zscircuits/zs1100a/Hardware/PCB/Gerber/ASSY/PCB-3D.jpg

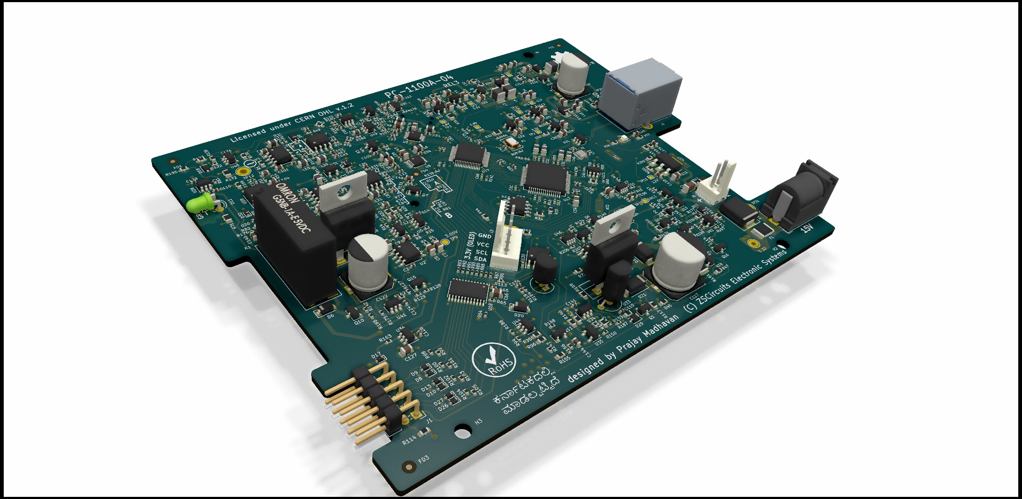
Hardware/PCB/Gerber/ASSY/PCB-3D.jpg
