zscircuits/zs1100a/Hardware/Enclosure/ReadMe.txt

Notes : 
1. The enclosure for the ZS1100A is designed using LibreCAD
2. The part used is a standard aluminum entrusion box from SZOMK with part No AK-C-C28
3. The front and back panels are cut using the .dxf file.
4. The logo is embossed on the top and bottom sides.
