zscircuits/zs1100a/Hardware/FTDI/ReadMe.txt

The template provided here can be used to program the EEPROM on the PC-1100-A PCB.
The FT_PROG utility from FTDI can be used to program the EEPROM using the template.
The template works only for a FT2232H device
