zscircuits/zs1100a/Docs/Certifications/ZS-1100-A-Conducted-Emissions-zsc-25-11-20-L.PDF

## PMM NARDA REPORT: zsc-25-11-20

************ Header Text ***************

Report issuing date : --/--/---- (dd/mm/yyyy)

Temperature | : --- °C
Humidity | : --- %

EUT
Manufacturer | :
Model | :
S/N | :
Notes | :

Testing Company
Address | :
Tel./Fax | :
E-mail | :
Web site | :
Operator | :

Receiver Details
Model | :
Brand | :
S/N | :
Last Calibration | :

Ancillary Details
Model | :
Brand | :
S/N | :
Last Calibration | :

************ End of Header ***************

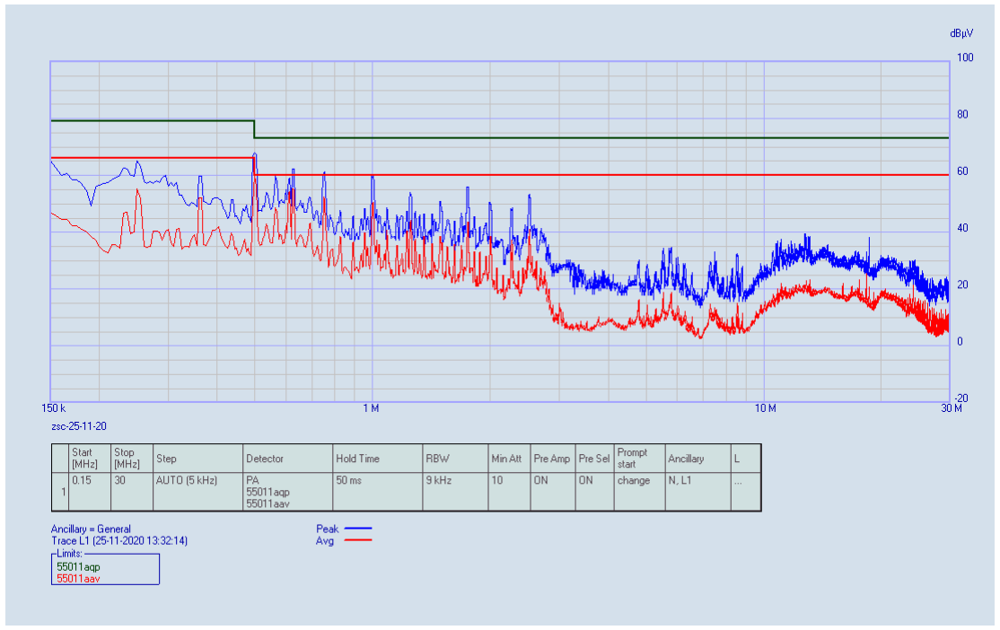
[picture p6: figure]

zsc-25-11-20 (L1) 25-11-2020 13:32:14 Rel. SW 2.37 (June 2019)
Rel. FW 2.64 23/08/18
Frequency | Peak | Avg
[MHz] | [dBµV] | [dBµV]
0.15 | 64.99 | 46.70
0.155 | 62.58 | 45.91
0.16 | 60.05 | 44.67
0.165 | 60.68 | 44.61
0.17 | 58.36 | 42.45
0.175 | 58.61 | 42.17
0.18 | 57.16 | 40.93
0.185 | 54.79 | 40.06
0.19 | 49.31 | 38.56
0.195 | 55.79 | 37.14
0.2 | 56.71 | 34.98
0.205 | 57.12 | 33.36
0.21 | 57.57 | 32.70
0.215 | 58.34 | 35.57
0.22 | 59.05 | 35.67
0.225 | 59.92 | 34.40
0.23 | 62.50 | 46.70
0.235 | 62.19 | 47.16
0.24 | 60.11 | 39.57
0.245 | 59.65 | 40.16
0.25 | 65.19 | 55.16
0.255 | 63.17 | 51.85
0.26 | 57.82 | 35.08
0.265 | 57.21 | 34.78
0.27 | 57.81 | 35.04
0.275 | 57.27 | 40.55
0.28 | 58.17 | 40.36
0.285 | 57.58 | 40.03
0.29 | 59.04 | 37.25
0.295 | 60.22 | 40.33
0.3 | 56.22 | 40.89
0.305 | 57.56 | 36.24
0.31 | 56.28 | 34.97
0.315 | 57.55 | 41.04
0.32 | 53.09 | 41.22
0.325 | 53.09 | 34.13
0.33 | 50.98 | 34.98
0.335 | 49.67 | 34.89
0.34 | 49.17 | 34.84
0.345 | 50.63 | 37.92
0.35 | 49.88 | 39.25
0.355 | 48.98 | 35.34
0.36 | 59.77 | 52.23
0.365 | 59.80 | 52.19
0.37 | 50.74 | 35.53
0.375 | 50.59 | 35.29
0.38 | 49.85 | 36.67
0.385 | 50.07 | 38.52
0.39 | 51.95 | 40.73
0.395 | 52.23 | 40.83
0.4 | 52.18 | 41.29
0.405 | 51.81 | 41.94
0.41 | 51.11 | 37.86
0.415 | 48.30 | 36.83
0.42 | 47.83 | 35.40
0.425 | 45.00 | 34.40
0.43 | 45.64 | 35.93

0.435 | 51.65 | 39.80
0.44 | 51.53 | 38.13
0.445 | 45.50 | 34.01
0.45 | 45.87 | 34.39
0.455 | 44.56 | 31.87
0.46 | 43.03 | 32.63
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
29.935 | 18.19 | 4.72
29.94 | 17.03 | 4.98
29.945 | 17.03 | 4.90
29.95 | 18.20 | 5.11
29.955 | 17.04 | 4.81
29.96 | 17.04 | 4.93
29.965 | 19.22 | 4.99
29.97 | 20.15 | 5.01
29.975 | 20.98 | 8.35
29.98 | 18.21 | 7.40
29.985 | 17.06 | 5.80
29.99 | 19.24 | 6.08
29.995 | 19.24 | 8.61
30 | 19.25 | 8.31
