zscircuits/zs1100a/Docs/Certifications/ZS-1100-A-Conducted-Emissions-zsc-25-11-20-N.PDF

## PMM NARDA REPORT: zsc-25-11-20

************ Header Text ***************

Report issuing date : --/--/---- (dd/mm/yyyy)

Temperature | : --- °C
Humidity | : --- %

EUT
Manufacturer | :
Model | :
S/N | :
Notes | :

Testing Company
Address | :
Tel./Fax | :
E-mail | :
Web site | :
Operator | :

Receiver Details
Model | :
Brand | :
S/N | :
Last Calibration | :

Ancillary Details
Model | :
Brand | :
S/N | :
Last Calibration | :

************ End of Header ***************

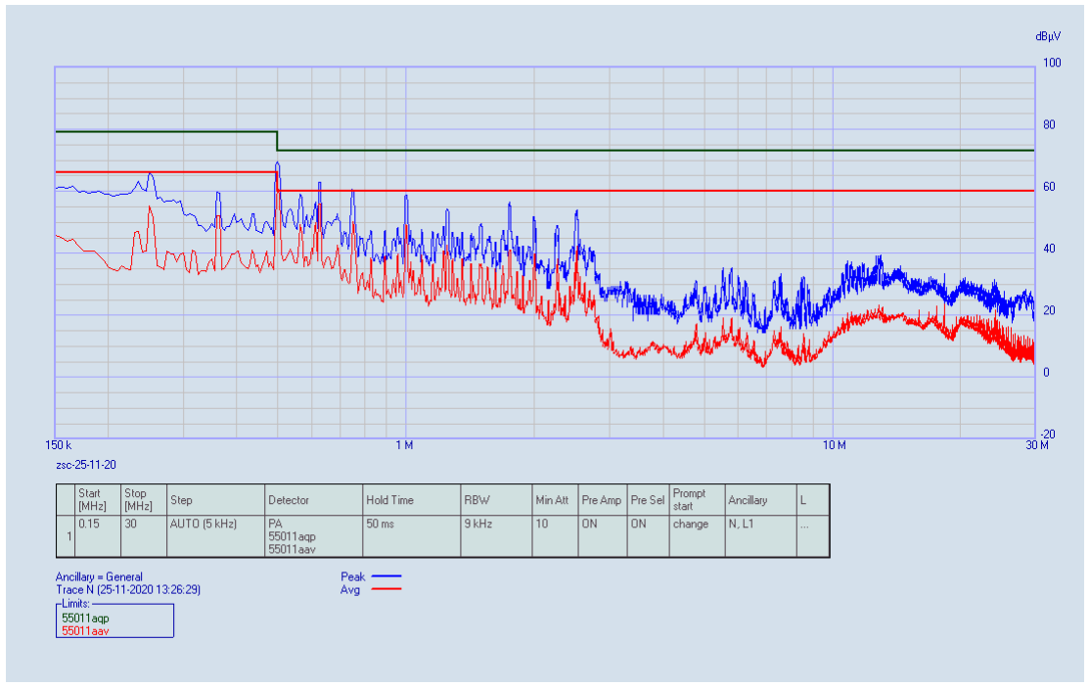
[picture p7: figure]

zsc-25-11-20 (N) 25-11-2020 13:26:29 Rel. SW 2.37 (June 2019)
Rel. FW 2.64 23/08/18
Frequency | Peak | Avg
[MHz] | [dBµV] | [dBµV]
0.15 | 60.93 | 45.91
0.155 | 61.37 | 45.27
0.16 | 61.17 | 43.98
0.165 | 61.50 | 44.68
0.17 | 59.70 | 42.23
0.175 | 60.21 | 40.60
0.18 | 59.34 | 40.73
0.185 | 59.90 | 40.67
0.19 | 60.20 | 39.22
0.195 | 59.17 | 37.40
0.2 | 59.16 | 35.53
0.205 | 58.63 | 34.61
0.21 | 58.85 | 34.37
0.215 | 59.26 | 35.82
0.22 | 59.25 | 35.12
0.225 | 59.50 | 34.71
0.23 | 61.14 | 46.82
0.235 | 63.19 | 46.94
0.24 | 60.54 | 40.41
0.245 | 60.22 | 40.61
0.25 | 66.45 | 55.29
0.255 | 64.58 | 51.43
0.26 | 57.63 | 35.95
0.265 | 58.28 | 35.59
0.27 | 56.68 | 34.76
0.275 | 57.00 | 40.83
0.28 | 56.88 | 39.92
0.285 | 57.32 | 39.81
0.29 | 56.37 | 37.12
0.295 | 56.94 | 39.74
0.3 | 52.84 | 40.20
0.305 | 52.28 | 34.67
0.31 | 52.83 | 33.68
0.315 | 52.61 | 40.97
0.32 | 51.83 | 40.54
0.325 | 49.11 | 33.18
0.33 | 49.10 | 34.38
0.335 | 47.92 | 34.52
0.34 | 47.21 | 34.14
0.345 | 48.11 | 37.31
0.35 | 49.73 | 38.27
0.355 | 48.46 | 34.31
0.36 | 59.64 | 52.08
0.365 | 59.48 | 52.12
0.37 | 48.71 | 34.60
0.375 | 47.38 | 35.38
0.38 | 48.61 | 36.25
0.385 | 48.69 | 37.93
0.39 | 50.36 | 39.73
0.395 | 52.74 | 39.67
0.4 | 50.06 | 40.51
0.405 | 50.27 | 40.86
0.41 | 51.11 | 36.82
0.415 | 49.17 | 36.26
0.42 | 48.30 | 35.68
0.425 | 47.43 | 35.10
0.43 | 48.56 | 36.80

0.435 | 52.70 | 40.95
0.44 | 52.65 | 39.33
0.445 | 47.31 | 35.66
0.45 | 47.21 | 36.14
0.455 | 46.66 | 33.68
0.46 | 46.44 | 35.49
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
29.935 | 21.71 | 4.89
29.94 | 21.71 | 5.20
29.945 | 21.71 | 5.21
29.95 | 23.06 | 4.83
29.955 | 22.42 | 5.07
29.96 | 22.42 | 5.39
29.965 | 21.72 | 5.20
29.97 | 21.73 | 4.96
29.975 | 22.43 | 5.49
29.98 | 21.73 | 5.44
29.985 | 22.44 | 6.06
29.99 | 21.74 | 7.41
29.995 | 23.08 | 8.33
30 | 23.09 | 8.94
