zscircuits/zs1100a/Hardware/PCB/SCH-BOM-ASSY/PC-1100X-SCH.pdf

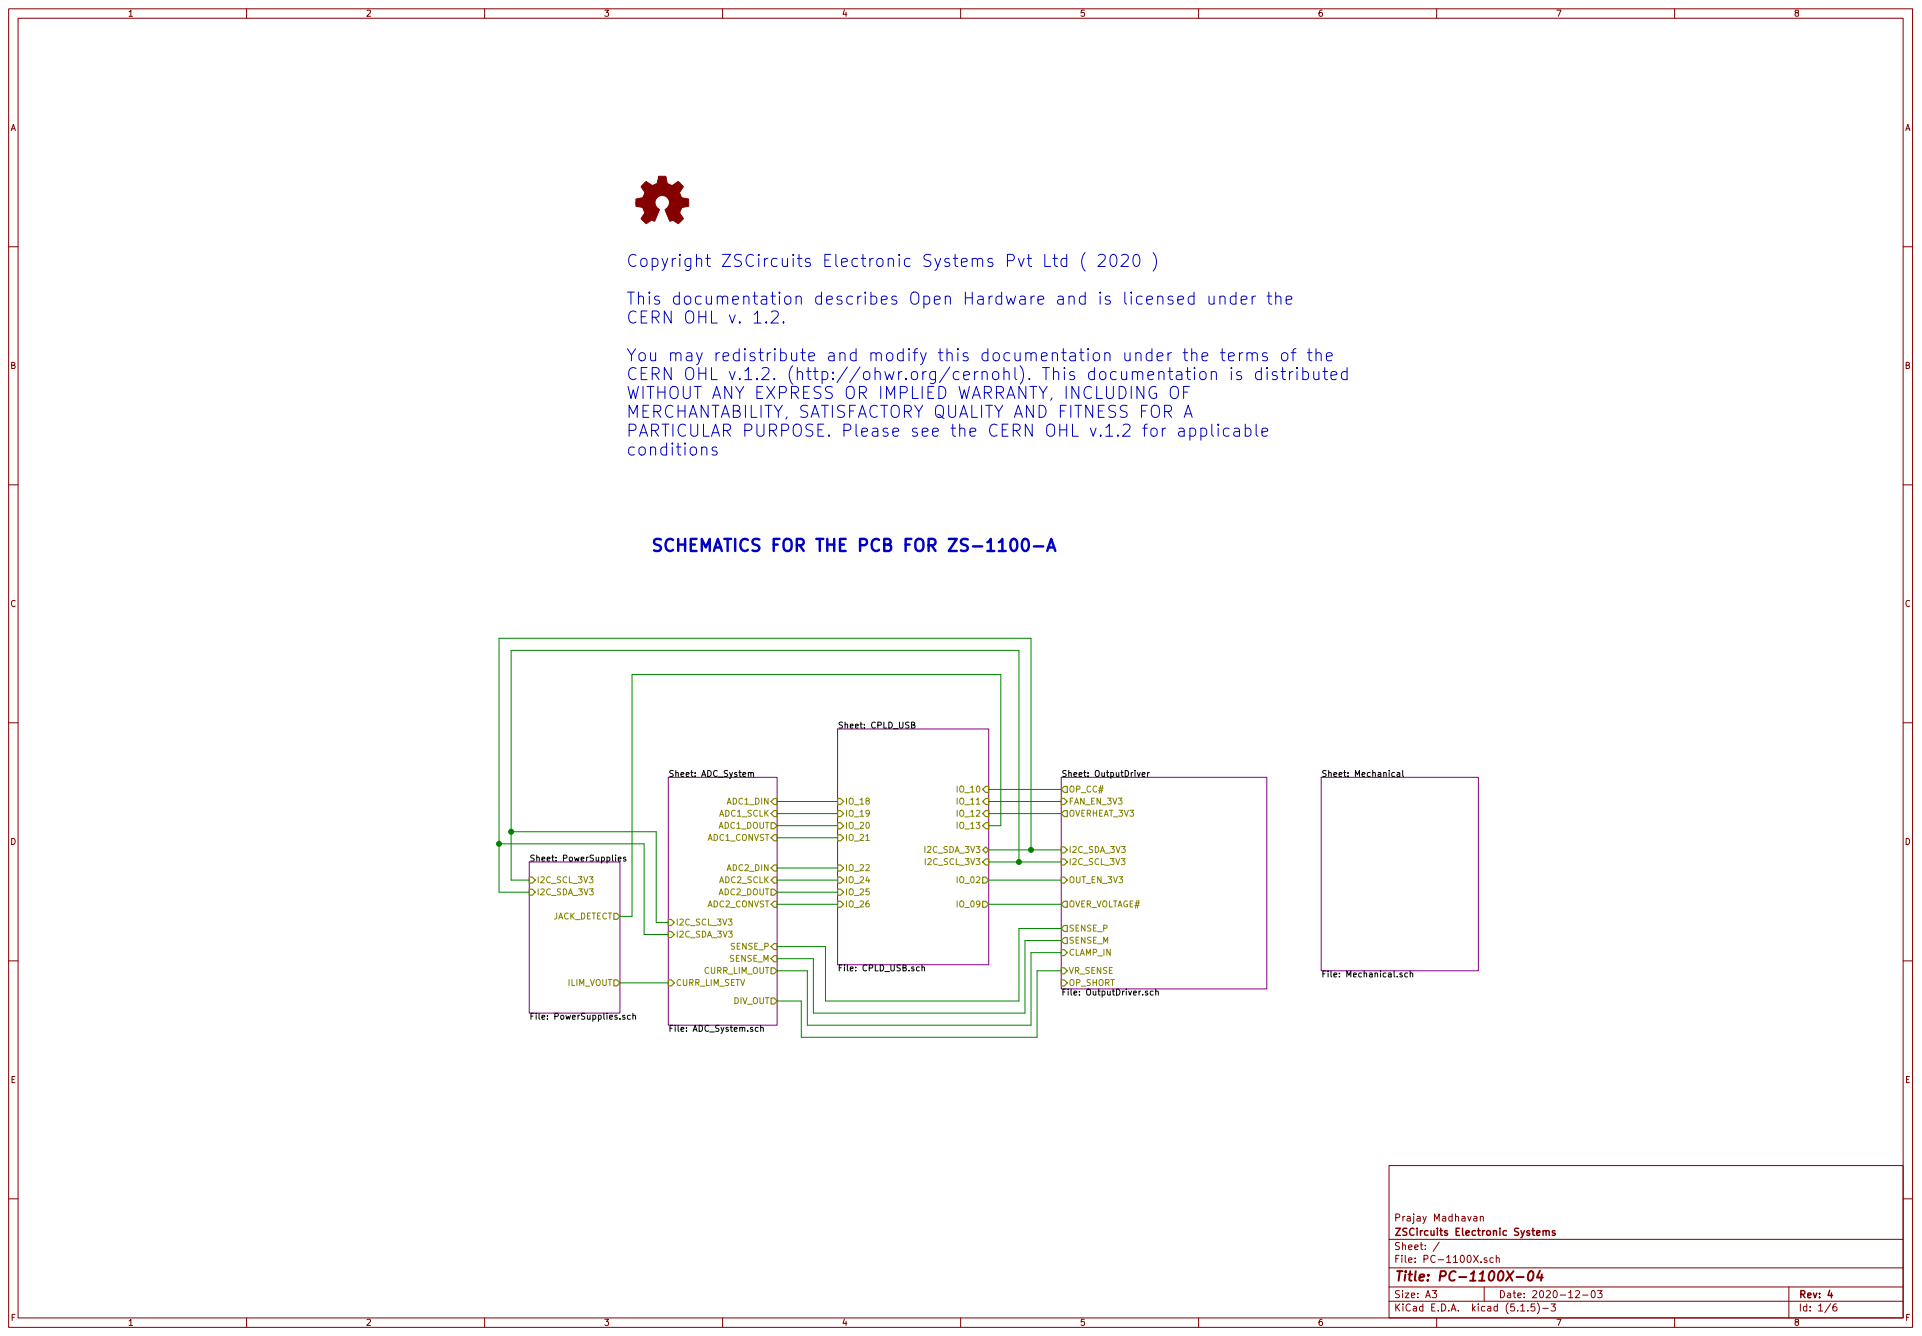
[picture p8: page 1]

I2C_SDA_3V3 DIV_OUT Copyright ZSCircuits Electronic Systems Pvt Ltd ( 2020 )

This documentation describes Open Hardware and is licensed under the
CERN OHL v. 1.2.

You may redistribute and modify this documentation under the terms of the
CERN OHL v.1.2. (http://ohwr.org/cernohl). This documentation is distributed
WITHOUT ANY EXPRESS OR IMPLIED WARRANTY, INCLUDING OF
MERCHANTABILITY, SATISFACTORY QUALITY AND FITNESS FOR A
PARTICULAR PURPOSE. Please see the CERN OHL v.1.2 for applicable
conditions

SCHEMATICS FOR THE PCB FOR ZS-1100-A

Prajay Madhavan
File: PC-1100X.sch Sheet: / ZSCircuits Electronic Systems

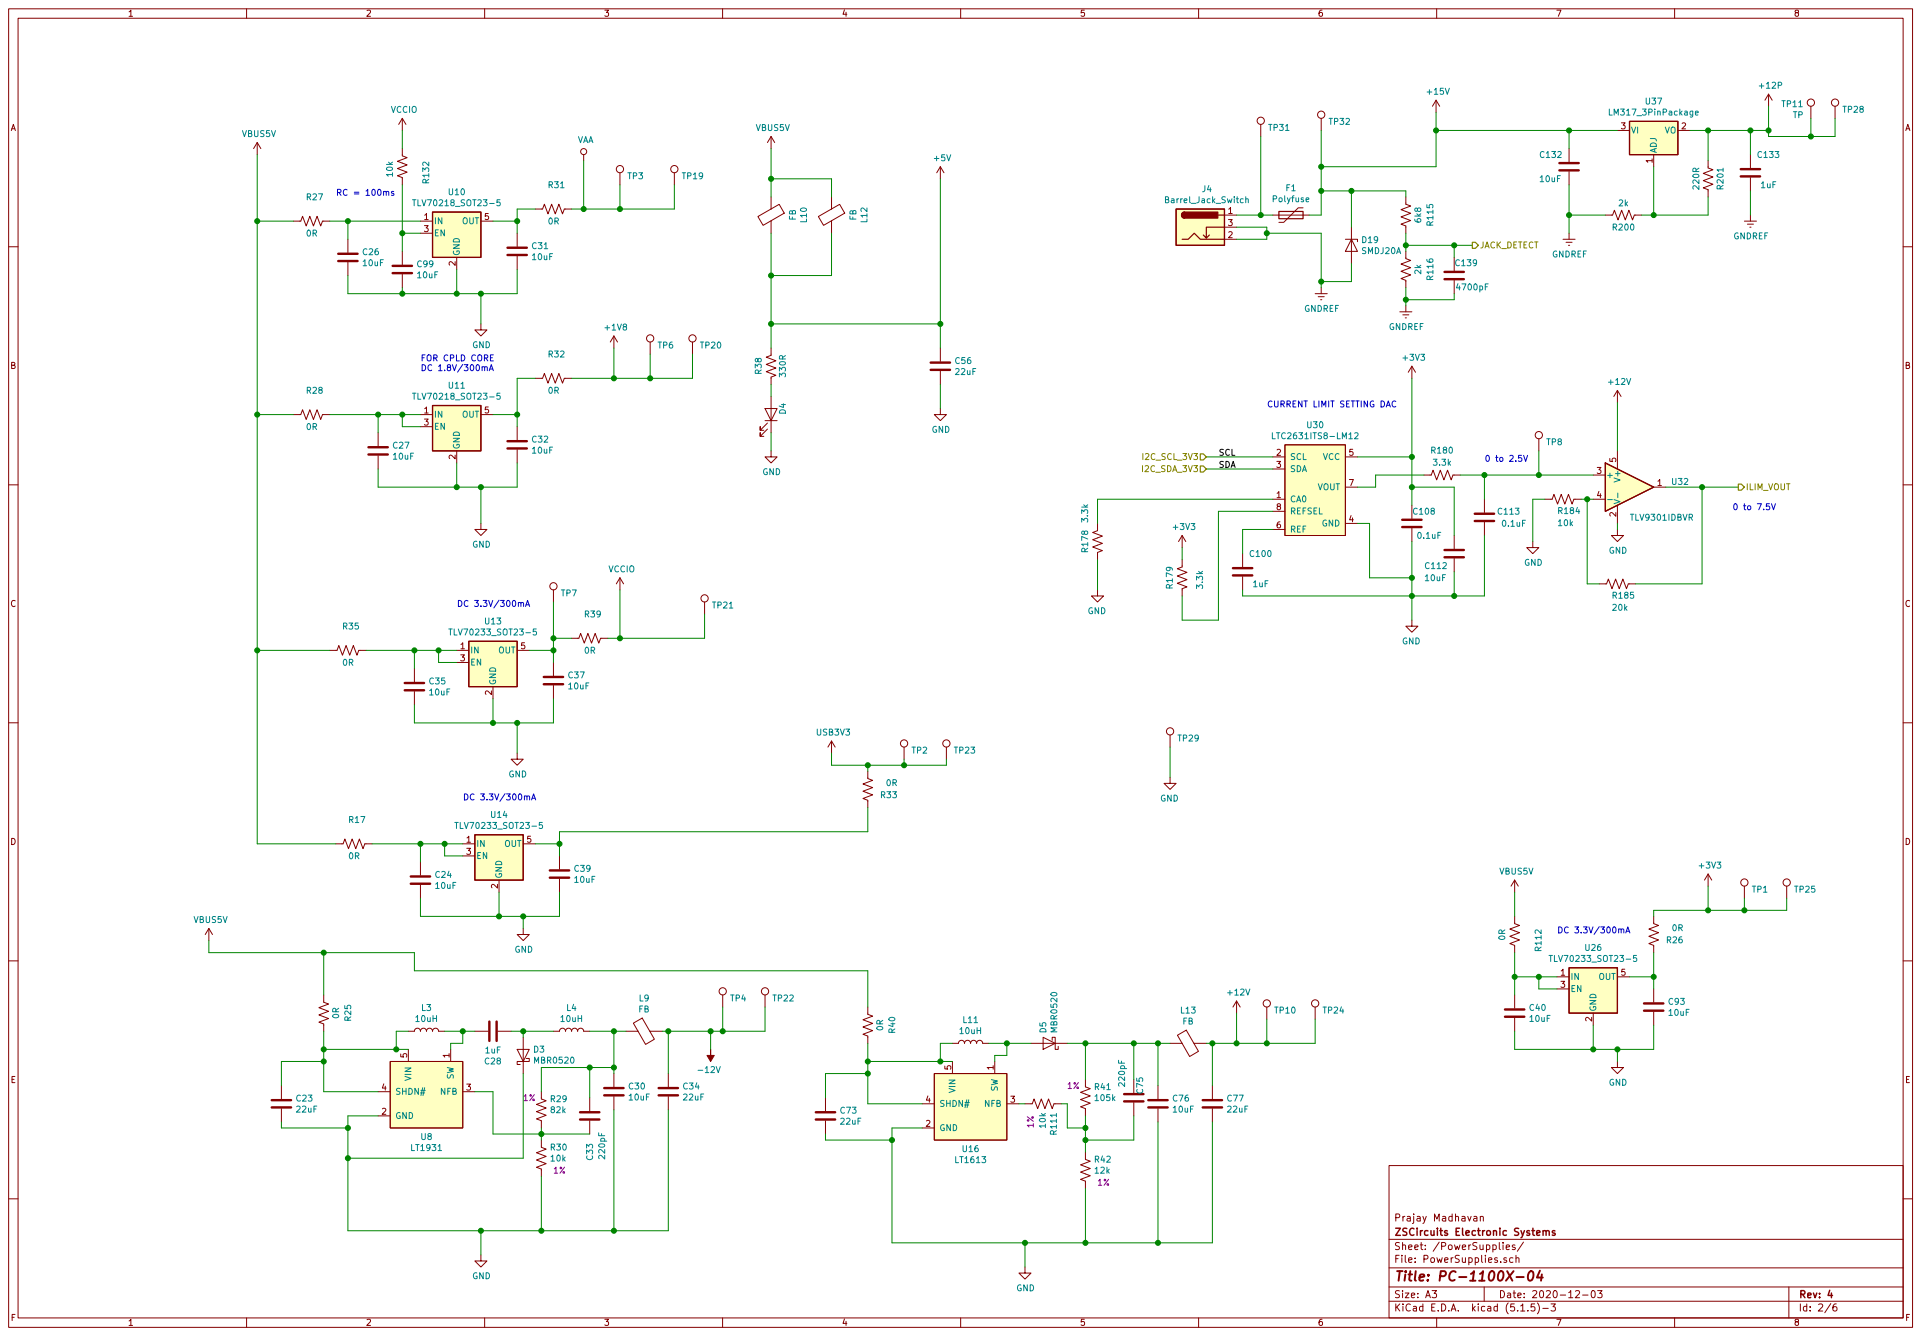
[picture p9: page 2]

1 GND 2 NFB 3 SHDN# 4 VIN

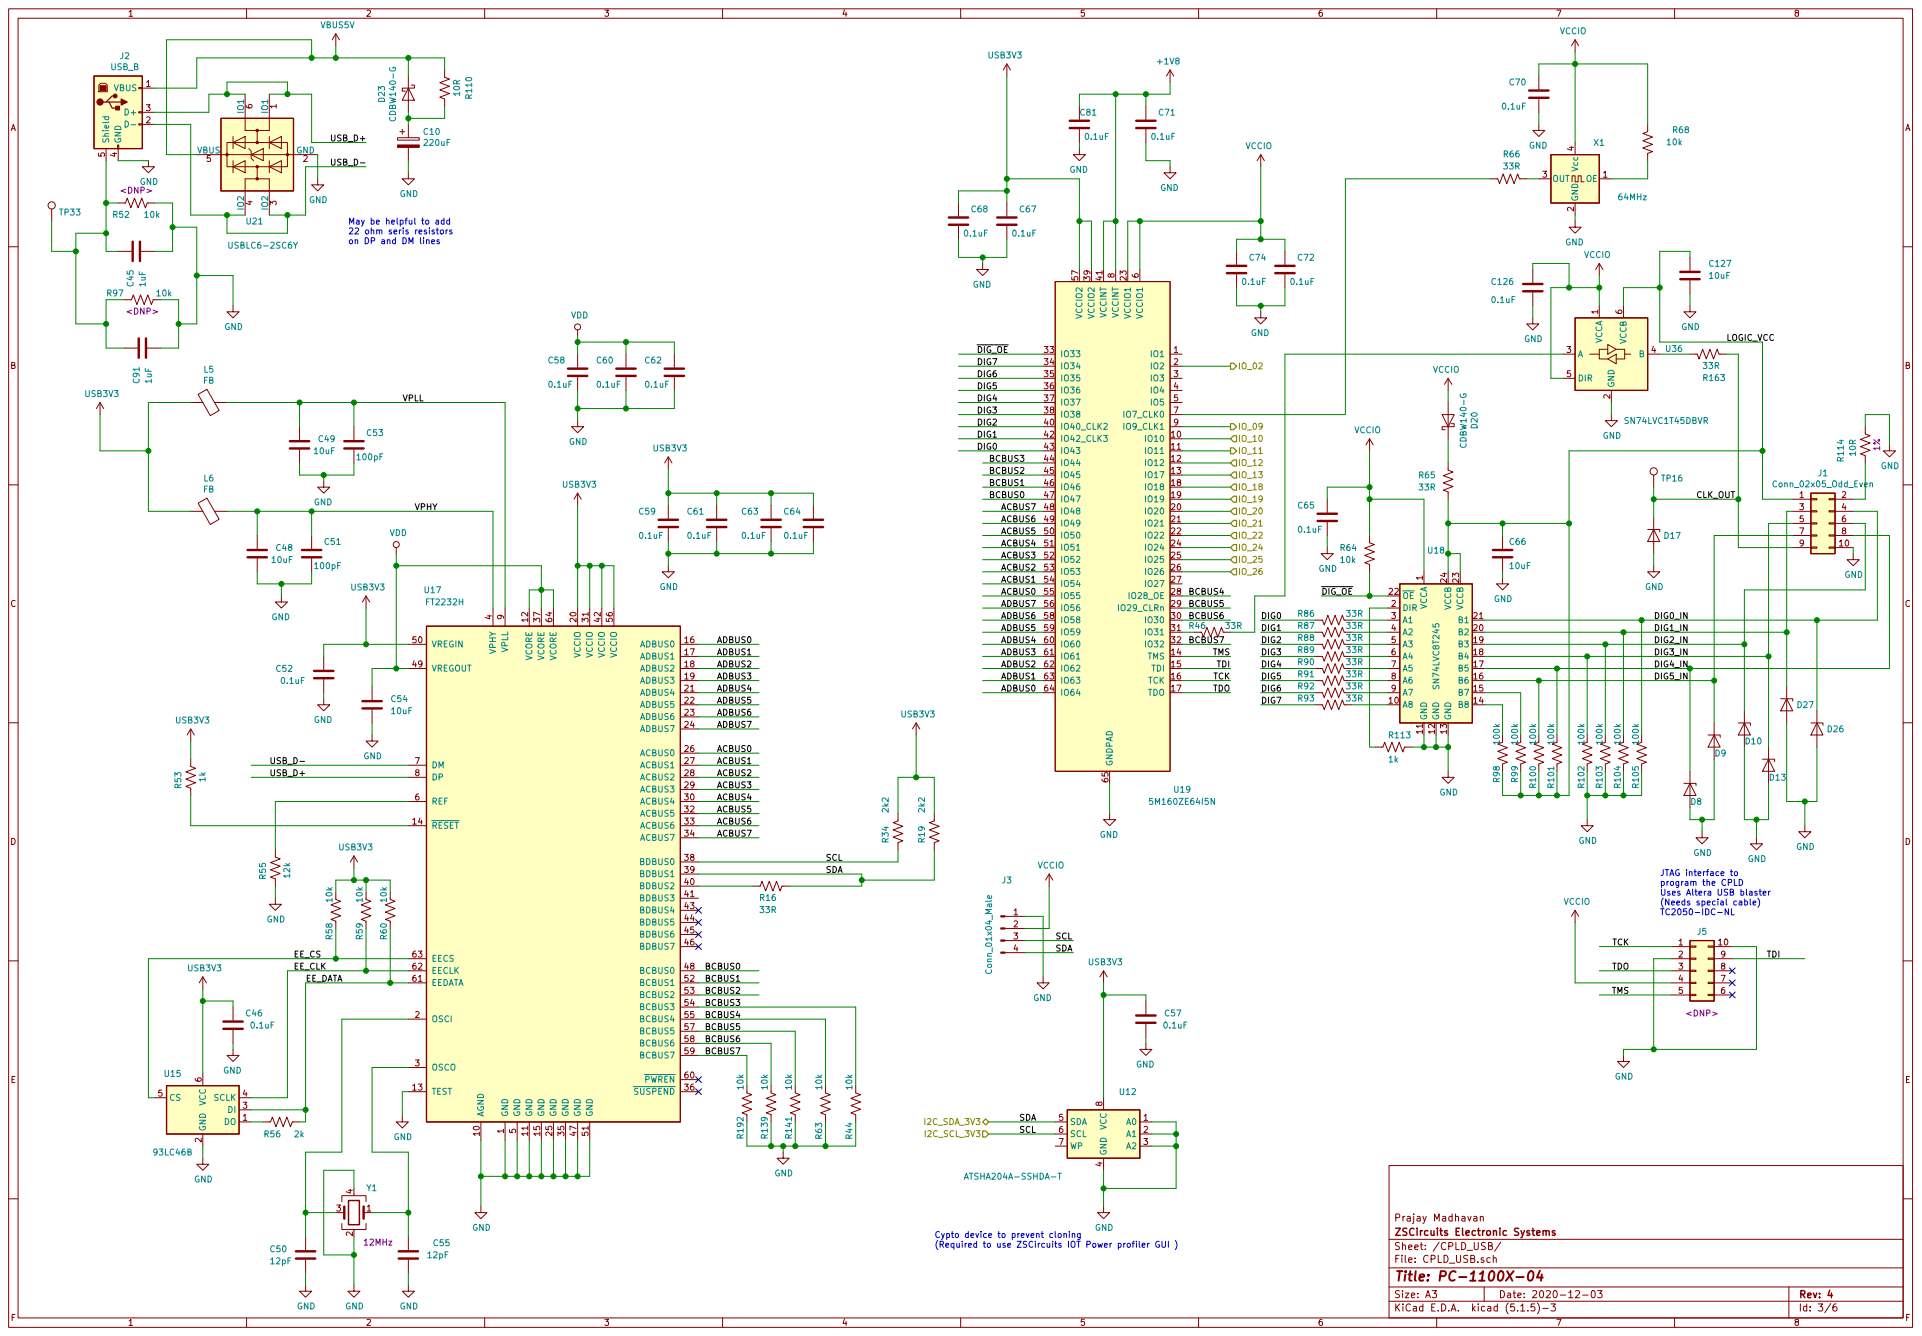
[picture p10: page 3]

May be helpful to add
22 ohm seris resistors on DP and DM lines

1 A8 10 GND 11 GND 12 GND 13 B8 14 B7 15 B6 16 B5 17 B4 18 B3 19 DIR 2 B2 20 B1 21 OE 22 VCCB 23 VCCB 24 A1 3 A2 4 A3 5 A4 6 A5 7 A6 8 A7 9 U18SN74LVC8T245

1 AGND 10 GND 11 VCORE 12 TEST 13 RESET 14 GND 15 ADBUS0 16 ADBUS1 17 ADBUS2 18 ADBUS3 19 OSCI 2 VCCIO 20 ADBUS4 21 ADBUS5 22 ADBUS6 23 ADBUS7 24 GND 25 ACBUS0 26 ACBUS1 27 ACBUS2 28 ACBUS3 29 OSCO 3 ACBUS4 30 VCCIO 31 ACBUS5 32 ACBUS6 33 ACBUS7 34 GND 35 SUSPEND 36 VCORE 37 BDBUS0 38 BDBUS1 39 VPHY

4 BDBUS2 40 BDBUS3 41 VCCIO 42 BDBUS4 43 BDBUS5 44 BDBUS6 45 BDBUS7 46 GND 47 BCBUS0 48 VREGOUT 49 GND

5 VREGIN 50 GND 51 BCBUS1 52 BCBUS2 53 BCBUS3 54 BCBUS4 55 VCCIO 56 BCBUS5 57 BCBUS6 58 BCBUS7 59 REF 6 PWREN 60 EEDATA 61 EECLK 62 EECS 63 VCORE 64 DM 7 DP 8 VPLL

JTAG interface to program the CPLD

Uses Altera USB blaster
(Needs special cable) TC2050-IDC-NL

2 DI 3 SCLK 4 CS 5 VCC

4 SDA 5 SCL 6 WP 7 VCC

Cypto device to prevent cloning
(Required to use ZSCircuits IOT Power profiler GUI )

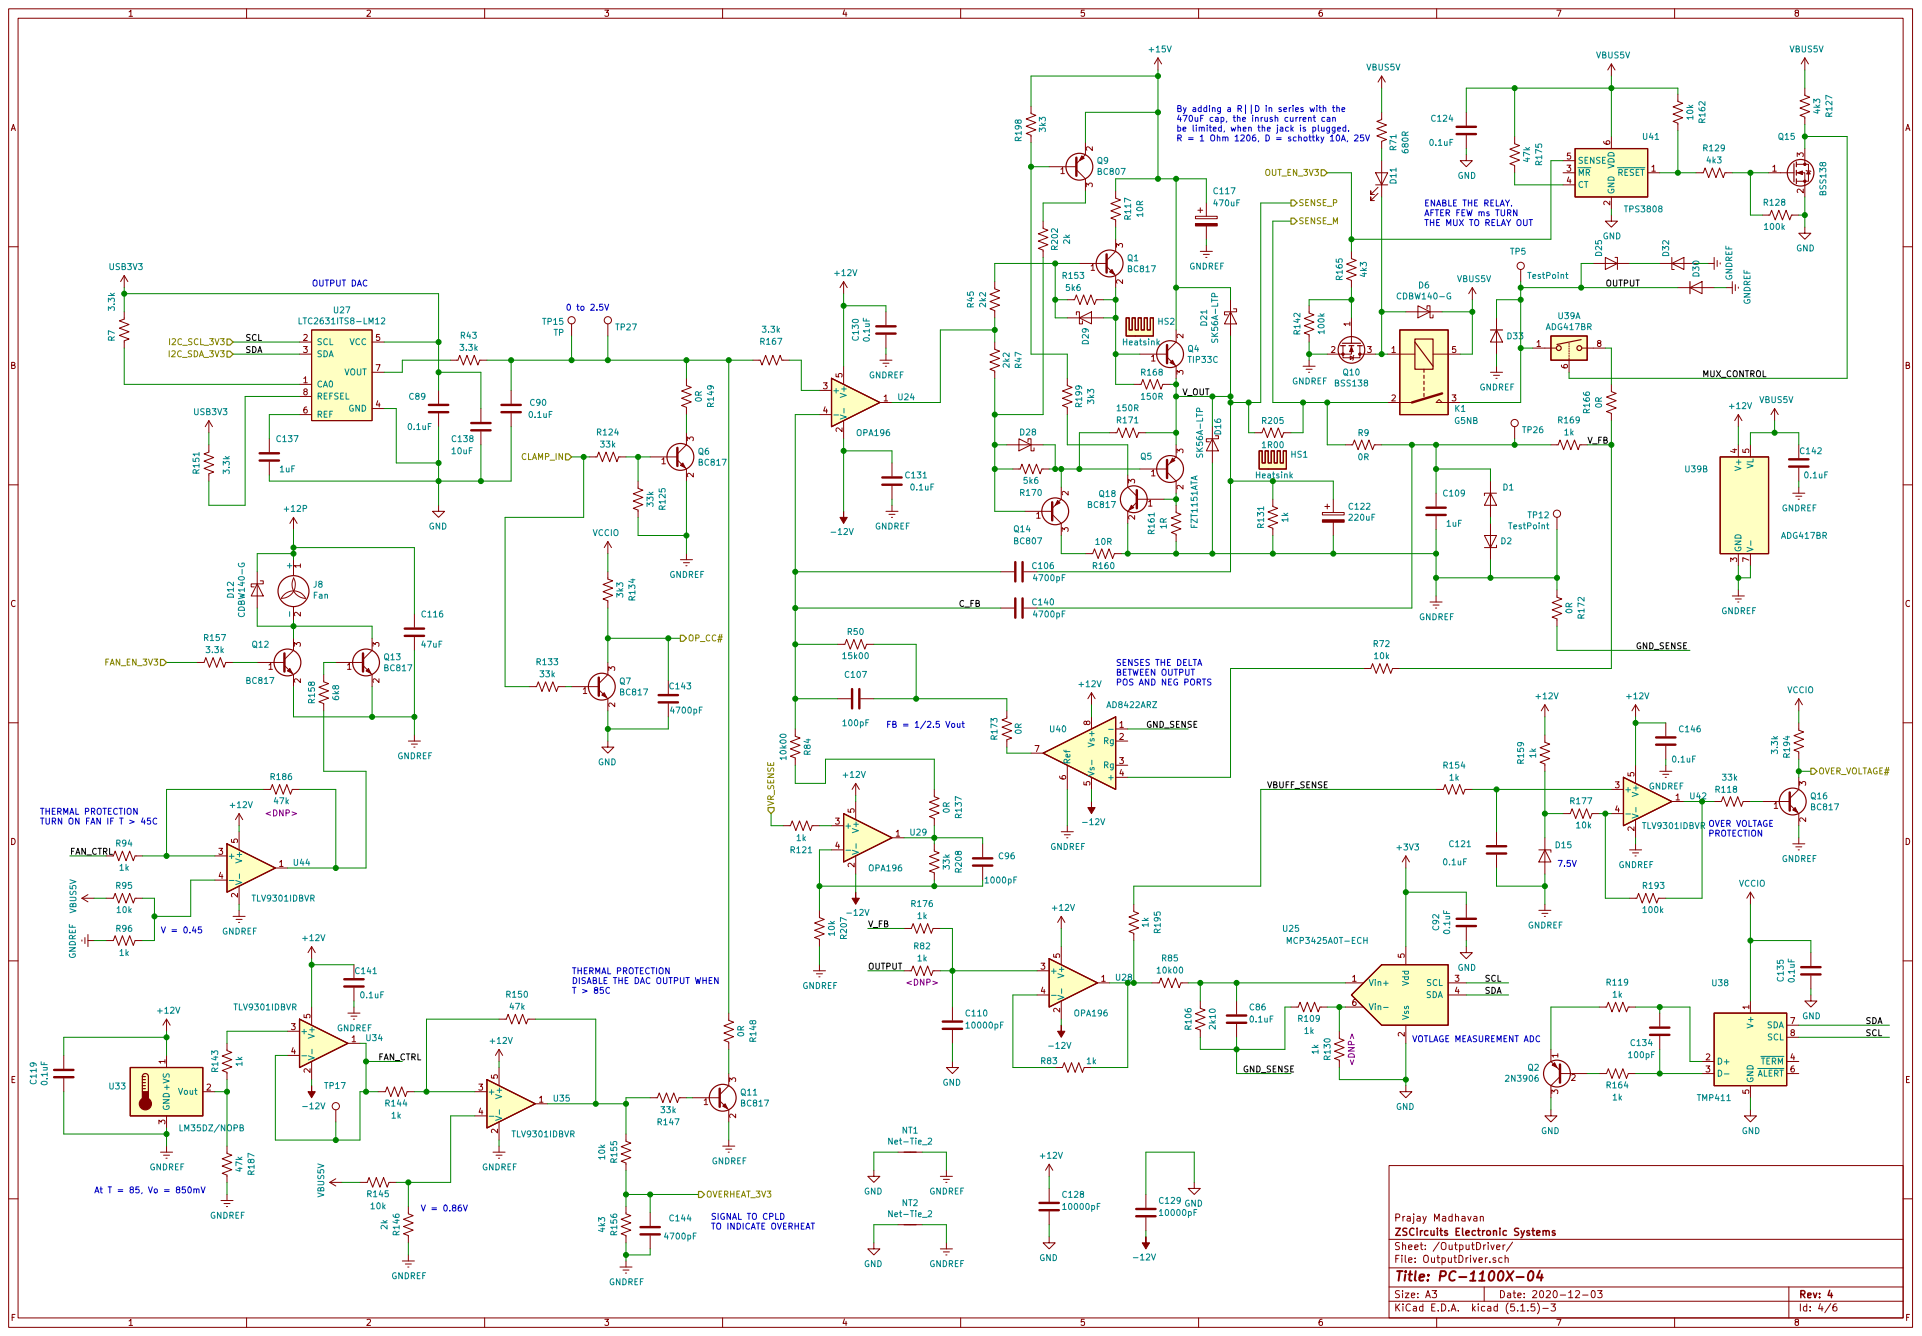
[picture p11: page 4]

By adding a R||D in series with the
470uF cap, the inrush current can
be limited, when the jack is plugged.
R = 1 Ohm 1206, D = schottky 10A, 25V

2 MR 3 CT 4 SENSE 5 VDD

ENABLE THE RELAY. AFTER FEW ms TURN

THE MUX TO RELAY OUT

BETWEEN OUTPUT POS AND NEG PORTS

THERMAL PROTECTION
TURN ON FAN IF T > 45C

DISABLE THE DAC OUTPUT WHEN

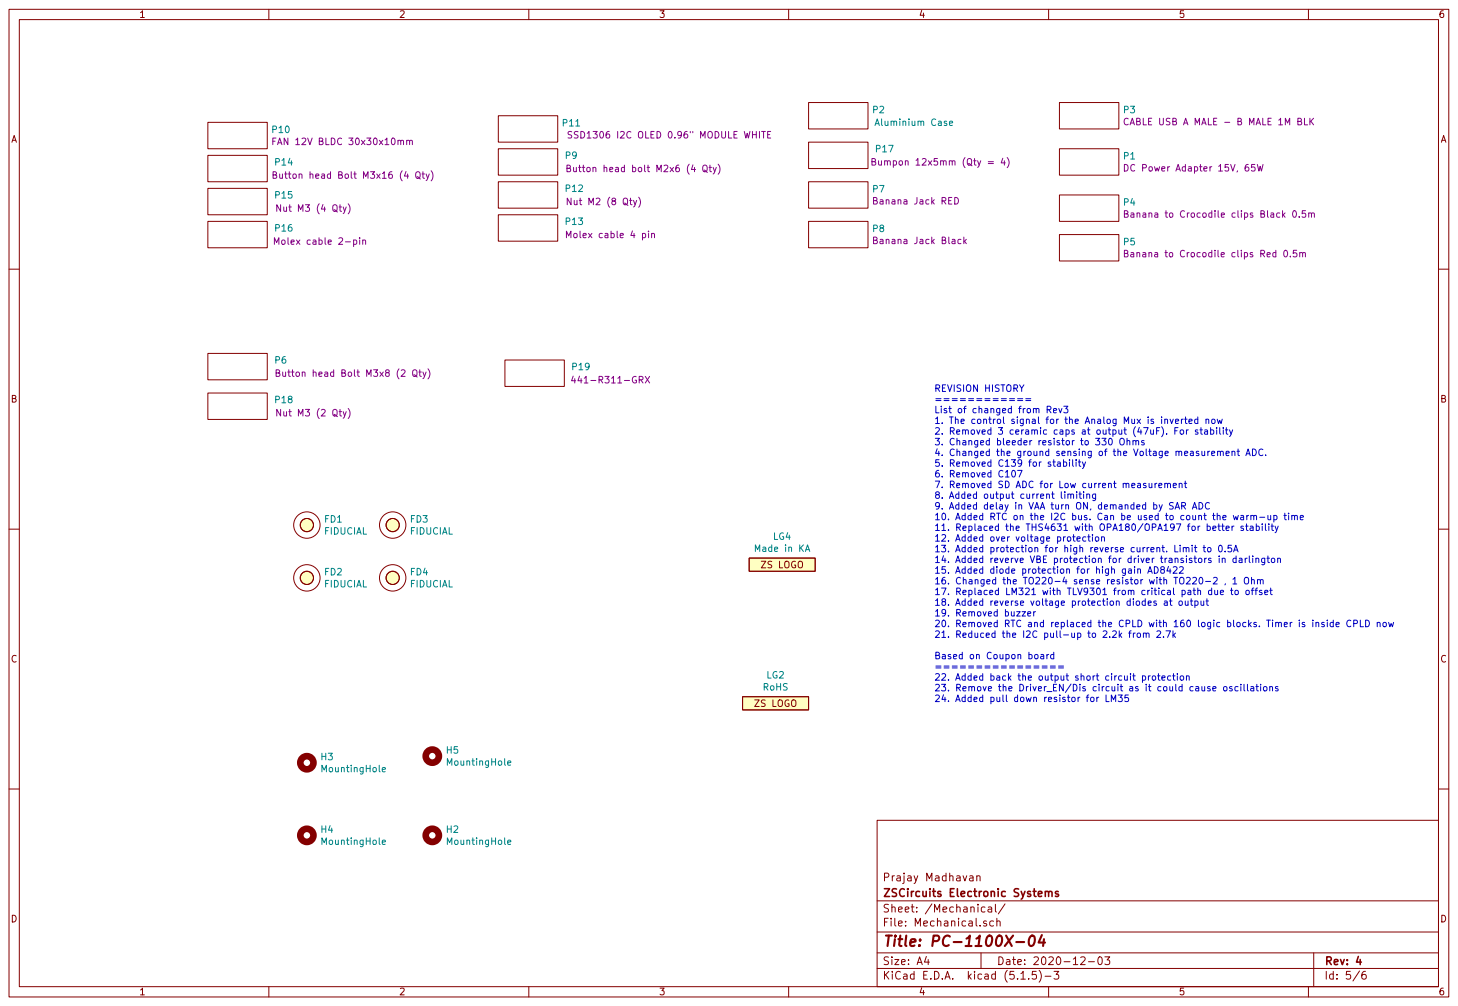
[picture p12: page 5]

P3CABLE USB A MALE - B MALE 1M BLK

SSD1306 I2C OLED 0.96" MODULE WHITE P10FAN 12V BLDC 30x30x10mm

P4 Banana to Crocodile clips Black 0.5m

P5 Banana to Crocodile clips Red 0.5m

List of changed from Rev3
1. The control signal for the Analog Mux is inverted now
2. Removed 3 ceramic caps at output (47uF). For stability
3. Changed bleeder resistor to 330 Ohms
4. Changed the ground sensing of the Voltage measurement ADC.
5. Removed C139 for stability 6. Removed C107

7. Removed SD ADC for Low current measurement 8. Added output current limiting

9. Added delay in VAA turn ON, demanded by SAR ADC
10. Added RTC on the I2C bus. Can be used to count the warm-up time
11. Replaced the THS4631 with OPA180/OPA197 for better stability
12. Added over voltage protection
13. Added protection for high reverse current. Limit to 0.5A
14. Added reverve VBE protection for driver transistors in darlington
15. Added diode protection for high gain AD8422
16. Changed the TO220-4 sense resistor with TO220-2 , 1 Ohm
17. Replaced LM321 with TLV9301 from critical path due to offset
18. Added reverse voltage protection diodes at output 19. Removed buzzer 20. Removed RTC and replaced the CPLD with 160 logic blocks. Timer is inside CPLD now

21. Reduced the I2C pull-up to 2.2k from 2.7k

Based on Coupon board ================

22. Added back the output short circuit protection
23. Remove the Driver_EN/Dis circuit as it could cause oscillations 24. Added pull down resistor for LM35

Prajay Madhavan
File: Mechanical.sch Sheet: /Mechanical/ ZSCircuits Electronic Systems

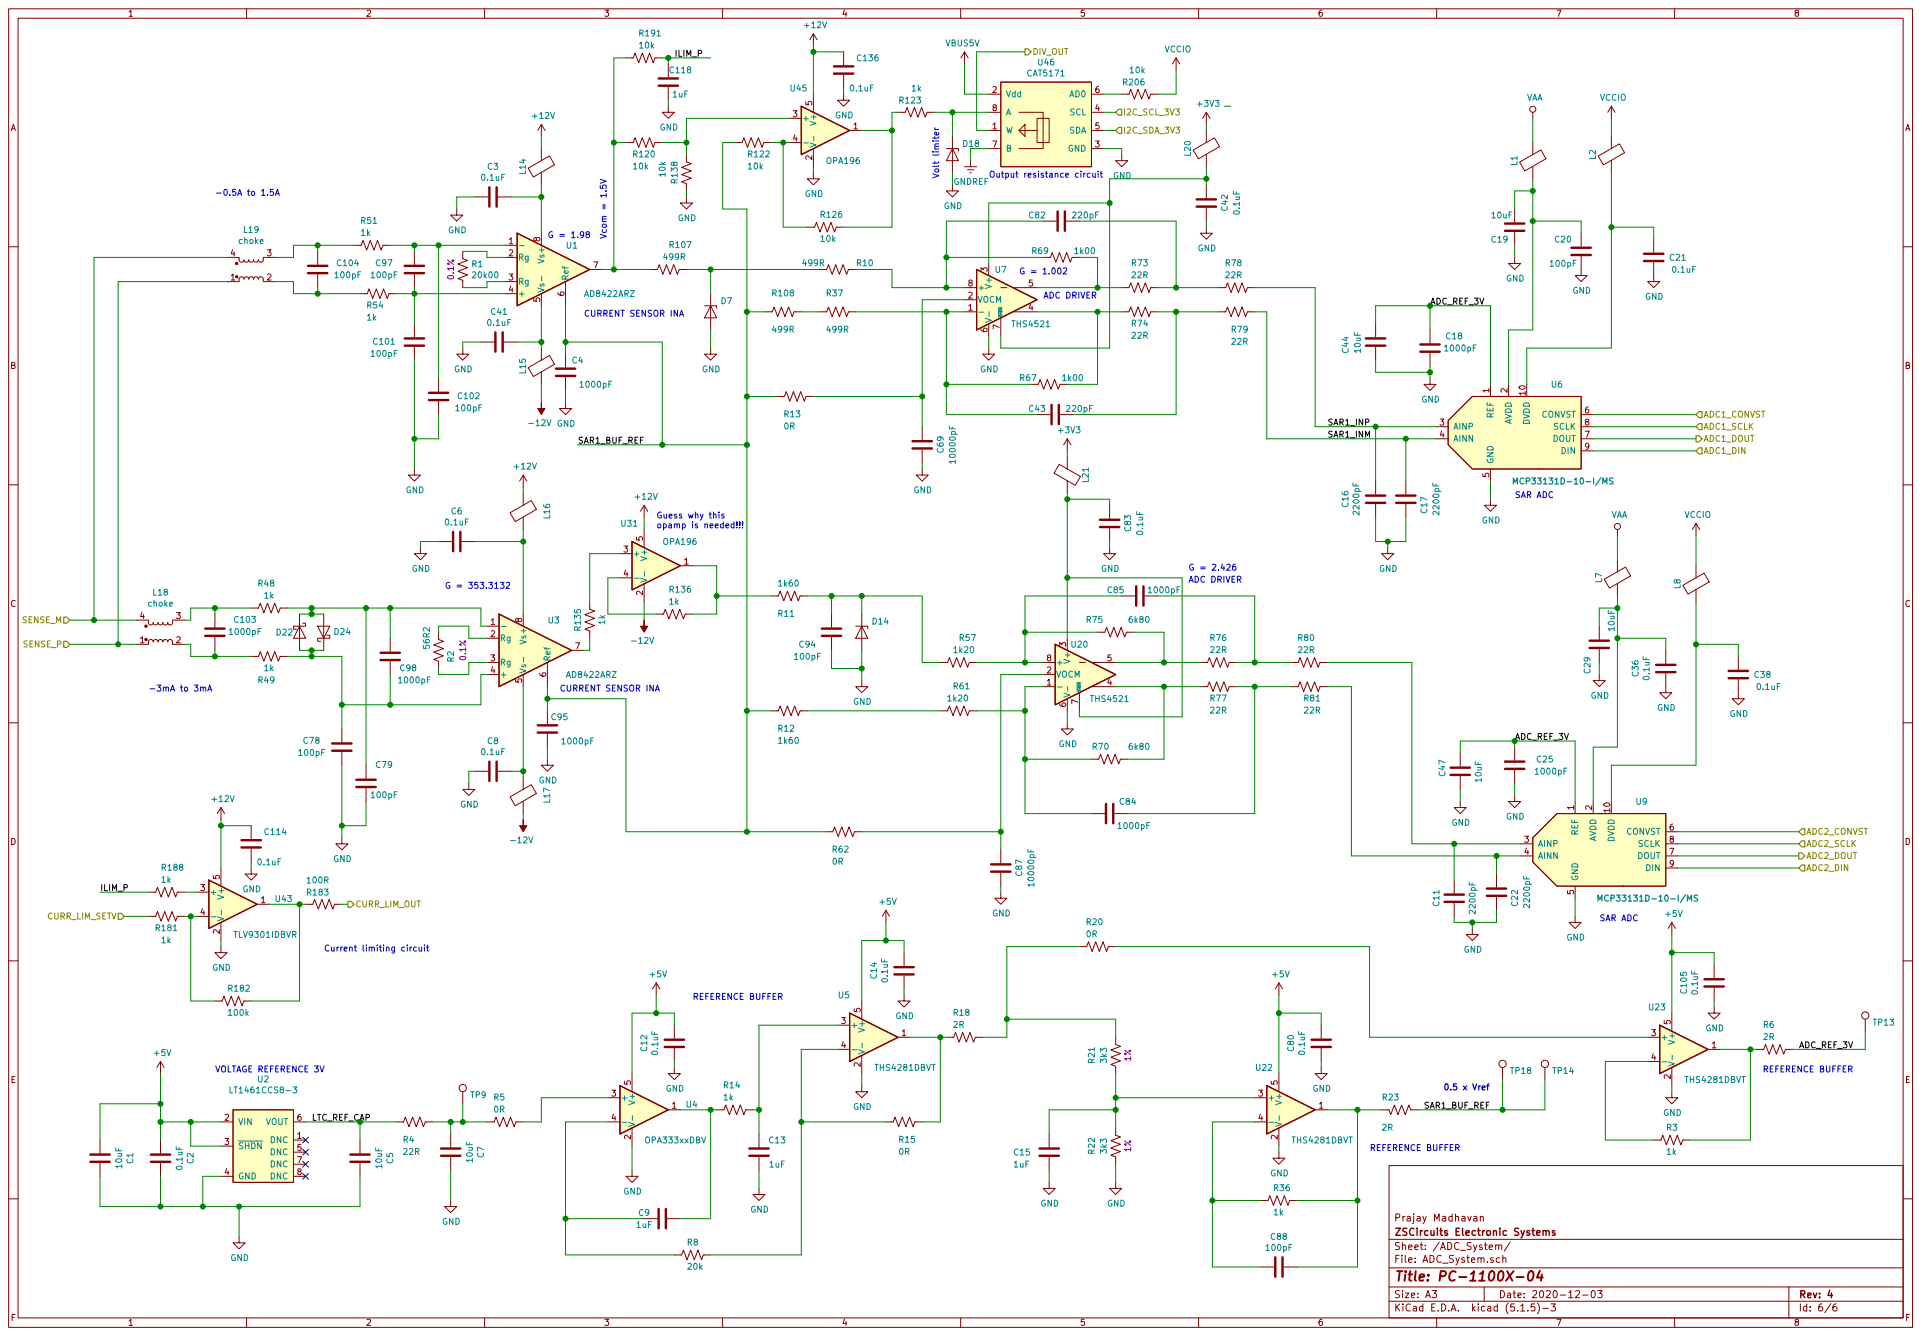
[picture p13: page 6]

5 CONVST 6 DOUT 7 SCLK 8 DIN 9 U6 MCP33131D-10-I/MS C3

VOLTAGE REFERENCE 3V Current limiting circuit
