zscircuits/zs1100a/Hardware/PCB/KiCAD/PC-1100X_bom_4.csv

Component | References | Value | Footprint | Quantity Per PCB | Description | Part | MPN | Manufacturer | ALT_PN | Assembly | Tolerance | Frequency
1 | C2 C3 C6 C8 C12 C14 C21 C36 C38 C41 C42 C46 C52 C57 C58 C59 C60 C61 C62 C63 C64 C65 C67 C68 C70 C71 C72 C74 C80 C81 C83 C86 C89 C90 C92 C105 C108 C113 C114 C119 C121 C124 C126 C130 C131 C135 C136 C141 C142 C146 | 0.1uF | C_0402_1005Metric | 50 | Unpolarized capacitor | C | TMK105B7104MV-FR | Samsung
2 | C69 C87 C110 C128 C129 | 10000pF | C_0402_1005Metric | 5 | Unpolarized capacitor | C | TMF105B7103MVHF
3 | C4 C18 C25 C84 C85 C95 C96 C98 C103 | 1000pF | C_0402_1005Metric | 9 | Unpolarized capacitor | C | C0402C102J5RAC7411 | Kemet
4 | C78 C79 C97 C101 C102 C104 C107 | 100pF | C_0603_1608Metric | 7 | Unpolarized capacitor | C | C0603C101K5RACTU | Kemet
5 | C20 C51 C53 C88 C94 C134 | 100pF | C_0402_1005Metric | 6 | Unpolarized capacitor | C | C0402C101J3GACTU | Kemet
6 | C1 C5 C7 C19 C24 C26 C27 C29 C30 C31 C32 C35 C37 C39 C40 C44 C47 C48 C49 C54 C66 C76 C93 C99 C112 C127 C132 C138 | 10uF | C_0805_2012Metric | 28 | Unpolarized capacitor | C | TMK212BBJ106MGHT
7 | C50 C55 | 12pF | C_0402_1005Metric | 2 | Unpolarized capacitor | C | GJM1555C1H120FB01D
8 | C9 C13 C15 C28 C45 C91 C100 C109 C118 C133 C137 | 1uF | C_0603_1608Metric | 11 | Unpolarized capacitor | C | TMK107BJ105KA-T |  | CL10A105KA8NNNC
9 | C11 C16 C17 C22 | 2200pF | C_0402_1005Metric | 4 | Unpolarized capacitor | C | C0402C222J3GACTU
10 | C33 C43 C75 C82 | 220pF | C_0402_1005Metric | 4 | Unpolarized capacitor | C | CC0402JRNPO8BN221
11 | C10 C122 | 220uF | CP_Elec_8x10 | 2 | Polarized capacitor | CP | UWT1E221MNL1GS
12 | C23 C34 C56 C73 C77 | 22uF | C_0805_2012Metric | 5 | Unpolarized capacitor | C | GRM21BR61E226ME44L
13 | C106 C139 C140 C143 C144 | 4700pF | C_0603_1608Metric | 5 | Unpolarized capacitor | C | C0603C472K5RACTU | Kemet
14 | C117 | 470uF | CP_Elec_10x10 | 1 | Polarized capacitor | CP | UWT1E471MNL1GS
15 | C116 | 47uF | C_1206_3216Metric | 1 | Unpolarized capacitor | C | EMK316BBJ476ML-T
16 | D30 D33 | 1N4148WSF-7 | D_SOD-323 | 2 | 75V 0.15A Fast switching Diode, SOD-323 | 1N4148WS | 1N4148WSF-7
17 | D6 D12 D20 D23 | CDBW140-G | D_SOD-123 | 4 | Schottky diode | D_Schottky | CDBW140-G
18 | D22 D24 D28 D29 | D_Schottky | D_SOD-323 | 4 | Schottky diode | D_Schottky | BAT54HT1G
19 | D1 D2 D8 D9 D10 D13 D17 D25 D26 D27 D32 | ESD5Z12T1G | D_SOD-523 | 11 | Zener diode | D_Zener | ESD5Z12T1G
20 | D4 | LED | LED_0805_2012Metric | 1 | Light emitting diode | LED | LTST-C170KRKT
21 | D11 | LED GREEN | LED_D3.0mm | 1 | Light emitting diode | LED | 151031VS06000
22 | D3 D5 | MBR0520 | D_SOD-123 | 2 | 20V 0.5A Schottky Power Rectifier Diode, SOD-123 | MBR0520 | MBR0520LT3G | MC Semiconductor
23 | D14 | MM3Z4V3T1G | D_SOD-323F | 1 | Zener diode | D_Zener | MM3Z4V3T1G
24 | D18 | MM3Z4V7ST1G | D_SOD-323F | 1 | Zener diode | D_Zener | MM3Z4V7ST1G
25 | D7 | MM3Z5V6T1G | D_SOD-323F | 1 | Zener diode | D_Zener | MM3Z5V6T1G
26 | D15 | MM3Z7V5ST1G | D_SOD-323F | 1 | Zener diode | D_Zener | MM3Z7V5ST1G
27 | D16 D21 | SK56A-LTP | D_SMA | 2 | Schottky diode | D_Schottky | SK56A-LTP |  | SBR3U20SA-13
28 | D19 | SMDJ20A | D_SMC | 1 | Zener diode | D_Zener | SMDJ20A
29 | F1 | Polyfuse | R_1812_4532Metric | 1 | Resettable fuse, polymeric positive temperature coefficient | Polyfuse | 0ZCG0150FF2C
30 | HS1 | Heatsink | NONE | 1 | Heatsink | Heatsink | 577002B00000G | 577002B00000G
31 | HS2 | Heatsink | NONE | 1 | Heatsink | Heatsink | 507302B00000G | 507302B00000G
32 | J4 | Barrel_Jack_Switch | BarrelJack_CUI_PJ-102AH_Horizontal_3D | 1 | DC Barrel Jack with an internal switch | Barrel_Jack_Switch | PJ-102AH
33 | J3 | Conn_01x04_Male | Molex_KK-254_AE-6410-04A_1x04_P2.54mm_Vertical | 1 | Generic connector, single row, 01x04, script generated (kicad-library-utils/schlib/autogen/connector/) | Conn_01x04_Male | 22-27-2041 | Molex
34 | J5 | Conn_02x05_Counter_Clockwise | Tag-Connect_TC2050-IDC-NL_2x05_P1.27mm_Vertical | 1 | Generic connector, double row, 02x05, counter clockwise pin numbering scheme (similar to DIP packge numbering), script generated (kicad-library-utils/schlib/autogen/connector/) | Conn_02x05_Counter_Clockwise |  |  |  | <DNP>
35 | J1 | Conn_02x05_Odd_Even | PinHeader_2x05_P2.54mm_Horizontal | 1 | Generic connector, double row, 02x05, odd/even pin numbering scheme (row 1 odd numbers, row 2 even numbers), script generated (kicad-library-utils/schlib/autogen/connector/) | Conn_02x05_Odd_Even | 10129382-910001BLF
36 | J8 | Fan | Molex_KK-254_AE-6410-02A_1x02_P2.54mm_Vertical | 1 | Fan | Fan | 22-27-2021 | Molex
37 | J2 | USB_B | USB2p0_TypeB_Standard | 1 | USB Type B connector | USB_B | SS-52300-001 | On Shore | SS-52300-001
38 | K1 | G5NB | Relay_SPST_Omron-G5NB | 1 | Omron G5Q relay, Miniature Single Pole, SPST-NO, 10A | G5Q-1A | G5NB-1A4-DC5
39 | L3 L4 L11 | 10uH | L_1210_3225Metric_Pad1.42x2.65mm_HandSolder | 3 | Inductor | L | LQH32PN100MN0L
40 | L1 L2 L5 L6 L7 L8 L9 L10 L12 L13 L14 L15 L16 L17 L20 L21 | FB | L_0805_2012Metric | 16 | Ferrite bead | Ferrite_Bead | MPZ2012S601AT000 | TDK
41 | L18 L19 | choke | CommonModeChoke-4Pin_4.5x3.2mm | 2 | Coupled inductor | L_Coupled | 744235601
42 | LG4 | Made in KA | MadeInKA_15mmx6mm | 1 |  | LOGO |  |  |  | <DNP>
43 | LG2 | RoHS | Rohs_09mm | 1 |  | LOGO |  |  |  | <DNP>
44 | LOGO1 | Logo_Open_Hardware_Small | OSHW-Logo2_14.6x12mm_SilkScreen | 1 | Open Hardware logo, small | Logo_Open_Hardware_Small
45 | NT1 NT2 | Net-Tie_2 | NetTie-2_SMD_Pad2.0mm | 2 | Net tie, 2 pins | Net-Tie_2
46 | P2 | Aluminium Case | NONE | 1 |  | DUMMY-IOT_PS_Library-ZS-2102A-02-rescue | AK-C-C28 | SZOMK |  | <ACC>
47 | P1 | DUMMY | NONE | 1 |  | DUMMY-IOT_PS_Library-ZS-2102A-02-rescue | 418-TRH70A15011E02VI |  |  | <ACC>
48 | P10 | DUMMY | NONE | 1 |  | DUMMY-IOT_PS_Library-ZS-2102A-02-rescue | ASB0312LA-CF00 | Delta Electronics |  | <ACC>
49 | P11 | DUMMY | NONE | 1 |  | DUMMY-IOT_PS_Library-ZS-2102A-02-rescue | SSD1306 I2C OLED 0.96" MODULE WHITE | Molex |  | <ACC>
50 | P12 | DUMMY | NONE | 1 |  | DUMMY | Nut M2 (8 Qty) |  |  | <ACC>
51 | P13 | DUMMY | NONE | 1 |  | DUMMY | Molex cable 4 pin |  |  | <ACC>
52 | P14 | DUMMY | NONE | 1 |  | DUMMY | Button head Bolt M3x16 (4 Qty) |  |  | <ACC>
53 | P15 | DUMMY | NONE | 1 |  | DUMMY | Nut M3 (4 Qty) |  |  | <ACC>
54 | P16 | DUMMY | NONE | 1 |  | DUMMY | Molex cable 2-pin |  |  | <ACC>
55 | P17 | DUMMY | NONE | 1 |  | DUMMY | Bumpon 12x5mm (Qty = 4) | Hukimoyo |  | <ACC>
56 | P18 | DUMMY | NONE | 1 |  | DUMMY | Nut M3 (2 Qty) |  |  | <ACC>
57 | P19 | DUMMY | NONE | 1 |  | DUMMY | 441-R311-GRX |  |  | <ACC>
58 | P3 | DUMMY | NONE | 1 |  | DUMMY-IOT_PS_Library-ZS-2102A-02-rescue | CBLT-UA-UB-1 | CUI |  | <ACC>
59 | P4 | DUMMY | NONE | 1 |  | DUMMY-IOT_PS_Library-ZS-2102A-02-rescue | Banana Cable Black | Any |  | <ACC>
60 | P5 | DUMMY | NONE | 1 |  | DUMMY-IOT_PS_Library-ZS-2102A-02-rescue | Banana cable Red | Any |  | <ACC>
61 | P6 | DUMMY | NONE | 1 |  | DUMMY | Button head Bolt M3x8 (2 Qty) |  |  | <ACC>
62 | P7 | DUMMY | NONE | 1 |  | DUMMY-IOT_PS_Library-ZS-2102A-02-rescue | 111-0102-001 | Cinch Connectivity |  | <ACC>
63 | P8 | DUMMY | NONE | 1 |  | DUMMY-IOT_PS_Library-ZS-2102A-02-rescue | 111-0103-001 | Cinch Connectivity |  | <ACC>
64 | P9 | DUMMY | NONE | 1 |  | DUMMY | Button head bolt M2x6 (4 Qty) |  |  | <ACC>
65 | Q2 | 2N3906 | TO-92_Inline | 1 | -0.2A Ic, -40V Vce, Small Signal PNP Transistor, TO-92 | 2N3906 | 2N3906-AP
66 | Q9 Q14 | BC807 | SOT-23 | 2 | 0.8A Ic, 45V Vce, PNP Transistor, SOT-23 | BC807 | BC807-40LT1G
67 | Q1 Q6 Q7 Q11 Q12 Q13 Q16 Q18 | BC817 | SOT-23 | 8 | 0.8A Ic, 45V Vce, NPN Transistor, SOT-23 | BC817 | BC817-25,235
68 | Q10 Q15 | BSS138 | SOT-23 | 2 | 50V Vds, 0.22A Id, N-Channel MOSFET, SOT-23 | BSS138 | BSS138K-13
69 | Q5 | FZT1151ATA | SOT-223-3_TabPin2 | 1 | -6A Ic, -100V Vce, Power PNP Transistor, TO-220 | TIP42C | FZT1151ATA
70 | Q4 | TIP33C | TO-220-3_Vertical | 1 | 6A Ic, 100V Vce, Power NPN Transistor, TO-220 | TIP41C | TIP33C
71 | R9 R17 R25 R26 R27 R28 R33 R35 R40 R112 R166 R173 | 0R | R_0603_1608Metric | 12 | Resistor, US symbol | R_US | RC0603JR-070RL |  |  |  | 1%
72 | R5 R13 R15 R20 R62 R137 R148 R149 | 0R | R_0402_1005Metric | 8 | Resistor, US symbol | R_US | RC0402JR-070RL |  |  |  | 1%
73 | R31 R32 R39 R172 | 0R | R_0805_2012Metric | 4 | Resistor, US symbol | R_US | RC0805JR-070RL |  |  |  | 1%
74 | R183 | 100R | R_0402_1005Metric | 1 | Resistor, US symbol | R_US | RC0402FR-07100RL |  |  |  | 1%
75 | R98 R99 R100 R101 R102 R103 R104 R105 R128 R142 R182 R193 | 100k | R_0402_1005Metric | 12 | Resistor, US symbol | R_US | RC0402FR-07100KL |  |  |  | 1%
76 | R41 | 105k | R_0603_1608Metric | 1 | Resistor, US symbol | R_US | RC0603FR-07105KL |  |  |  | 1%
77 | R110 R114 R117 R160 | 10R | R_0603_1608Metric | 4 | Resistor, US symbol | R_US | RC0603FR-0710RL |  |  |  | 1%
78 | R30 R44 R63 R72 R95 R111 R126 R132 R138 R145 R155 | 10k | R_0603_1608Metric | 11 | Resistor, US symbol | R_US | RC0603FR-0710KL |  |  |  | 1%
79 | R58 R59 R60 R64 R68 R120 R122 R139 R141 R162 R177 R184 R191 R192 R206 R207 | 10k | R_0402_1005Metric | 16 | Resistor, US symbol | R_US | RC0402FR-0710KL |  |  |  | 1%
80 | R52 R97 | 10k | R_0603_1608Metric | 2 | Resistor, US symbol | R_US | RC0603FR-0710KL |  |  | <DNP> | 1%
81 | R84 R85 | 10k00 | R_0603_1608Metric | 2 | Resistor, US symbol | R_US | RT0603BRD0710KL |  |  |  | 0.1%
82 | R42 R55 | 12k | R_0402_1005Metric | 2 | Resistor, US symbol | R_US | RC0402FR-0712KL |  |  |  | 1%
83 | R168 R171 | 150R | R_0603_1608Metric | 2 | Resistor, US symbol | R_US | RC0603FR-07150RL |  |  |  | 1%
84 | R50 | 15k00 | R_0603_1608Metric | 1 | Resistor, US symbol | R_US | RT0603BRD0715KL |  |  |  | 0.1%
85 | R161 | 1R | R_1210_3225Metric | 1 | Resistor, US symbol | R_US | ERJ-P14J1R0U |  |  |  | 5%
86 | R205 | 1R00 | TO-220-2_Vertical | 1 | Resistor, US symbol | R_US | PWR221T-50-1R00F |  |  |  | 1%
87 | R3 R14 R36 R48 R49 R51 R53 R54 R83 R94 R109 R113 R119 R121 R135 R136 R144 R164 R181 R188 | 1k | R_0402_1005Metric | 20 | Resistor, US symbol | R_US | RC0402FR-071KL |  |  |  | 1%
88 | R96 R123 R131 R143 R154 R159 R169 R176 R195 | 1k | R_0603_1608Metric | 9 | Resistor, US symbol | R_US | RC0603FR-071KL |  |  |  | 1%
89 | R130 | 1k | R_0402_1005Metric | 1 | Resistor, US symbol | R_US | RC0402FR-071KL |  |  | <DNP> | 1%
90 | R82 | 1k | R_0603_1608Metric | 1 | Resistor, US symbol | R_US | RC0603FR-071KL |  |  | <DNP> | 1%
91 | R67 R69 | 1k00 | R_0402_1005Metric | 2 | Resistor, US symbol | R_US | ERA-2AEB102X |  |  |  | 0.1%
92 | R57 R61 | 1k20 | R_0402_1005Metric | 2 | Resistor, US symbol | R_US | ERA-2AEB122X |  |  |  | 0.1%
93 | R11 R12 | 1k60 | R_0402_1005Metric | 2 | Resistor, US symbol | R_US | ERA-2AEB162X |  |  |  | 0.1%
94 | R8 R185 | 20k | R_0402_1005Metric | 2 | Resistor, US symbol | R_US | RC0402FR-0720KL |  |  |  | 1%
95 | R1 | 20k00 | R_0603_1608Metric_Pad1.05x0.95mm_HandSolder | 1 | Resistor, US symbol | R_US | ERA-3AEB203V |  |  |  | 0.1%
96 | R201 | 220R | R_0603_1608Metric | 1 | Resistor, US symbol | R_US | RC0603FR-07220RL |  |  |  | 1%
97 | R4 R73 R74 R76 R77 R78 R79 R80 R81 | 22R | R_0402_1005Metric | 9 | Resistor, US symbol | R_US | RC0402FR-0722RL |  |  |  | 1%
98 | R6 R18 R23 | 2R | R_0402_1005Metric | 3 | Resistor, US symbol | R_US | RC0402FR-072RL |  |  |  | 1%
99 | R56 R116 R146 R200 R202 | 2k | R_0603_1608Metric | 5 | Resistor, US symbol | R_US | RC0603FR-072KL |  |  |  | 1%
100 | R106 | 2k10 | R_0402_1005Metric | 1 | Resistor, US symbol | R_US | ERA-2AEB2101X |  |  |  | 0.1%
101 | R19 R34 R45 R47 | 2k2 | R_0603_1608Metric | 4 | Resistor, US symbol | R_US | RC0603FR-072K2L |  |  |  | 1%
102 | R7 R43 R134 R151 R157 R167 R178 R179 R180 R194 | 3.3k | R_0402_1005Metric | 10 | Resistor, US symbol | R_US | RC0402FR-073K3L |  |  |  | 1%
103 | R38 | 330R | R_0603_1608Metric | 1 | Resistor, US symbol | R_US | RC0603FR-07330RL |  |  |  | 1%
104 | R16 R46 R65 R66 R86 R87 R88 R89 R90 R91 R92 R93 R163 | 33R | R_0402_1005Metric | 13 | Resistor, US symbol | R_US | RC0402FR-0733RL |  |  |  | 1%
105 | R118 R124 R125 R133 R147 R208 | 33k | R_0402_1005Metric | 6 | Resistor, US symbol | R_US | RC0402FR-0733KL |  |  |  | 1%
106 | R21 R22 R198 R199 | 3k3 | R_0603_1608Metric | 4 | Resistor, US symbol | R_US | RC0603FR-073K3L |  |  |  | 1%
107 | R150 R175 R187 | 47k | R_0402_1005Metric | 3 | Resistor, US symbol | R_US | RC0402FR-0747KL |  |  |  | 1%
108 | R186 | 47k | R_0402_1005Metric | 1 | Resistor, US symbol | R_US | RC0402FR-0747KL |  |  | <DNP> | 1%
109 | R10 R37 R107 R108 | 499R | R_0402_1005Metric | 4 | Resistor, US symbol | R_US | ERA-2AEB4990X |  |  |  | 0.1%
110 | R127 R129 R156 R165 | 4k3 | R_0402_1005Metric | 4 | Resistor, US symbol | R_US | RC0402FR-074K3L |  |  |  | 1%
111 | R2 | 56R2 | R_0603_1608Metric | 1 | Resistor, US symbol | R_US | ERA-3AEB56R2V |  |  |  | 0.1%
112 | R153 R170 | 5k6 | R_0603_1608Metric | 2 | Resistor, US symbol | R_US | RC0603FR-075K6L |  |  |  | 1%
113 | R71 | 680R | R_0805_2012Metric | 1 | Resistor, US symbol | R_US | RC0603FR-07680RL |  |  |  | 1%
114 | R115 R158 | 6k8 | R_0603_1608Metric | 2 | Resistor, US symbol | R_US | RC0603FR-076K8L |  |  |  | 1%
115 | R70 R75 | 6k80 | R_0402_1005Metric | 2 | Resistor, US symbol | R_US | ERA-2AEB682X |  |  |  | 0.1%
116 | R29 | 82k | R_0603_1608Metric | 1 | Resistor, US symbol | R_US | RC0603FR-0782KL |  |  |  | 1%
117 | U19 | 5M160ZE64I5N | EQFP-64_1EP_7x7mm_P0.4mm_SM | 1 |  | 5M80ZE64C5N-IOT_PS_Library-ZS-2102A-02-rescue | 5M160ZE64I5N
118 | U15 | 93LC46B | SOT-23-6 | 1 |  | 93LC46B-IOT_PS_Library-ZS-2102A-02-rescue | 93LC46BT-I/OT | Microchip
119 | U1 U3 U40 | AD8422ARZ | SOIC-8_3.9x4.9mm_P1.27mm | 3 | Low Power, Instumentation Amplifier, MSOP-8 | AD8421BRMZ | AD8422ARZ | Analog Devices
120 | U39 | ADG417BR | SOIC-8_3.9x4.9mm_P1.27mm | 1 | Single SPST Monolithic LC²MOS Analog Switch, normally OFF, 25Ohm Ron, SOIC-8 | ADG417BR | ADG417BRZ
121 | U12 | ATSHA204A-SSHDA-T | SOIC-8_3.9x4.9mm_P1.27mm | 1 | I2C Serial EEPROM, 1Kb (128x8) with Unique Serial Number, SO8 | AT24CS01-SSHM | ATSHA204A-SSHDA-T
122 | U46 | CAT5171 | SOT-23-8 | 1 |  | CAT5171 | CAT5171TBI-50GT3
123 | U17 | FT2232H | LQFP-64_10x10mm_P0.5mm | 1 |  | FT2232H-IOT_PS_Library-ZS-2102A-02-rescue | FT2232HL-REEL | FTDI
124 | U37 | LM317_3PinPackage | SOT-223-3_TabPin2 | 1 | 1A 35V Adjustable Linear Regulator, SOT-89/SOT-223/TO-220/TO-252/TO-263 | LM317_3PinPackage | LM317MSTT3G
125 | U33 | LM35DZ/NOPB | TO-92L_Inline_Wide | 1 | Precision centigrade temperature sensor, TO-92 | LM35-LP | LM35DZ/NOPB
126 | U2 | LT1461CCS8-3 | SOIC-8_3.9x4.9mm_P1.27mm | 1 |  | LT1461CCS8-4-IOT_PS_Library-ZS-2102A-02-rescue | LT1461CCS8-3#PBF | Linear
127 | U16 | LT1613 | TSOT-23-5 | 1 |  | LT1931-IOT_PS_Library-ZS-2102A-02-rescue | LT1613CS5#TRMPBF | Linear
128 | U8 | LT1931 | TSOT-23-5 | 1 |  | LT1931-IOT_PS_Library-ZS-2102A-02-rescue | LT1931ES5#TRPBF | Linear
129 | U27 U30 | LTC2631ITS8-LM12 | SOT-23-8 | 2 |  | LTC2631ITS8-LM12 | LTC2631ITS8-LM12#TRMPBF | Linear Technology
130 | U6 U9 | MCP33131D-10-I/MS | TSSOP-10_3x3mm_P0.5mm | 2 |  | ADS8881-IOT_PS_Library-ZS-2102A-02-rescue | MCP33131D-10-I/MS | Analog Devices
131 | U25 | MCP3425A0T-ECH | SOT-23-6_Handsoldering | 1 | Single Delta-Sigma 16bit Analog to Digital Converter, I2C Interface, SOT-23-6 | MCP3425A0T-ECH | MCP3425A0T-E/CH
132 | U24 U28 U29 U31 U45 | OPA196 | SOT-23-5 | 5 | Single 1.8V, microPower, CMOS Operational Amplifiers, Zero-Drift Series, SOT-23-5 | OPA333xxDBV | OPA196IDBVR | Texas Instruments
133 | U4 | OPA333xxDBV | SOT-23-5 | 1 | Single 1.8V, microPower, CMOS Operational Amplifiers, Zero-Drift Series, SOT-23-5 | OPA333xxDBV | OPA333AIDBV
134 | U36 | SN74LVC1T45DBVR | SOT-23-6 | 1 | Single-Bit Dual-Supply Bus Transceiver With Configurable Voltage Translation and 3-State Outputs, SOT-23-6 | SN74LVC1T45DBV | SN74LVC1T45DBV
135 | U18 | SN74LVC8T245 | TSSOP-24_4.4x7.8mm_P0.65mm | 1 |  | SN74LVC8T245-IOT_PS_Library-ZS-2102A-02-rescue | SN74LVC8T245PW | Texas Instruments
136 | U5 U22 U23 | THS4281DBVT | SOT-23-5 | 3 | Single 1.8V, microPower, CMOS Operational Amplifiers, Zero-Drift Series, SOT-23-5 | OPA333xxDBV | THS4281DBVR | Texas Instruments
137 | U7 U20 | THS4521 | SOIC-8_3.9x4.9mm_P1.27mm | 2 |  | THS4521-IOT_PS_Library-ZS-2102A-02-rescue | THS4521IDR | Texas Instruments
138 | U10 U11 | TLV70218_SOT23-5 | SOT-23-5 | 2 |  | TLV70218_SOT23-5-Regulator_Linear-ZS-1100X-02-rescue | TLV70218DBV | Texas Instruments
139 | U13 U14 U26 | TLV70233_SOT23-5 | SOT-23-5 | 3 |  | TLV70225_SOT23-5-Regulator_Linear-ZS-1100X-02-rescue | TLV70233DBV
140 | U32 U34 U35 U42 U43 U44 | TLV9301IDBVR | SOT-23-5 | 6 | Single 1.8V, microPower, CMOS Operational Amplifiers, Zero-Drift Series, SOT-23-5 | OPA333xxDBV | TLV9301IDBVR
141 | U38 | TMP411 | SOIC-8_3.9x4.9mm_P1.27mm | 1 | - Remote and Local TEMPERATURE SENSOR | TMP411 | TMP411ADR
142 | U41 | TPS3808 | SOT-23-6 | 1 | Low-Quiescent-Current, Programmable-Delay Supervisory Circuit, SOT-23-6 | TPS3808DBV | TPS3808G30DBVR
143 | U21 | USBLC6-2SC6Y | SOT-23-6 | 1 |  | USBLC6-2SC6-Power_Protection-ZS-2102A-02-rescue | USBLC6-2SC6Y
144 | X1 | 64MHz | Oscillator_SMD_TXC_7C-4Pin_5.0x3.2mm | 1 | Crystal Oscillator Low Profile / High Stability SPXO | SG-210SCD | KC5032A64.0000C10E00 | Kyocera |  |  | 50ppm
145 | Y1 | Crystal 12MHz | Crystal_SMD_2520-4Pin_2.5x2.0mm | 1 | Four pin crystal, GND on pins 2 and 4 | Crystal_GND24 | ABM10-166-12.000MHZ-T3 | Abracon |  |  | 10ppm/10ppm | 12MHz
Component Groups: | 145
Component Count: | 488
Fitted Components: | 488
Number of PCBs: | 1
Total components: | 488
Schematic Version: | 4
Schematic Date: | 2020-12-03
PCB Variant: | [u'default']
BoM Date: | 12/6/2020 9:53:28 AM
Schematic Source: | C:\Users\praja\Documents\GitHub\zs1100a\Hardware\PCB\KiCAD\PC-1100X.sch
KiCad Version: | Eeschema (5.1.5)-3
