zscircuits/zs1100a/Hardware/PCB/KiCAD/PC-1100X_bom_4.xlsx

Component | References | Value | Footprint | Quantity Per PCB | Description | Part | MPN | ALT_PN | Manufacturer | Assembly | Tolerance | Frequency
1 | BZ1 | Buzzer | Buzzer_12x9.5RM7.6 | 1 | Buzzer, polarized | Buzzer | PB-12N23P-05Q | WST-1205S | Soberton Inc
2 | C2 C3 C6 C8 C12 C14 C21 C36 C38 C41 C42 C46 C52 C57 C58 C59 C60 C61 C62 C63 C64 C65 C67 C68 C70 C71 C72 C74 C80 C81 C83 C86 C89 C90 C92 C105 C108 C113 C114 C115 C119 C120 C124 C126 C130 C131 C135 C136 C141 C142 C145 C146 | 0.1uF | C_0402_1005Metric | 52 | Unpolarized capacitor | C | TMK105B7104MV-FR |  | Samsung
3 | C78 C79 C97 C101 C102 C104 C107 | 100pF | C_0603_1608Metric | 7 | Unpolarized capacitor | C | C0603C101K5RACTU |  | Kemet
4 | C20 C51 C53 C88 C94 C134 | 100pF | C_0402_1005Metric | 6 | Unpolarized capacitor | C | C0402C101J3GACTU |  | Kemet
5 | C69 C87 C110 C121 C128 C129 | 10nF | C_0402_1005Metric | 6 | Unpolarized capacitor | C | TMF105B7103MVHF
6 | C1 C5 C7 C19 C24 C26 C27 C29 C30 C31 C32 C35 C37 C39 C40 C44 C47 C48 C49 C54 C66 C76 C93 C99 C112 C123 C127 C132 C138 | 10uF | C_0805_2012Metric | 29 | Unpolarized capacitor | C | TMK212BBJ106MGHT
7 | C50 C55 | 12pF | C_0402_1005Metric | 2 | Unpolarized capacitor | C | GJM1555C1H120FB01D
8 | C4 C18 C25 C84 C85 C95 C96 C98 C103 C111 | 1nF | C_0402_1005Metric | 10 | Unpolarized capacitor | C | C0402C102J5RAC7411 |  | Kemet
9 | C9 C13 C15 C28 C45 C91 C100 C109 C118 C133 C137 | 1uF | C_0603_1608Metric | 11 | Unpolarized capacitor | C | TMK107BJ105KA-T | CL10A105KA8NNNC
10 | C11 C16 C17 C22 | 2.2nF | C_0402_1005Metric | 4 | Unpolarized capacitor | C | C0402C222J3GACTU
11 | C33 C43 C75 C82 | 220pF | C_0402_1005Metric | 4 | Unpolarized capacitor | C | CC0402JRNPO8BN221
12 | C10 C122 | 220uF | CP_Elec_8x10 | 2 | Polarized capacitor | CP | UWT1E221MNL1GS
13 | C23 C34 C56 C73 C77 | 22uF | C_0805_2012Metric | 5 | Unpolarized capacitor | C | GRM21BR61E226ME44L
14 | C106 C125 C140 | 4700pF | C_0603_1608Metric | 3 | Unpolarized capacitor | C | C0603C472K5RACTU |  | Kemet
15 | C139 C143 C144 | 470pF | C_0603_1608Metric | 3 | Unpolarized capacitor | C | C0603C471K5GACTU |  | Kemet
16 | C117 | 470uF | CP_Elec_10x10 | 1 | Polarized capacitor | CP | UWT1E471MNL1GS
17 | C116 | 47uF | C_1206_3216Metric | 1 | Unpolarized capacitor | C | EMK316BBJ476ML-T
18 | D25 | BAS416Z | D_SOD-323_HandSoldering | 1 | Diode | D | BAS416Z
19 | D6 D12 D20 D23 | CDBW140-G | D_SOD-123 | 4 | Schottky diode | D_Schottky | CDBW140-G
20 | D22 D24 D28 D29 | D_Schottky | D_SOD-323 | 4 | Schottky diode | D_Schottky | BAT54HT1G
21 | D1 D2 D8 D9 D10 D13 D17 D26 D27 D30 D31 | ESD5Z12T1G | D_SOD-523 | 11 | Zener diode | D_Zener | ESD5Z12T1G
22 | D4 | LED | LED_0805_2012Metric | 1 | Light emitting diode | LED | LTST-C170KRKT
23 | D11 | LED GREEN | LED_D3.0mm | 1 | Light emitting diode | LED | 151031VS06000
24 | D3 D5 | MBR0520 | D_SOD-123 | 2 | 20V 0.5A Schottky Power Rectifier Diode, SOD-123 | MBR0520 | MBR0520L |  | MC Semiconductor
25 | D14 | MM3Z4V3T1G | D_SOD-323F | 1 | Zener diode | D_Zener | MM3Z4V3T1G
26 | D7 D18 | MM3Z5V6T1G | D_SOD-323F | 2 | Zener diode | D_Zener | MM3Z5V6T1G
27 | D15 | MM3Z7V5ST1G | D_SOD-323F | 1 | Zener diode | D_Zener | MM3Z7V5ST1G
28 | D16 D21 | SK56A-LTP | D_SMA | 2 | Schottky diode | D_Schottky | SK56A-LTP | SBR3U20SA-13
29 | D19 | SMDJ20A | D_SMC | 1 | Zener diode | D_Zener | SMDJ20A
30 | F1 | Polyfuse | R_1812_4532Metric | 1 | Resettable fuse, polymeric positive temperature coefficient | Polyfuse | 0ZCG0150FF2C
31 | HS2 | Heatsink | NONE | 1 | Heatsink | Heatsink | 507302B00000G |  | 507302B00000G
32 | J4 | Barrel_Jack_Switch | BarrelJack_CUI_PJ-102AH_Horizontal_3D | 1 | DC Barrel Jack with an internal switch | Barrel_Jack_Switch | PJ-102AH
33 | J6 | Conn_01x04_Male | JST_XH_B4B-XH-A_1x04_P2.50mm_Vertical | 1 | Generic connector, single row, 01x04, script generated (kicad-library-utils/schlib/autogen/connector/) | Conn_01x04_Male | S4B-XH-SM4-TB(LF)(SN) |  | JST
34 | J5 | Conn_02x05_Counter_Clockwise | Tag-Connect_TC2050-IDC-NL_2x05_P1.27mm_Vertical | 1 | Generic connector, double row, 02x05, counter clockwise pin numbering scheme (similar to DIP packge numbering), script generated (kicad-library-utils/schlib/autogen/connector/) | Conn_02x05_Counter_Clockwise |  |  |  | <DNP>
35 | J1 | Conn_02x05_Odd_Even | PinHeader_2x05_P2.54mm_Horizontal | 1 | Generic connector, double row, 02x05, odd/even pin numbering scheme (row 1 odd numbers, row 2 even numbers), script generated (kicad-library-utils/schlib/autogen/connector/) | Conn_02x05_Odd_Even | 302-R101
36 | J8 | Fan | JST_XH_B2B-XH-A_1x02_P2.50mm_Vertical | 1 | Fan | Fan | B2B-XH-AM(LF)(SN)
37 | J2 | USB_B | USB2p0_TypeB_Standard | 1 | USB Type B connector | USB_B | USB-B1HSB6 | SS-52300-001 | On Shore
38 | K1 | G5NB | Relay_SPST_Omron-G5NB | 1 | Omron G5Q relay, Miniature Single Pole, SPST-NO, 10A | G5Q-1A | G5NB-1A4-DC5
39 | L3 L4 L11 | 10uH | L_1210_3225Metric_Pad1.42x2.65mm_HandSolder | 3 | Inductor | L | LQH32PN100MN0L
40 | L1 L2 L7 L8 L9 L10 L12 L13 L14 L15 L16 L17 L20 L21 | FB | L_0805_2012Metric | 14 | Ferrite bead | Ferrite_Bead | 742792097
41 | L5 L6 | FB | L_0805_2012Metric | 2 | Ferrite bead | Ferrite_Bead | MPZ2012S601AT000 |  | TDK
42 | L18 L19 | choke | CommonModeChoke-4Pin_4.5x3.2mm | 2 | Coupled inductor | L_Coupled | 744235900
43 | LG3 | LeadFree | LeadFree_13mm | 1 |  | LOGO |  |  |  | <DNP>
44 | LG4 | Made in KA | MadeInKA_15mmx6mm | 1 |  | LOGO |  |  |  | <DNP>
45 | LG2 | RoHS | Rohs_09mm | 1 |  | LOGO |  |  |  | <DNP>
46 | LG1 | ZS Logo | ZSCircuits_Logo_16x9 | 1 |  | LOGO-IOT_PS_Library |  |  |  | <DNP>
47 | NT1 NT2 | Net-Tie_2 | NetTie-2_SMD_Pad2.0mm | 2 | Net tie, 2 pins | Net-Tie_2
48 | P2 | Aluminium Case | NONE | 1 |  | DUMMY-IOT_PS_Library | AK-C-C28 |  | SZOMK | <ACC>
49 | P1 | DUMMY | NONE | 1 |  | DUMMY-IOT_PS_Library | 418-TRH70A15011E02VI |  |  | <ACC>
50 | P10 | DUMMY | NONE | 1 |  | DUMMY-IOT_PS_Library | ASB0312LA-CF00 |  | Delta Electronics | <ACC>
51 | P11 | DUMMY | NONE | 1 |  | DUMMY-IOT_PS_Library | SSD1306 I2C OLED 0.96" MODULE WHITE |  | Molex | <ACC>
52 | P12 | DUMMY | NONE | 1 |  | DUMMY | Nut M2 (8 Qty) |  |  | <ACC>
53 | P13 | DUMMY | NONE | 1 |  | DUMMY | JST XH 4 PIN WIRE |  |  | <ACC>
54 | P14 | DUMMY | NONE | 1 |  | DUMMY | Button head Bolt M3x16 (4 Qty) |  |  | <ACC>
55 | P15 | DUMMY | NONE | 1 |  | DUMMY | Nut M3 (4 Qty) |  |  | <ACC>
56 | P16 | DUMMY | NONE | 1 |  | DUMMY | JST XH 2 PIN CONNECTOR FEMALE |  |  | <ACC>
57 | P17 | DUMMY | NONE | 1 |  | DUMMY | Bumpon 12x5mm (Qty = 4) |  | Hukimoyo | <ACC>
58 | P18 | DUMMY | NONE | 1 |  | DUMMY | Nut M3 (2 Qty) |  |  | <ACC>
59 | P19 | DUMMY | NONE | 1 |  | DUMMY | 441-R311-GRX |  |  | <ACC>
60 | P3 | DUMMY | NONE | 1 |  | DUMMY-IOT_PS_Library | 102-1030-BL-F0100 |  | CNC Tech | <ACC>
61 | P4 | DUMMY | NONE | 1 |  | DUMMY-IOT_PS_Library | Banana Cable Black |  | Any | <ACC>
62 | P5 | DUMMY | NONE | 1 |  | DUMMY-IOT_PS_Library | Banana cable Red |  | Any | <ACC>
63 | P6 | DUMMY | NONE | 1 |  | DUMMY | Button head Bolt M3x8 (2 Qty) |  |  | <ACC>
64 | P7 | DUMMY | NONE | 1 |  | DUMMY-IOT_PS_Library | 111-0102-001 |  | Cinch Connectivity | <ACC>
65 | P8 | DUMMY | NONE | 1 |  | DUMMY-IOT_PS_Library | 111-0103-001 |  | Cinch Connectivity | <ACC>
66 | P9 | DUMMY | NONE | 1 |  | DUMMY | Button head bolt M2x6 (4 Qty) |  |  | <ACC>
67 | Q2 | 2N3906 | TO-92_Inline | 1 | -0.2A Ic, -40V Vce, Small Signal PNP Transistor, TO-92 | 2N3906 | 2N3906-AP
68 | Q9 Q14 | BC807 | SOT-23 | 2 | 0.8A Ic, 45V Vce, PNP Transistor, SOT-23 | BC807 | BC807-40LT1G
69 | Q1 Q3 Q6 Q7 Q8 Q11 Q12 Q13 Q16 Q17 Q18 | BC817 | SOT-23 | 11 | 0.8A Ic, 45V Vce, NPN Transistor, SOT-23 | BC817 | BC817-25,235
70 | Q10 Q15 | BSS138 | SOT-23 | 2 | 50V Vds, 0.22A Id, N-Channel MOSFET, SOT-23 | BSS138 | BSS138K-13
71 | Q5 | FZT1151ATA | SOT-223-3_TabPin2 | 1 | -6A Ic, -100V Vce, Power PNP Transistor, TO-220 | TIP42C | FZT1151ATA
72 | Q4 | TIP31C | TO-220-3_Vertical | 1 | 6A Ic, 100V Vce, Power NPN Transistor, TO-220 | TIP41C | TIP31C
73 | R9 R17 R25 R26 R27 R28 R33 R35 R40 R96 R112 R152 R166 R173 | 0R | R_0603_1608Metric | 14 | Resistor, US symbol | R_US | RC0603JR-070RL |  |  |  | 1%
74 | R5 R13 R15 R20 R62 R148 R149 | 0R | R_0402_1005Metric | 7 | Resistor, US symbol | R_US | RC0402JR-070RL |  |  |  | 1%
75 | R31 R32 R39 R172 | 0R | R_0805_2012Metric | 4 | Resistor, US symbol | R_US | RC0805JR-070RL |  |  |  | 1%
76 | R203 R204 R205 | 0R33 | R_2512_6332Metric | 3 | Resistor, US symbol | R_US | WFMB2512R3300FEA |  |  |  | 1%
77 | R123 R168 R171 R183 | 100R | R_0603_1608Metric | 4 | Resistor, US symbol | R_US | RC0603FR-07100RL |  |  |  | 1%
78 | R98 R99 R100 R101 R102 R103 R104 R105 R126 R128 R142 R182 R193 | 100k | R_0402_1005Metric | 13 | Resistor, US symbol | R_US | RC0402FR-07100KL |  |  |  | 1%
79 | R41 | 105k | R_0603_1608Metric | 1 | Resistor, US symbol | R_US | RC0603FR-07105KL |  |  |  | 1%
80 | R110 R114 | 10R | R_0805_2012Metric | 2 | Resistor, US symbol | R_US | RC0805FR-0710RL |  |  |  | 1%
81 | R30 R44 R63 R72 R111 R132 R145 R155 | 10k | R_0603_1608Metric | 8 | Resistor, US symbol | R_US | RC0603FR-0710KL |  |  |  | 1%
82 | R58 R59 R60 R64 R68 R94 R120 R122 R137 R139 R141 R162 R177 R181 R184 R186 R188 R191 R192 | 10k | R_0402_1005Metric | 19 | Resistor, US symbol | R_US | RC0402FR-0710KL |  |  |  | 1%
83 | R52 R97 R140 | 10k | R_0603_1608Metric | 3 | Resistor, US symbol | R_US | RC0603FR-0710KL |  |  | <DNP> | 1%
84 | R174 | 10k | R_0603_1608Metric | 1 | Resistor, US symbol | R_US | RC0603FR-0733KL |  |  |  | 1%
85 | R84 | 10k00 | R_0603_1608Metric | 1 | Resistor, US symbol | R_US | RT0603BRD0710KL |  |  |  | 0.10%
86 | R85 | 10k5 | R_0402_1005Metric | 1 | Resistor, US symbol | R_US | ERA-2AEB1052X |  |  |  | 0.10%
87 | R42 R55 | 12k | R_0402_1005Metric | 2 | Resistor, US symbol | R_US | RC0402FR-0712KL |  |  |  | 1%
88 | R50 | 15k00 | R_0603_1608Metric | 1 | Resistor, US symbol | R_US | RT0603BRD0715KL |  |  |  | 0.10%
89 | R161 | 1R | R_1210_3225Metric | 1 | Resistor, US symbol | R_US | ERJ-P14J1R0U |  |  |  | 5%
90 | R197 | 1R | R_0805_2012Metric | 1 | Resistor, US symbol | R_US | RC0805FR-071RL |  |  |  | 1%
91 | R48 R49 R51 R53 R54 R83 R95 R109 R113 R119 R135 R136 R164 | 1k | R_0402_1005Metric | 13 | Resistor, US symbol | R_US | RC0402FR-071KL |  |  |  | 1%
92 | R130 | 1k | R_0402_1005Metric | 1 | Resistor, US symbol | R_US | RC0402FR-071KL |  |  | <DNP> | 1%
93 | R131 | 1k | R_0805_2012Metric | 1 | Resistor, US symbol | R_US | RC0805FR-071KL |  |  |  | 1%
94 | R3 R14 R36 | 1k | R_0402_1005Metric | 3 | Resistor, US symbol | R_US | RC0402FR-071KP |  |  |  | 1%
95 | R143 R144 R154 R159 R169 R176 R195 | 1k | R_0603_1608Metric | 7 | Resistor, US symbol | R_US | RC0603FR-071KL |  |  |  | 1%
96 | R82 | 1k | R_0603_1608Metric | 1 | Resistor, US symbol | R_US | RC0603FR-071KL |  |  | <DNP> | 1%
97 | R67 R69 | 1k00 | R_0402_1005Metric | 2 | Resistor, US symbol | R_US | ERA-2AEB102X |  |  |  | 0.10%
98 | R57 R61 | 1k20 | R_0402_1005Metric | 2 | Resistor, US symbol | R_US | ERA-2AEB122X |  |  |  | 0.10%
99 | R11 R12 | 1k60 | R_0402_1005Metric | 2 | Resistor, US symbol | R_US | ERA-2AEB162X |  |  |  | 0.10%
100 | R200 | 1k8 | R_0603_1608Metric | 1 | Resistor, US symbol | R_US | RC0603FR-071K8L |  |  |  | 1%
101 | R8 R185 | 20k | R_0402_1005Metric | 2 | Resistor, US symbol | R_US | RC0402FR-0720KL |  |  |  | 1%
102 | R201 | 220R | R_0603_1608Metric | 1 | Resistor, US symbol | R_US | RC0603FR-07220RL |  |  |  | 1%
103 | R4 R73 R74 R76 R77 R78 R79 R80 R81 | 22R | R_0402_1005Metric | 9 | Resistor, US symbol | R_US | RC0402FR-0722RL |  |  |  | 1%
104 | R6 R18 R23 | 2R | R_0402_1005Metric | 3 | Resistor, US symbol | R_US | RC0402FR-072RL |  |  |  | 1%
105 | R116 R146 R202 | 2k | R_0603_1608Metric | 3 | Resistor, US symbol | R_US | RC0603FR-072KL |  |  |  | 1%
106 | R56 | 2k | R_0402_1005Metric | 1 | Resistor, US symbol | R_US | RC0402FR-072KL |  |  |  | 1%
107 | R1 | 2k00 | R_0603_1608Metric_Pad1.05x0.95mm_HandSolder | 1 | Resistor, US symbol | R_US | ERA-3AEB202V |  |  |  | 0.10%
108 | R106 | 2k1 | R_0402_1005Metric | 1 | Resistor, US symbol | R_US | ERA-2AEB2101X |  |  |  | 0.10%
109 | R19 R34 | 2k7 | R_0402_1005Metric | 2 | Resistor, US symbol | R_US | RC0402FR-072K7L |  |  |  | 1%
110 | R7 R43 R121 R134 R138 R151 R157 R167 R178 R179 R180 R189 R190 R194 | 3.3k | R_0402_1005Metric | 14 | Resistor, US symbol | R_US | RC0402FR-073K3L |  |  |  | 1%
111 | R38 | 330R | R_0603_1608Metric | 1 | Resistor, US symbol | R_US | RC0603FR-07330RL |  |  |  | 1%
112 | R117 R160 R163 R196 | 33R | R_0603_1608Metric | 4 | Resistor, US symbol | R_US | RC0603FR-0733RL |  |  |  | 1%
113 | R16 R46 R65 R66 R86 R87 R88 R89 R90 R91 R92 R93 R187 | 33R | R_0402_1005Metric | 13 | Resistor, US symbol | R_US | RC0402FR-0733RL |  |  |  | 1%
114 | R118 | 33k | R_0603_1608Metric | 1 | Resistor, US symbol | R_US | RC0603FR-073K3L |  |  |  | 1%
115 | R24 R124 R125 R133 R147 | 33k | R_0402_1005Metric | 5 | Resistor, US symbol | R_US | RC0402FR-0733KL |  |  |  | 1%
116 | R21 R22 R45 R47 R153 R170 R198 R199 | 3k3 | R_0603_1608Metric | 8 | Resistor, US symbol | R_US | RC0603FR-073K3L |  |  |  | 1%
117 | R150 R175 | 47k | R_0603_1608Metric | 2 | Resistor, US symbol | R_US | RC0603FR-0747KL |  |  |  | 1%
118 | R10 R37 R107 R108 | 499R | R_0402_1005Metric | 4 | Resistor, US symbol | R_US | ERA-2AEB4990X |  |  |  | 0.10%
119 | R156 | 4k3 | R_0603_1608Metric | 1 | Resistor, US symbol | R_US | RC0603FR-074K3L |  |  |  | 1%
120 | R127 R129 R165 | 4k7 | R_0402_1005Metric | 3 | Resistor, US symbol | R_US | RC0402FR-074K7L |  |  |  | 1%
121 | R2 | 56R2 | R_0603_1608Metric | 1 | Resistor, US symbol | R_US | ERA-3AEB56R2V |  |  |  | 0.10%
122 | R71 | 680R | R_0805_2012Metric | 1 | Resistor, US symbol | R_US | RC0603FR-07680RL |  |  |  | 1%
123 | R115 | 6k8 | R_0603_1608Metric | 1 | Resistor, US symbol | R_US | RC0603FR-076K8L |  |  |  | 1%
124 | R158 | 6k8 | R_0402_1005Metric | 1 | Resistor, US symbol | R_US | RC0402FR-076K8L |  |  |  | 1%
125 | R70 R75 | 6k80 | R_0402_1005Metric | 2 | Resistor, US symbol | R_US | ERA-2AEB682X |  |  |  | 0.10%
126 | R29 | 82k | R_0603_1608Metric | 1 | Resistor, US symbol | R_US | RC0603FR-0782KL |  |  |  | 1%
127 | U19 | 5M80ZE64I5N | EQFP-64_1EP_7x7mm_P0.4mm | 1 |  | 5M80ZE64C5N-IOT_PS_Library | 5M80ZE64I5N
128 | U15 | 93LC46B | SOT-23-6 | 1 |  | 93LC46B-IOT_PS_Library | 93LC46BT-I/OT |  | Microchip
129 | U1 U3 U40 | AD8422ARZ | SOIC-8_3.9x4.9mm_P1.27mm | 3 | Low Power, Instumentation Amplifier, MSOP-8 | AD8421BRMZ | AD8422ARZ |  | Analog Devices
130 | U39 | ADG417BR | SOIC-8_3.9x4.9mm_P1.27mm | 1 | Single SPST Monolithic LCÂ²MOS Analog Switch, normally OFF, 25Ohm Ron, SOIC-8 | ADG417BR | ADG417BRZ
131 | U12 | ATSHA204A-SSHDA-T | SOIC-8_3.9x4.9mm_P1.27mm | 1 | I2C Serial EEPROM, 1Kb (128x8) with Unique Serial Number, SO8 | AT24CS01-SSHM | ATSHA204A-SSHDA-T
132 | U17 | FT2232H | LQFP-64_10x10mm_P0.5mm | 1 |  | FT2232H-IOT_PS_Library | FT2232HL-REEL |  | FTDI
133 | U37 | LM317_3PinPackage | SOT-223-3_TabPin2 | 1 | 1A 35V Adjustable Linear Regulator, SOT-89/SOT-223/TO-220/TO-252/TO-263 | LM317_3PinPackage | LM317MSTT3G
134 | U29 U32 U34 U35 U42 U43 | LM321 | SOT-23-5 | 6 | Low Power Single Operational Amplifier, SOT-23-5 | LM321 | LM321MFX/NOPB
135 | U33 | LM35DZ/NOPB | TO-92L_Inline | 1 | Precision centigrade temperature sensor, TO-92 | LM35-LP | LM35DZ/NOPB
136 | U2 | LT1461CCS8-3 | SOIC-8_3.9x4.9mm_P1.27mm | 1 |  | LT1461CCS8-4-IOT_PS_Library | LT1461DCS8-3#PBF |  | Linear
137 | U16 | LT1613 | TSOT-23-5 | 1 |  | LT1931-IOT_PS_Library | LT1613CS5#TRMPBF |  | Linear
138 | U8 | LT1931 | TSOT-23-5 | 1 |  | LT1931-IOT_PS_Library | LT1931ES5#TRPBF |  | Linear
139 | U27 U30 | LTC2631ITS8-LM12 | SOT-23-8 | 2 |  | LTC2631ITS8-LM12 | LTC2631ITS8-LM12#TRMPBF |  | Linear Technology
140 | U6 U9 | MCP33131D-10-I/MS | TSSOP-10_3x3mm_P0.5mm | 2 |  | ADS8881-IOT_PS_Library | MCP33131D-10-I/MS |  | Analog Devices
141 | U25 | MCP3425A0T-ECH | SOT-23-6_Handsoldering | 1 | Single Delta-Sigma 16bit Analog to Digital Converter, I2C Interface, SOT-23-6 | MCP3425A0T-ECH | MCP3425A0T-E/CH
142 | U28 | OPA141AIDR | SOIC-8_3.9x4.9mm_P1.27mm | 1 |  | TLV07-IOT_PS_Library | OPA141AIDR |  | Texas Instruments
143 | U31 | OPA188AIDBVR | SOT-23-5 | 1 | Single 1.8V, microPower, CMOS Operational Amplifiers, Zero-Drift Series, SOT-23-5 | OPA333xxDBV | OPA188AIDBVR |  | Texas Instruments
144 | U4 | OPA333xxDBV | SOT-23-5 | 1 | Single 1.8V, microPower, CMOS Operational Amplifiers, Zero-Drift Series, SOT-23-5 | OPA333xxDBV | OPA333AIDBVR
145 | U44 | RV-8523-C3 | RTC_SMD_MicroCrystal_C3_2.5x3.7mm | 1 | Realtime Clock/Calendar I2C Interface, Low Power, 1.2 V to 5.5 V, MicroCrystal C3 | RV-8523-C3 | RV-8523-C3
146 | U36 | SN74LVC1T45DBVR | SOT-23-6 | 1 | Single-Bit Dual-Supply Bus Transceiver With Configurable Voltage Translation and 3-State Outputs, SOT-23-6 | SN74LVC1T45DBV | SN74LVC1T45DBV
147 | U18 | SN74LVC8T245 | TSSOP-24_4.4x7.8mm_P0.65mm | 1 |  | SN74LVC8T245-IOT_PS_Library | SN74LVC8T245PWR |  | Texas Instruments
148 | U5 U22 U23 | THS4281DBVT | SOT-23-5 | 3 | Single 1.8V, microPower, CMOS Operational Amplifiers, Zero-Drift Series, SOT-23-5 | OPA333xxDBV | THS4281DBVT |  | Texas Instruments
149 | U7 U20 | THS4521 | SOIC-8_3.9x4.9mm_P1.27mm | 2 |  | THS4521-IOT_PS_Library | THS4521IDR |  | Texas Instruments
150 | U24 | TLV07 | SOIC-8_3.9x4.9mm_P1.27mm | 1 |  | TLV07-IOT_PS_Library | TLV07IDR |  | Texas Instruments
151 | U10 | TLV70218_SOT23-5 | SOT-23-5 | 1 |  | TLV70225_SOT23-5-Regulator_Linear | TLV70218DBVT |  | Texas Instruments
152 | U11 | TLV70218_SOT23-5 | SOT-23-5 | 1 |  | TLV70218_SOT23-5-Regulator_Linear | TLV70218DBVT |  | Texas Instruments
153 | U13 U14 U26 | TLV70233_SOT23-5 | SOT-23-5 | 3 |  | TLV70225_SOT23-5-Regulator_Linear | TLV70233DBVR
154 | U38 | TMP411 | SOIC-8_3.9x4.9mm_P1.27mm | 1 | #NAME? | TMP411 | TMP411ADR
155 | U41 | TPS3808 | SOT-23-6 | 1 | Low-Quiescent-Current, Programmable-Delay Supervisory Circuit, SOT-23-6 | TPS3808DBV | TPS3808G30DBVR
156 | U21 | USBLC6-2SC6Y | SOT-23-6 | 1 |  | USBLC6-2SC6-Power_Protection | USBLC6-2SC6Y
157 | X1 | 64MHz | Oscillator_SMD_TXC_7C-4Pin_5.0x3.2mm | 1 | Crystal Oscillator Low Profile / High Stability SPXO | SG-210SCD | KC5032A64.0000C10E00 |  | Kyocera |  | 50ppm
158 | Y1 | Crystal 12MHz | Crystal_SMD_2520-4Pin_2.5x2.0mm | 1 | Four pin crystal, GND on pins 2 and 4 | Crystal_GND24 | ABM10-166-12.000MHZ-T3 |  | Abracon |  | 10ppm/10ppm | 12MHz
Component Groups: | 158
Component Count: | 502
Fitted Components: | 502
Number of PCBs: | 1
Total components: | 502
Schematic Version: | 4
Schematic Date: | 2020-05-31
PCB Variant: | [u'default']
BoM Date: | 2020-06-05 13:12
Schematic Source: | D:\Zeus\Projects\USB_PowerSourceMeter\PCB\Rev4\PC-1100X.sch
KiCad Version: | Eeschema (5.1.5)-3
