zscircuits/zs1100a/Hardware/Enclosure/ZS-1100-A-AK-C-C28_4_SIDE-SZOMK-V7.dxf

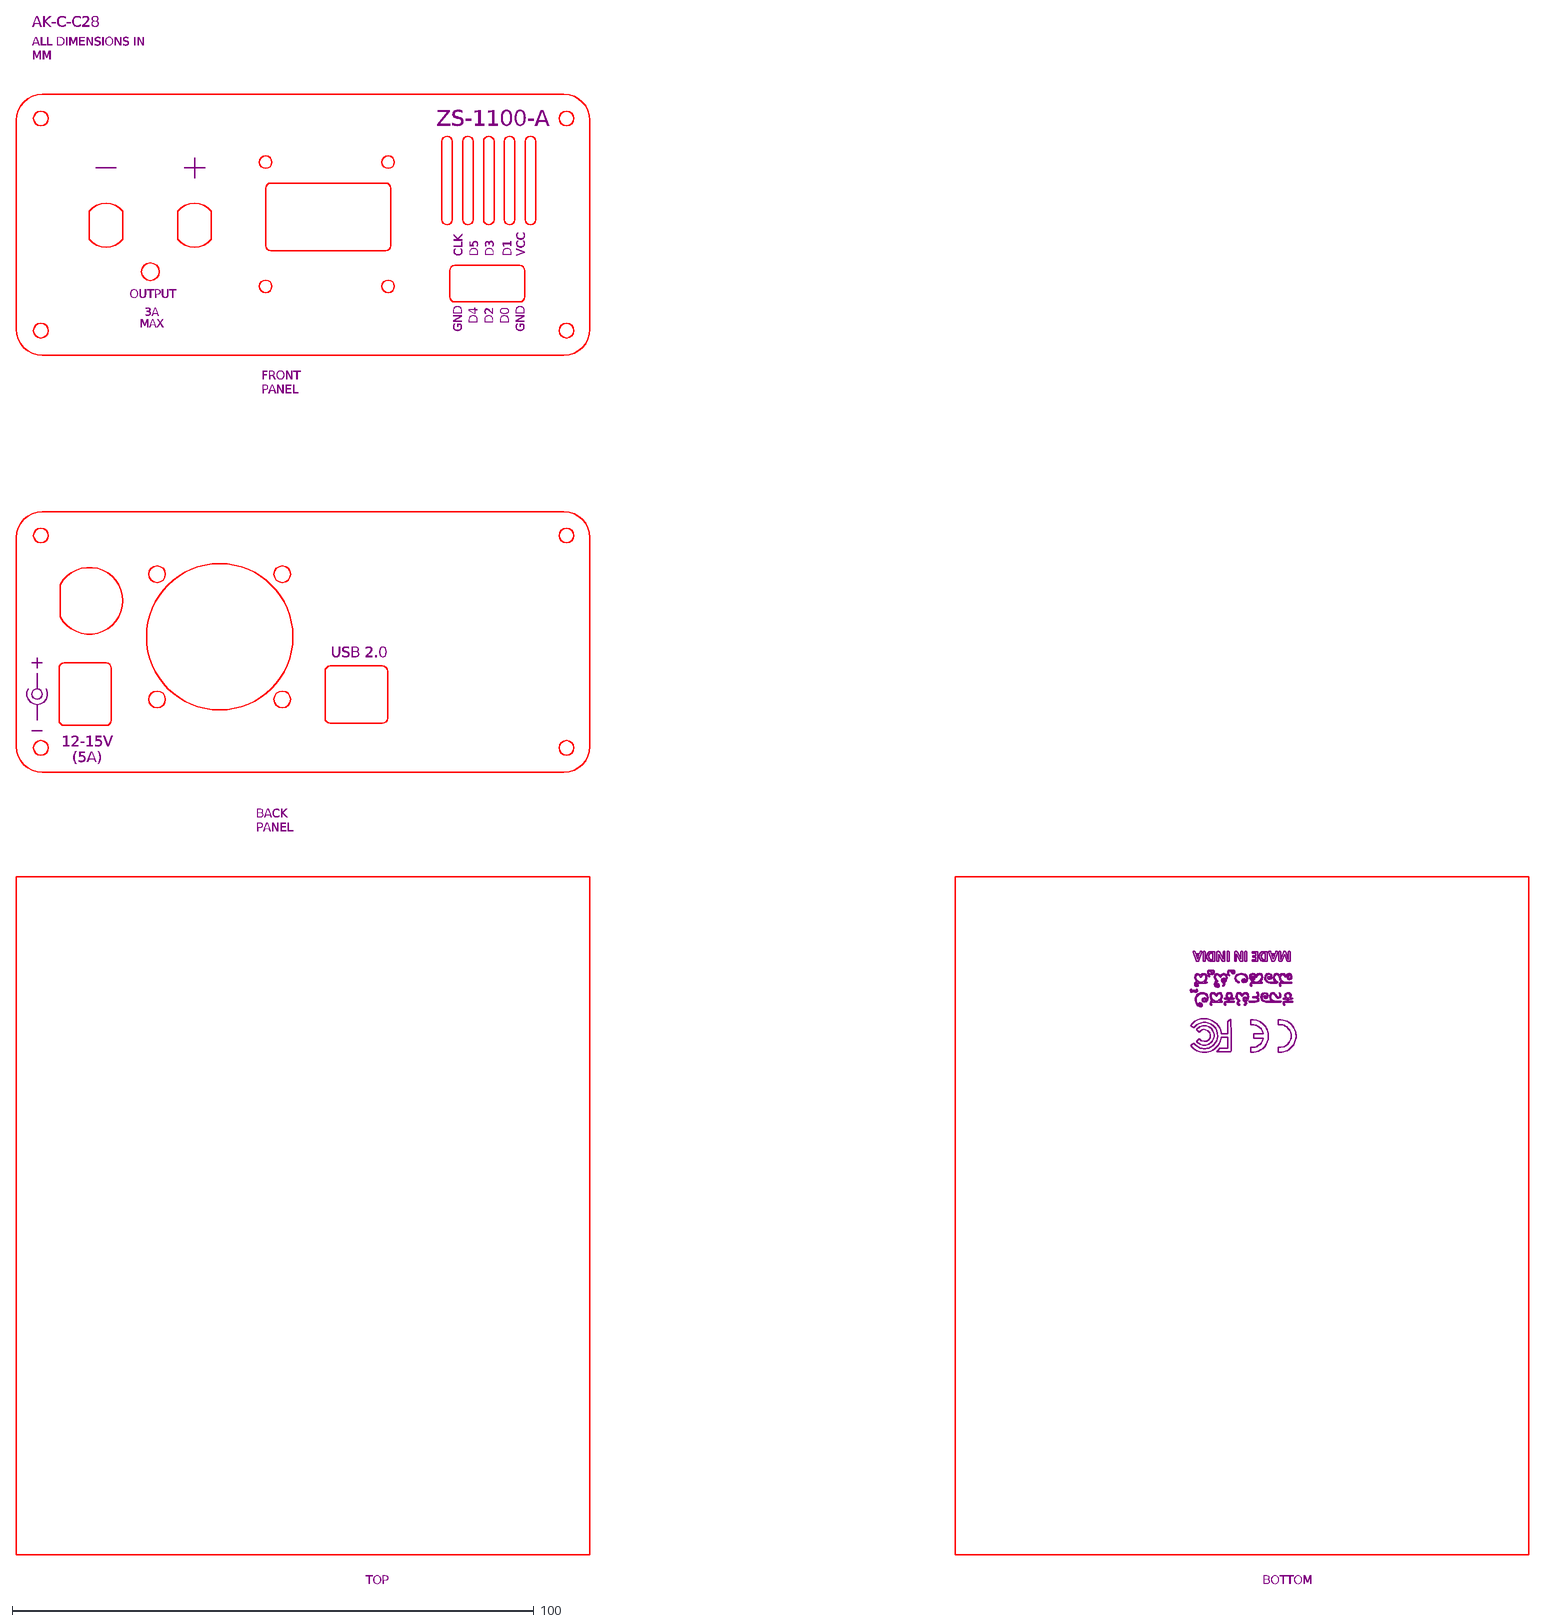
[picture p14: CAD file, 2020-12-06]
Hardware/Enclosure/ZS-1100-A-AK-C-C28_4_SIDE-SZOMK-V7.dxf
FRONT PANEL
BACK PANEL
BOTTOM
TOP
ALL DIMENSIONS IN MM
MAX
3A
AK-C-C28
OUTPUT
12-15V
(5A)
VCC
D1
D3
D5
CLK
D0
D2
D4
GND
ZS-1100-A
USB 2.0
