zscircuits/zs1100a/(threads)

Thread 1 (2021-01-16):

IOT Power profiler GUI Installation errors

zscircuits, 2021-01-16:
It has been reported that the GUI installation could fail, if the user installs the applications for "All users". It is recommended to install the application for the current user only. It is also recommended to use the default paths shown in the installation.

zscircuits, 2021-01-18:
In addition, some users have got license errors while running the application. To overcome this please follow the below steps

There are two files on the USB stick (Model file and License Key)
Please copy them to the below folders

License File Directory : C:\Users\username\AppData\Roaming\ZSCircuits\IOTPowerProfiler\License
Data Model Directory : C:\Users\username\AppData\Roaming\ZSCircuits\IOTPowerProfiler\Models

zscircuits, 2021-02-11:
In case of GUI crash or device not detected, please install the following
1. VC++ Redistributable
https://aka.ms/vs/16/release/vc_redist.x64.exe

2. FTDI drivers
https://www.ftdichip.com/Drivers/CDM/CDM%20v2.12.28%20WHQL%20Certified.zip

Then re-connect the device USB and restart the GUI.

Thread 3 (2021-01-27):

ParseDouble error when adding new battery model

anvol, 2021-01-27:
Existing battery models use dot as delimiter, but it turns out that for adding new models I need to use commas.

Consider replacing comma/dot and setting "CultureInfo.InvariantCulture"

Like this: _Double.Parse("3,5".Replace(',', '.'), CultureInfo.InvariantCulture)_

```
See the end of this message for details on invoking
just-in-time (JIT) debugging instead of this dialog box.

************** Exception Text **************
System.FormatException: Input string was not in a correct format.
   at System.Number.ParseDouble(String value, NumberStyles options, NumberFormatInfo numfmt)
   at System.Convert.ToDouble(String value)
   at IOTPowerProfiler.BattForm.button1_Click(Object sender, EventArgs e)
   at System.Windows.Forms.Control.OnClick(EventArgs e)
   at System.Windows.Forms.Button.OnClick(EventArgs e)
   at System.Windows.Forms.Button.OnMouseUp(MouseEventArgs mevent)
   at System.Windows.Forms.Control.WmMouseUp(Message& m, MouseButtons button, Int32 clicks)
   at System.Windows.Forms.Control.WndProc(Message& m)
   at System.Windows.Forms.ButtonBase.WndProc(Message& m)
   at System.Windows.Forms.Button.WndProc(Message& m)
   at System.Windows.Forms.NativeWindow.Callback(IntPtr hWnd, Int32 msg, IntPtr wparam, IntPtr lparam)
```

zscircuits, 2021-01-27:
Will check this out.
I think the issue is due to the non US style numbering format set on the PC.
you may be able to directly edit the battmodel.xml file located in the below folder
C:\Users\**username**\AppData\Roaming\ZSCircuits\IOTPowerProfiler\Models\Models

Till we fix the issue.

Thread 4 (2021-02-11):

Stability during long runs

zscircuits, 2021-02-11:
Some users have reported the GUI crashing when they are collecting data for long duration (> 4 hrs) at a time.
Please update to the latest GUI ver 2.7.1 which has some enhanced stability fixes for long runs.

Here are few pointers to fix the issue
1. Set the laptop/desktop power options to disable sleep at all times.
2. Set the laptop/desktop for Maximizing performance, instead of maximizing battery life
3. Set the option for SlowPC on the settings tab of the GUI. This reduces the graph update rate and OLED display. This does not degrade the measurement quality.
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

4. Install the FTDI drivers and VC++ Redistributable
VC++ Redistributable
https://aka.ms/vs/16/release/vc_redist.x64.exe

FTDI drivers
https://www.ftdichip.com/Drivers/CDM/CDM%20v2.12.28%20WHQL%20Certified.zip
5. Select the Capture Span for >12hrs
6. Use weak or medium compression strength
7. Use a laptop/desktop with SSD drive instead of a hard disk
8. Ensure at least 2GB of free RAM and 50GB of Disk space during the run.

Thread 5 (2021-04-02):

Current monitoring without logging

zscircuits, 2021-04-02:
Dave wrote :
Thanks for your excellent product development on the ZS1100A power meter. I
have been enjoying using it.
One of the features I would love to see added to the software is the ability to
use it as a general power supply with a great real-time display of output
voltage and current.
At the moment, I find that I need to be acquiring data to a file before I can
see the current on the OLED display and on the real time plot in the control
panel view.
My suggestion is to add a button labelled 'Monitor' (or similar) to the control
panel window, so that I can monitor the output without logging to a file.
