zscircuits/zs1100a/Hardware/PCB/SCH-BOM-ASSY/PC-1100X-ASSY.pdf

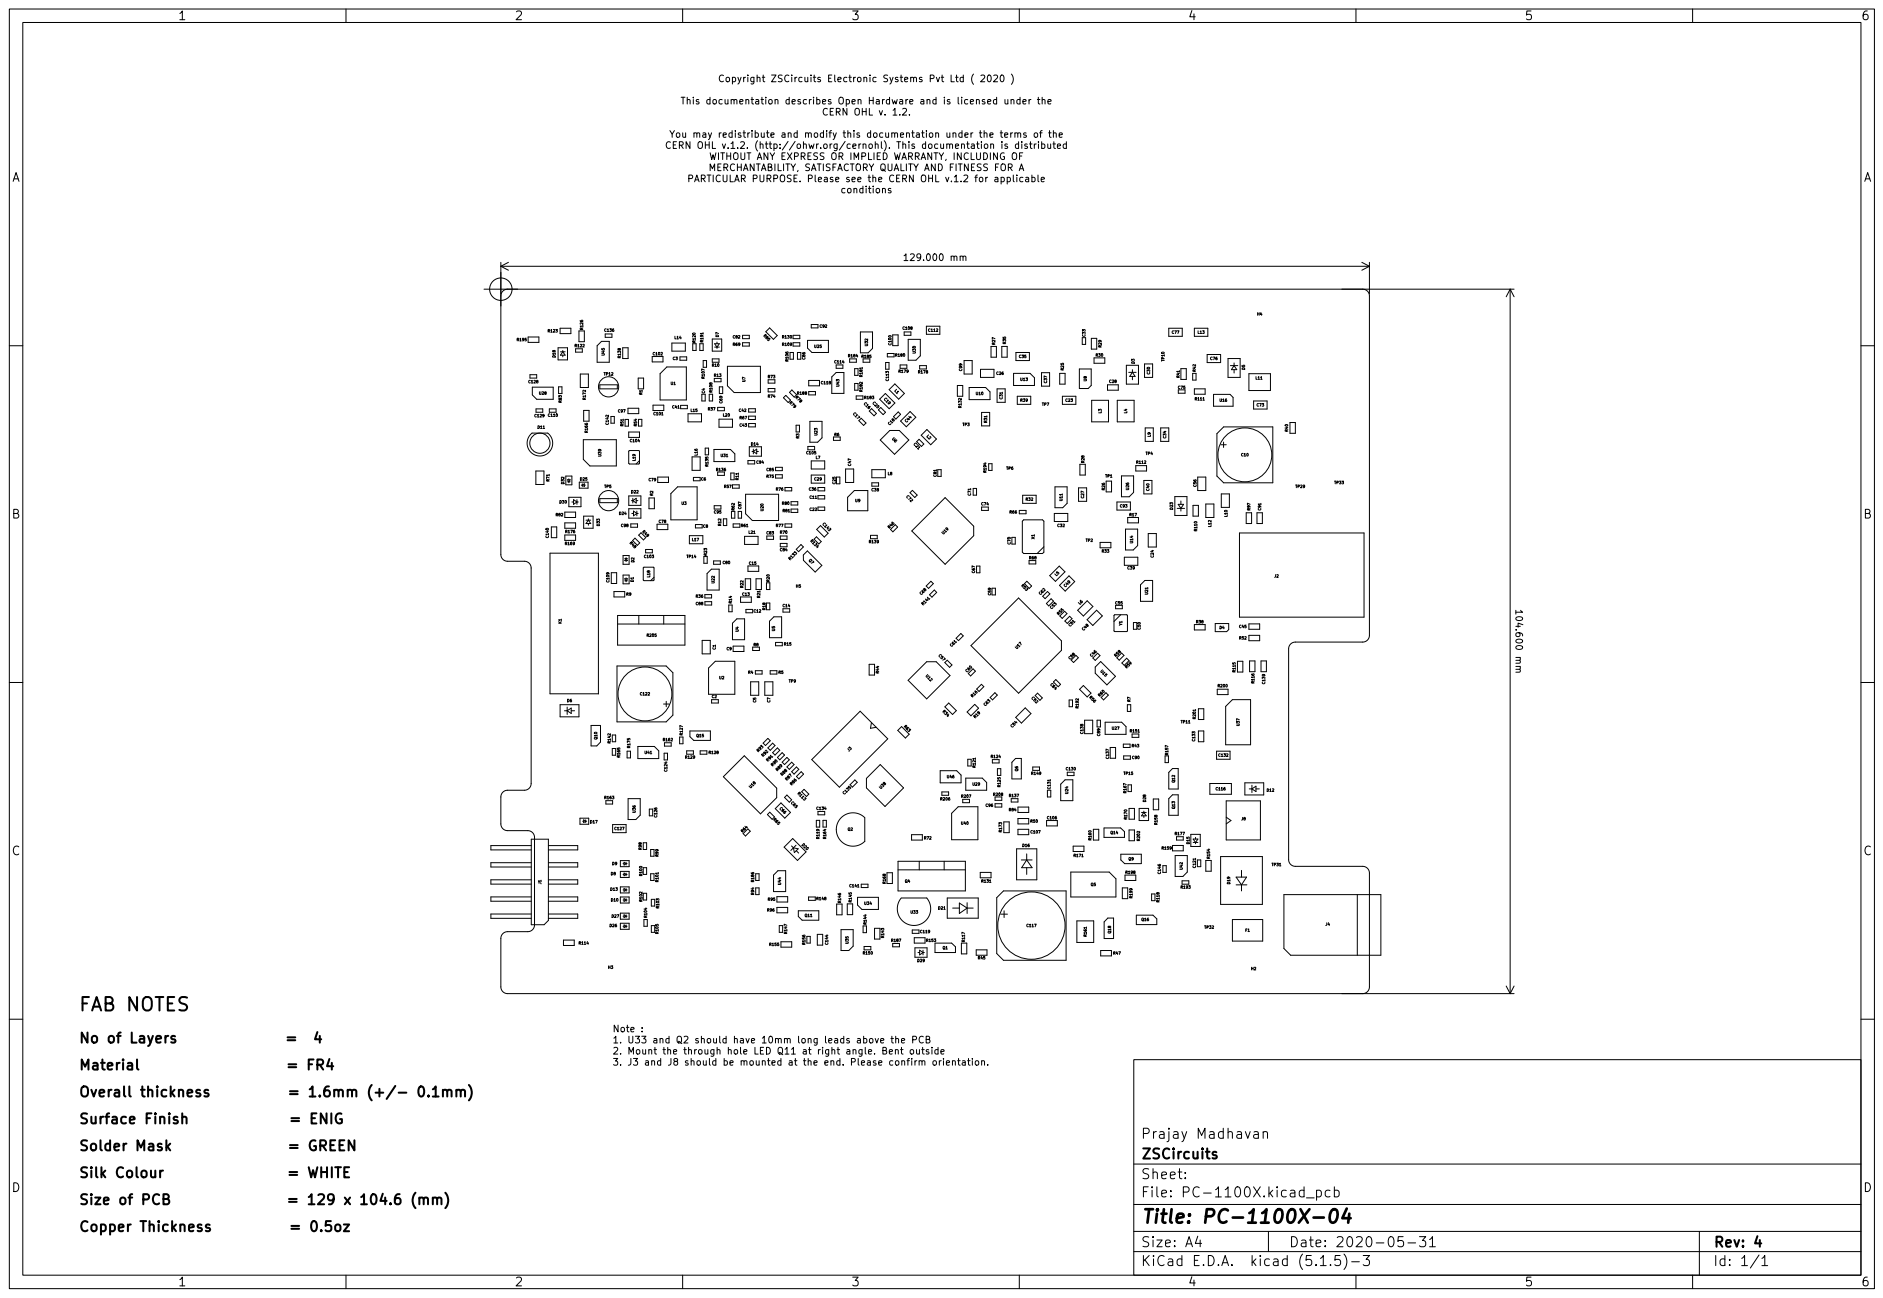
[picture p38: page 1]
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

PARTICULAR PURPOSE. Please see the CERN OHL v.1.2 for applicable

Note : 1. U33 and Q2 should have 10mm long leads above the PCB

2. Mount the through hole LED Q11 at right angle. Bent outside

File: PC-1100X.kicad_pcb Sheet: ZSCircuits Prajay Madhavan
