zscircuits/zs1100a/Hardware/Enclosure/ZS1100A-Enclosure-V7.pdf

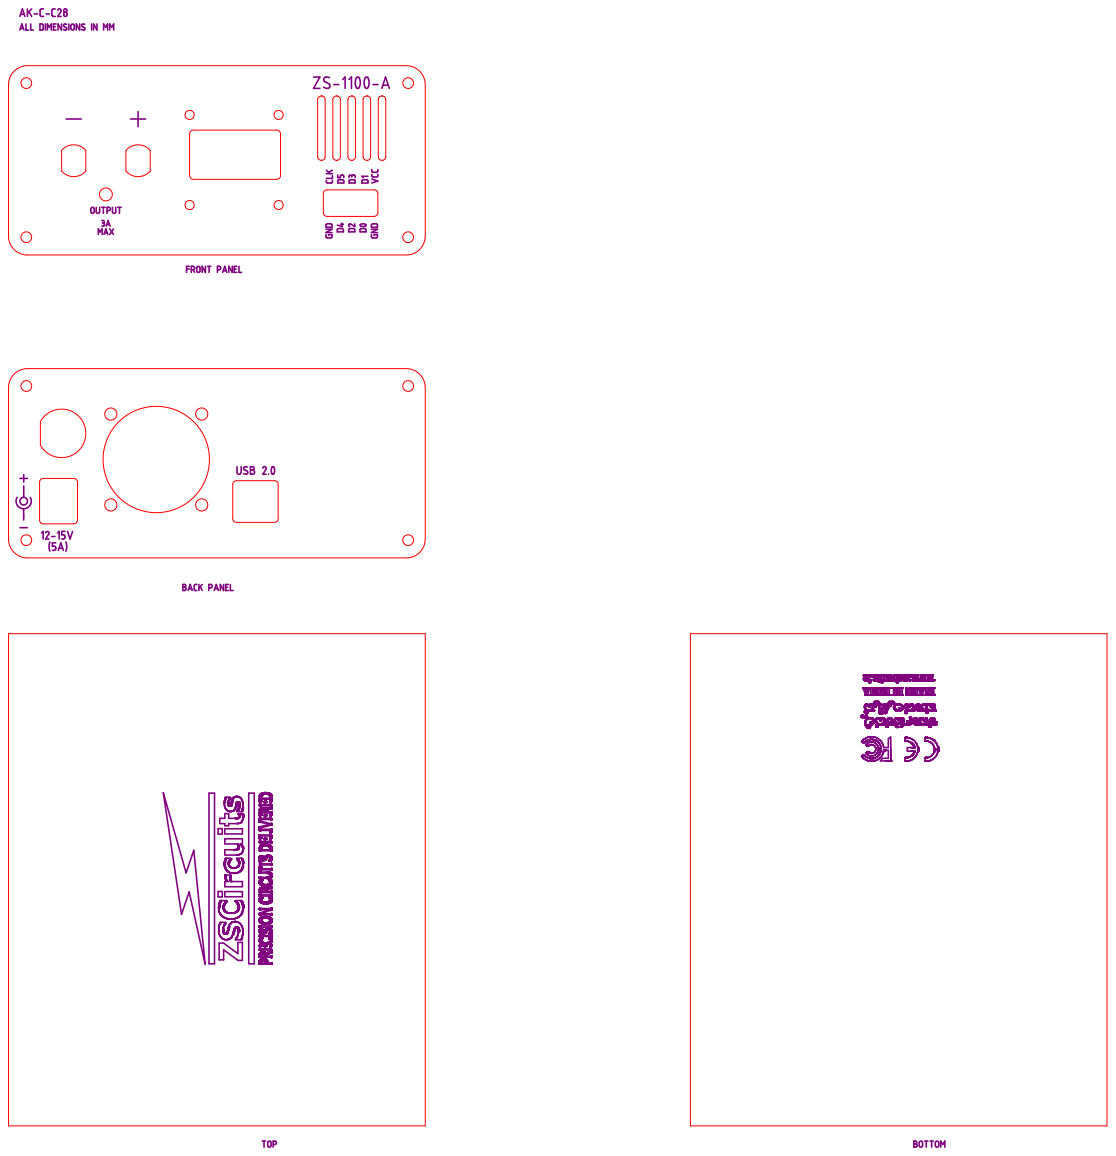
[picture p39: page 1]
