zscircuits/zs1100a/Hardware/PCB/KiCAD/PC-1100X.kicad_pcb

## KiCad design Hardware/PCB/KiCAD/PC-1100X.kicad_pcb (2020-12-06)

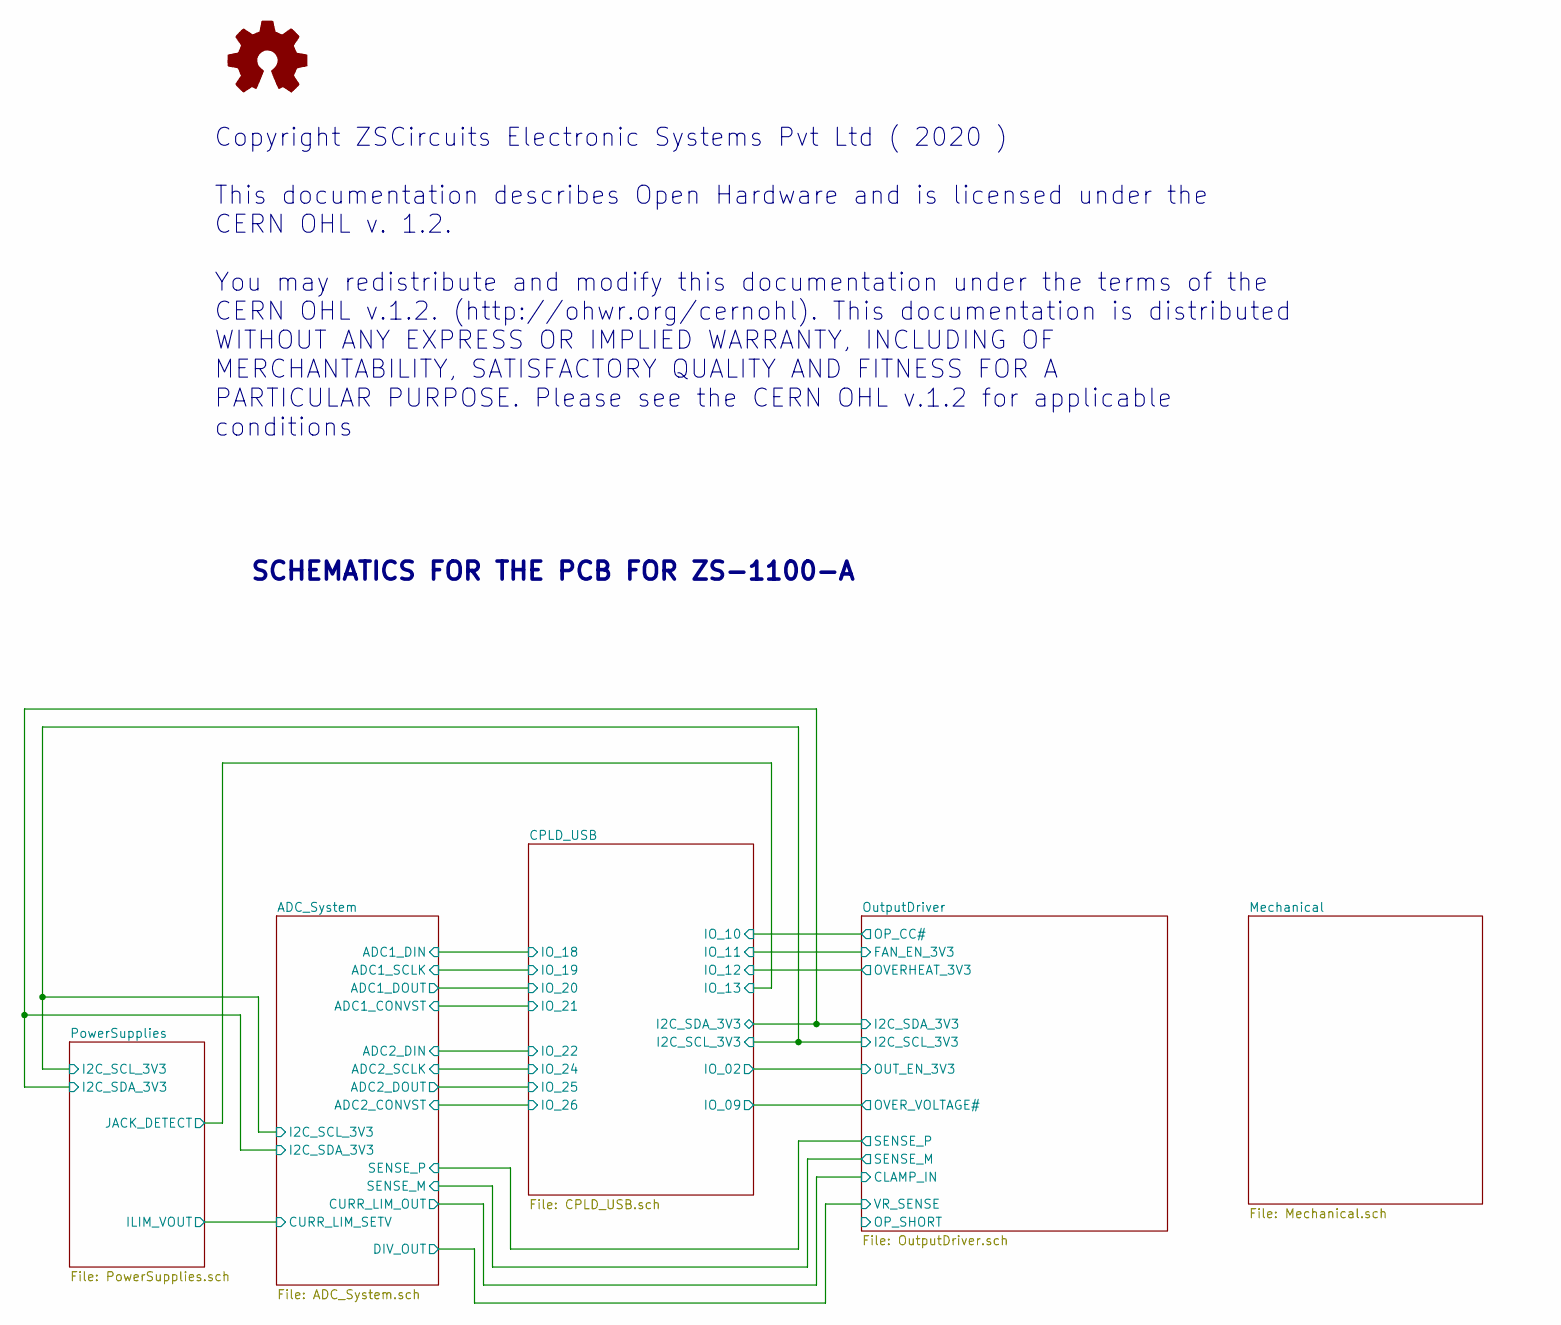
[picture p40: schematic PC-1100X.sch, PC-1100X-04]

Parts:
LOGO1: Logo_Open_Hardware_Small; OSHW-Logo2_14.6x12mm_SilkScreen

Notes on the sheet:
Copyright ZSCircuits Electronic Systems Pvt Ltd ( 2020 ) This documentation describes Open Hardware and is licensed under the CERN OHL v. 1.2. You may redistribute and modify this documentation under the terms of the CERN OHL v.1.2. (http://ohwr.org/cernohl). This documentation is distributed WITHO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
SCHEMATICS FOR THE PCB FOR ZS-1100-A

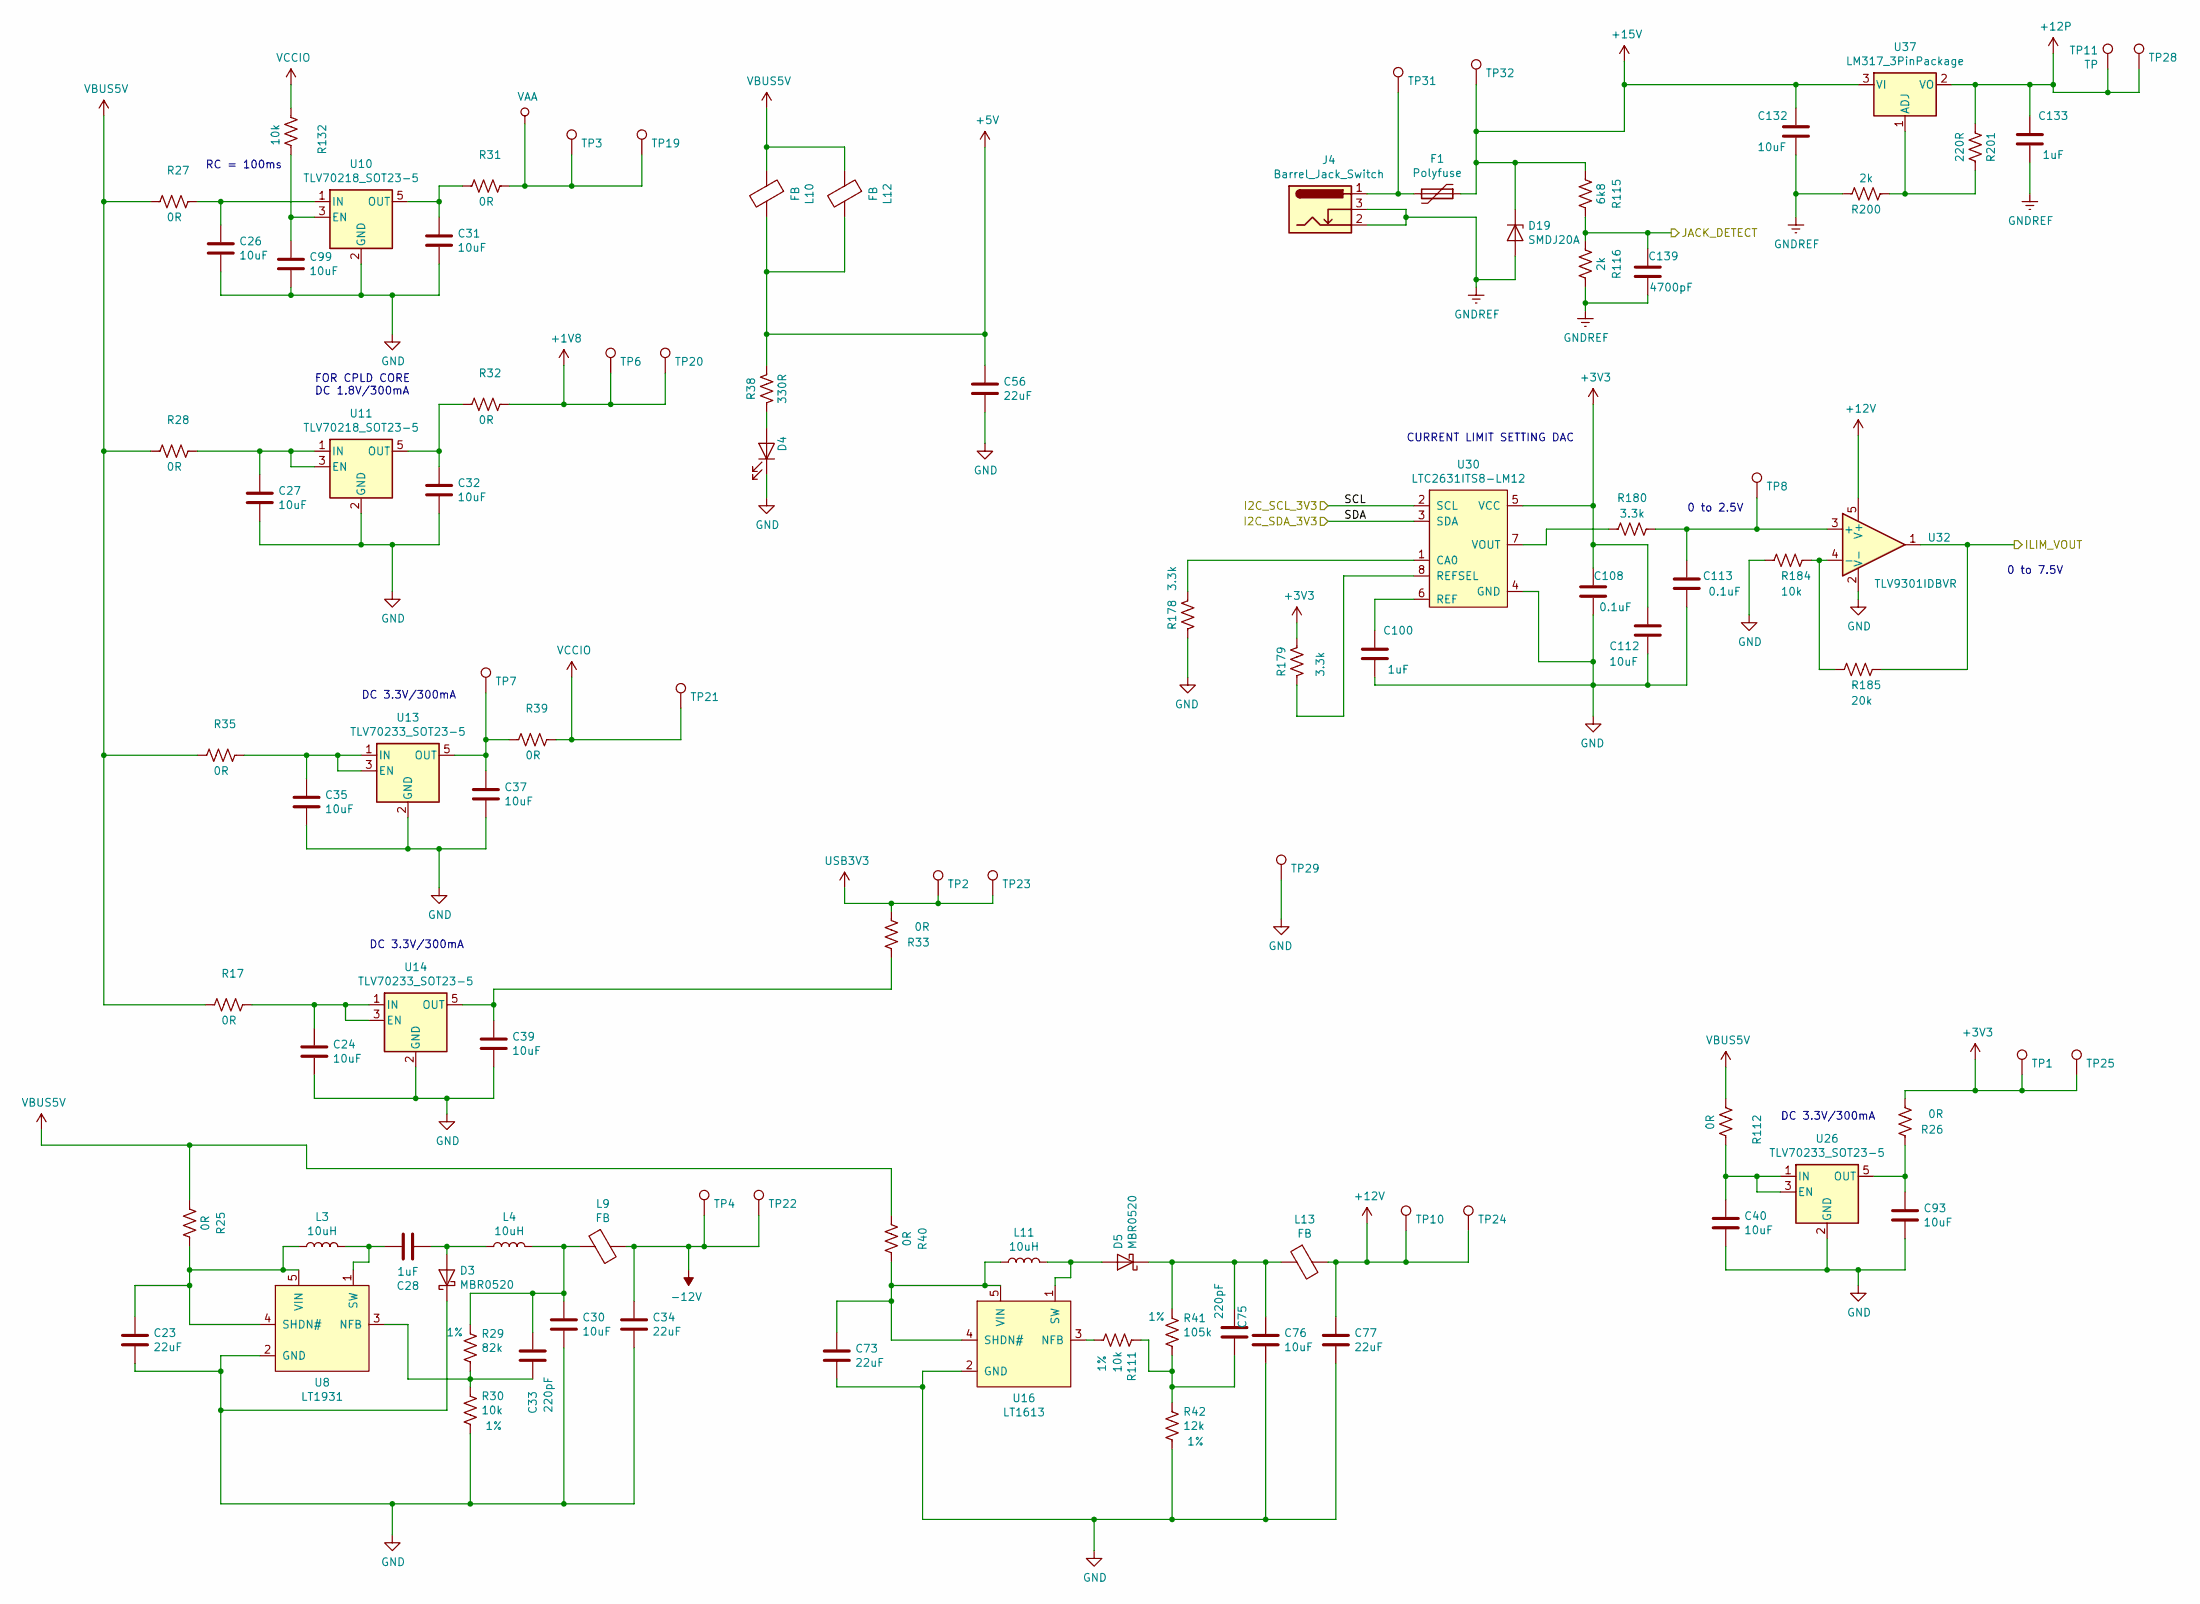
[picture p41: schematic PowerSupplies.sch, PC-1100X-04]

Parts:
C23, C34, C56, C73, C77: 22uF; C_0805_2012Metric; MPN GRM21BR61E226ME44L
C24, C26, C27, C30, C31, C32, C35, C37, C39, C40, C76, C93, C99, C112, C132: 10uF; C_0805_2012Metric; MPN TMK212BBJ106MGHT
C28, C100, C133: 1uF; C_0603_1608Metric; MPN TMK107BJ105KA-T
C33, C75: 220pF; C_0402_1005Metric; MPN CC0402JRNPO8BN221
C108, C113: 0.1uF; C_0402_1005Metric; MPN TMK105B7104MV-FR
C139: 4700pF; C_0603_1608Metric; MPN C0603C472K5RACTU
D3, D5: MBR0520; D_SOD-123; MPN MBR0520LT3G
D4: LED; LED_0805_2012Metric; MPN LTST-C170KRKT
D19: SMDJ20A; D_SMC; MPN SMDJ20A
F1: Polyfuse; R_1812_4532Metric; MPN 0ZCG0150FF2C
J4: Barrel_Jack_Switch; BarrelJack_CUI_PJ-102AH_Horizontal_3D; MPN PJ-102AH
L3, L4, L11: 10uH; L_1210_3225Metric_Pad1.42x2.65mm_HandSolder; MPN LQH32PN100MN0L
L9, L10, L12, L13: FB; L_0805_2012Metric; MPN MPZ2012S601AT000
R17, R25, R26, R27, R28, R33, R35, R40, R112: 0R; R_0603_1608Metric; Tolerance 1%; MPN RC0603JR-070RL
R29: 82k; R_0603_1608Metric; Tolerance 1%; MPN RC0603FR-0782KL
R30, R111, R132: 10k; R_0603_1608Metric; Tolerance 1%; MPN RC0603FR-0710KL
R31, R32, R39: 0R; R_0805_2012Metric; Tolerance 1%; MPN RC0805JR-070RL
R38: 330R; R_0603_1608Metric; Tolerance 1%; MPN RC0603FR-07330RL
R41: 105k; R_0603_1608Metric; Tolerance 1%; MPN RC0603FR-07105KL
R42: 12k; R_0402_1005Metric; Tolerance 1%; MPN RC0402FR-0712KL
R115: 6k8; R_0603_1608Metric; Tolerance 1%; MPN RC0603FR-076K8L
R116, R200: 2k; R_0603_1608Metric; Tolerance 1%; MPN RC0603FR-072KL
R178, R179, R180: 3.3k; R_0402_1005Metric; Tolerance 1%; MPN RC0402FR-073K3L
R184: 10k; R_0402_1005Metric; Tolerance 1%; MPN RC0402FR-0710KL
R185: 20k; R_0402_1005Metric; Tolerance 1%; MPN RC0402FR-0720KL
R201: 220R; R_0603_1608Metric; Tolerance 1%; MPN RC0603FR-07220RL
TP1, TP2, TP3, TP4, TP6, TP7, TP10: TestPoint; TestPoint_Pad_1.0x1.0mm
TP8, TP19, TP20, TP21, TP22, TP23, TP24, TP25, TP28: TestPoint; TestPoint_Pad_D1.5mm
TP11: TP; TestPoint_Pad_1.0x1.0mm
TP29, TP31, TP32: TestPoint; TestPoint_THTPad_D2.5mm_Drill1.2mm
U8: LT1931; TSOT-23-5; MPN LT1931ES5#TRPBF
U10, U11: TLV70218_SOT23-5; SOT-23-5; MPN TLV70218DBV
U13, U14, U26: TLV70233_SOT23-5; SOT-23-5; MPN TLV70233DBV
U16: LT1613; TSOT-23-5; MPN LT1613CS5#TRMPBF
U30: LTC2631ITS8-LM12; SOT-23-8; MPN LTC2631ITS8-LM12#TRMPBF
U32: TLV9301IDBVR; SOT-23-5; MPN TLV9301IDBVR
U37: LM317_3PinPackage; SOT-223-3_TabPin2; MPN LM317MSTT3G

Connections:
+1V8: R32.1, TP6.1, TP20.1; also elsewhere on the board
+3V3: C108.1, C112.1, R26.2, R179.1, TP1.1, TP25.1, U30.5 (VCC); also elsewhere on the board
+5V: C56.1, L10.2, L12.2, R38.1; also elsewhere on the board
+12P: C133.1, R201.1, TP11.1, TP28.1, U37.2 (VO); also elsewhere on the board
+12V: C77.1, L13.2, TP10.1, TP24.1, U32.5 (V+); also elsewhere on the board
+15V: C132.1, D19.1 (K), F1.1, R115.1, TP32.1, U37.3 (VI); also elsewhere on the board
-12V: C34.1, L9.2, TP4.1, TP22.1; also elsewhere on the board
/ADC_System/CURR_LIM_SETV: R185.2, U32.1; also elsewhere on the board
/ADC_System/I2C_SCL_3V3: U30.2 (SCL); also elsewhere on the board
/ADC_System/I2C_SDA_3V3: U30.3 (SDA); also elsewhere on the board
/CPLD_USB/IO_13: C139.2, R115.2, R116.1; also elsewhere on the board
GND: C23.2, C24.2, C26.2, C27.2, C30.2, C31.2, C32.2, C34.2, C35.2, C37.2, C39.2, C40.2, C56.2, C73.2, C76.2, C77.2, C93.2, C99.2, C100.2, C108.2, C112.2, C113.2, D3.1 (K), D4.1 (K), R30.2, R42.2, R178.2, R184.1, TP29.1, U8.2 (GND), U10.2 (GND), U11.2 (GND), U13.2 (GND), U14.2 (GND), U16.2 (GND), U26.2 (GND), U30.4 (GND), U32.2 (V-); also elsewhere on the board
GNDREF: C132.2, C133.2, C139.1, D19.2 (A), J4.2, J4.3, R116.2, R200.2; also elsewhere on the board
unnamed: C23.1, L3.1, R25.2, U8.4 (SHDN#), U8.5 (VIN)
unnamed: C24.1, R17.1, U14.1 (IN), U14.3 (EN)
unnamed: C26.1, R27.1, U10.1 (IN)
unnamed: C27.1, R28.1, U11.1 (IN), U11.3 (EN)
unnamed: C28.1, L3.2, U8.1 (SW)
unnamed: C28.2, D3.2 (A), L4.1
unnamed: C30.1, C33.1, L4.2, L9.1, R29.1
unnamed: C31.1, R31.2, U10.5 (OUT)
unnamed: C32.1, R32.2, U11.5 (OUT)
unnamed: C33.2, R29.2, R30.1, U8.3 (NFB)
unnamed: C35.1, R35.1, U13.1 (IN), U13.3 (EN)
unnamed: C37.1, R39.2, TP7.1, U13.5 (OUT)
unnamed: C39.1, R33.1, U14.5 (OUT)
unnamed: C40.1, R112.1, U26.1 (IN), U26.3 (EN)
unnamed: C73.1, L11.1, R40.2, U16.4 (SHDN#), U16.5 (VIN)
unnamed: C75.1, C76.1, D5.1 (K), L13.1, R41.1
unnamed: C75.2, R41.2, R42.1, R111.1
unnamed: C93.1, R26.1, U26.5 (OUT)
unnamed: C99.1, R132.1, U10.3 (EN)
unnamed: C100.1, U30.6 (REF)
unnamed: C113.1, R180.2, TP8.1, U32.3 (+)
unnamed: D4.2 (A), R38.2
unnamed: D5.2 (A), L11.2, U16.1 (SW)
unnamed: F1.2, J4.1, TP31.1
unnamed: R111.2, U16.3 (NFB)
unnamed: R178.1, U30.1 (CA0)
unnamed: R179.2, U30.8 (REFSEL)
unnamed: R180.1, U30.7 (VOUT)
unnamed: R184.2, R185.1, U32.4 (-)
unnamed: R200.1, R201.2, U37.1 (ADJ)
USB3V3: R33.2, TP2.1, TP23.1; also elsewhere on the board
VAA: R31.1, TP3.1, TP19.1; also elsewhere on the board
VBUS5V: L10.1, L12.1, R17.2, R25.1, R27.2, R28.2, R35.2, R40.1, R112.2; also elsewhere on the board
VCCIO: R39.1, R132.2, TP21.1; also elsewhere on the board

Notes on the sheet:
FOR CPLD CORE DC 1.8V/300mA
DC 3.3V/300mA
RC = 100ms
0 to 2.5V
0 to 7.5V
CURRENT LIMIT SETTING DAC

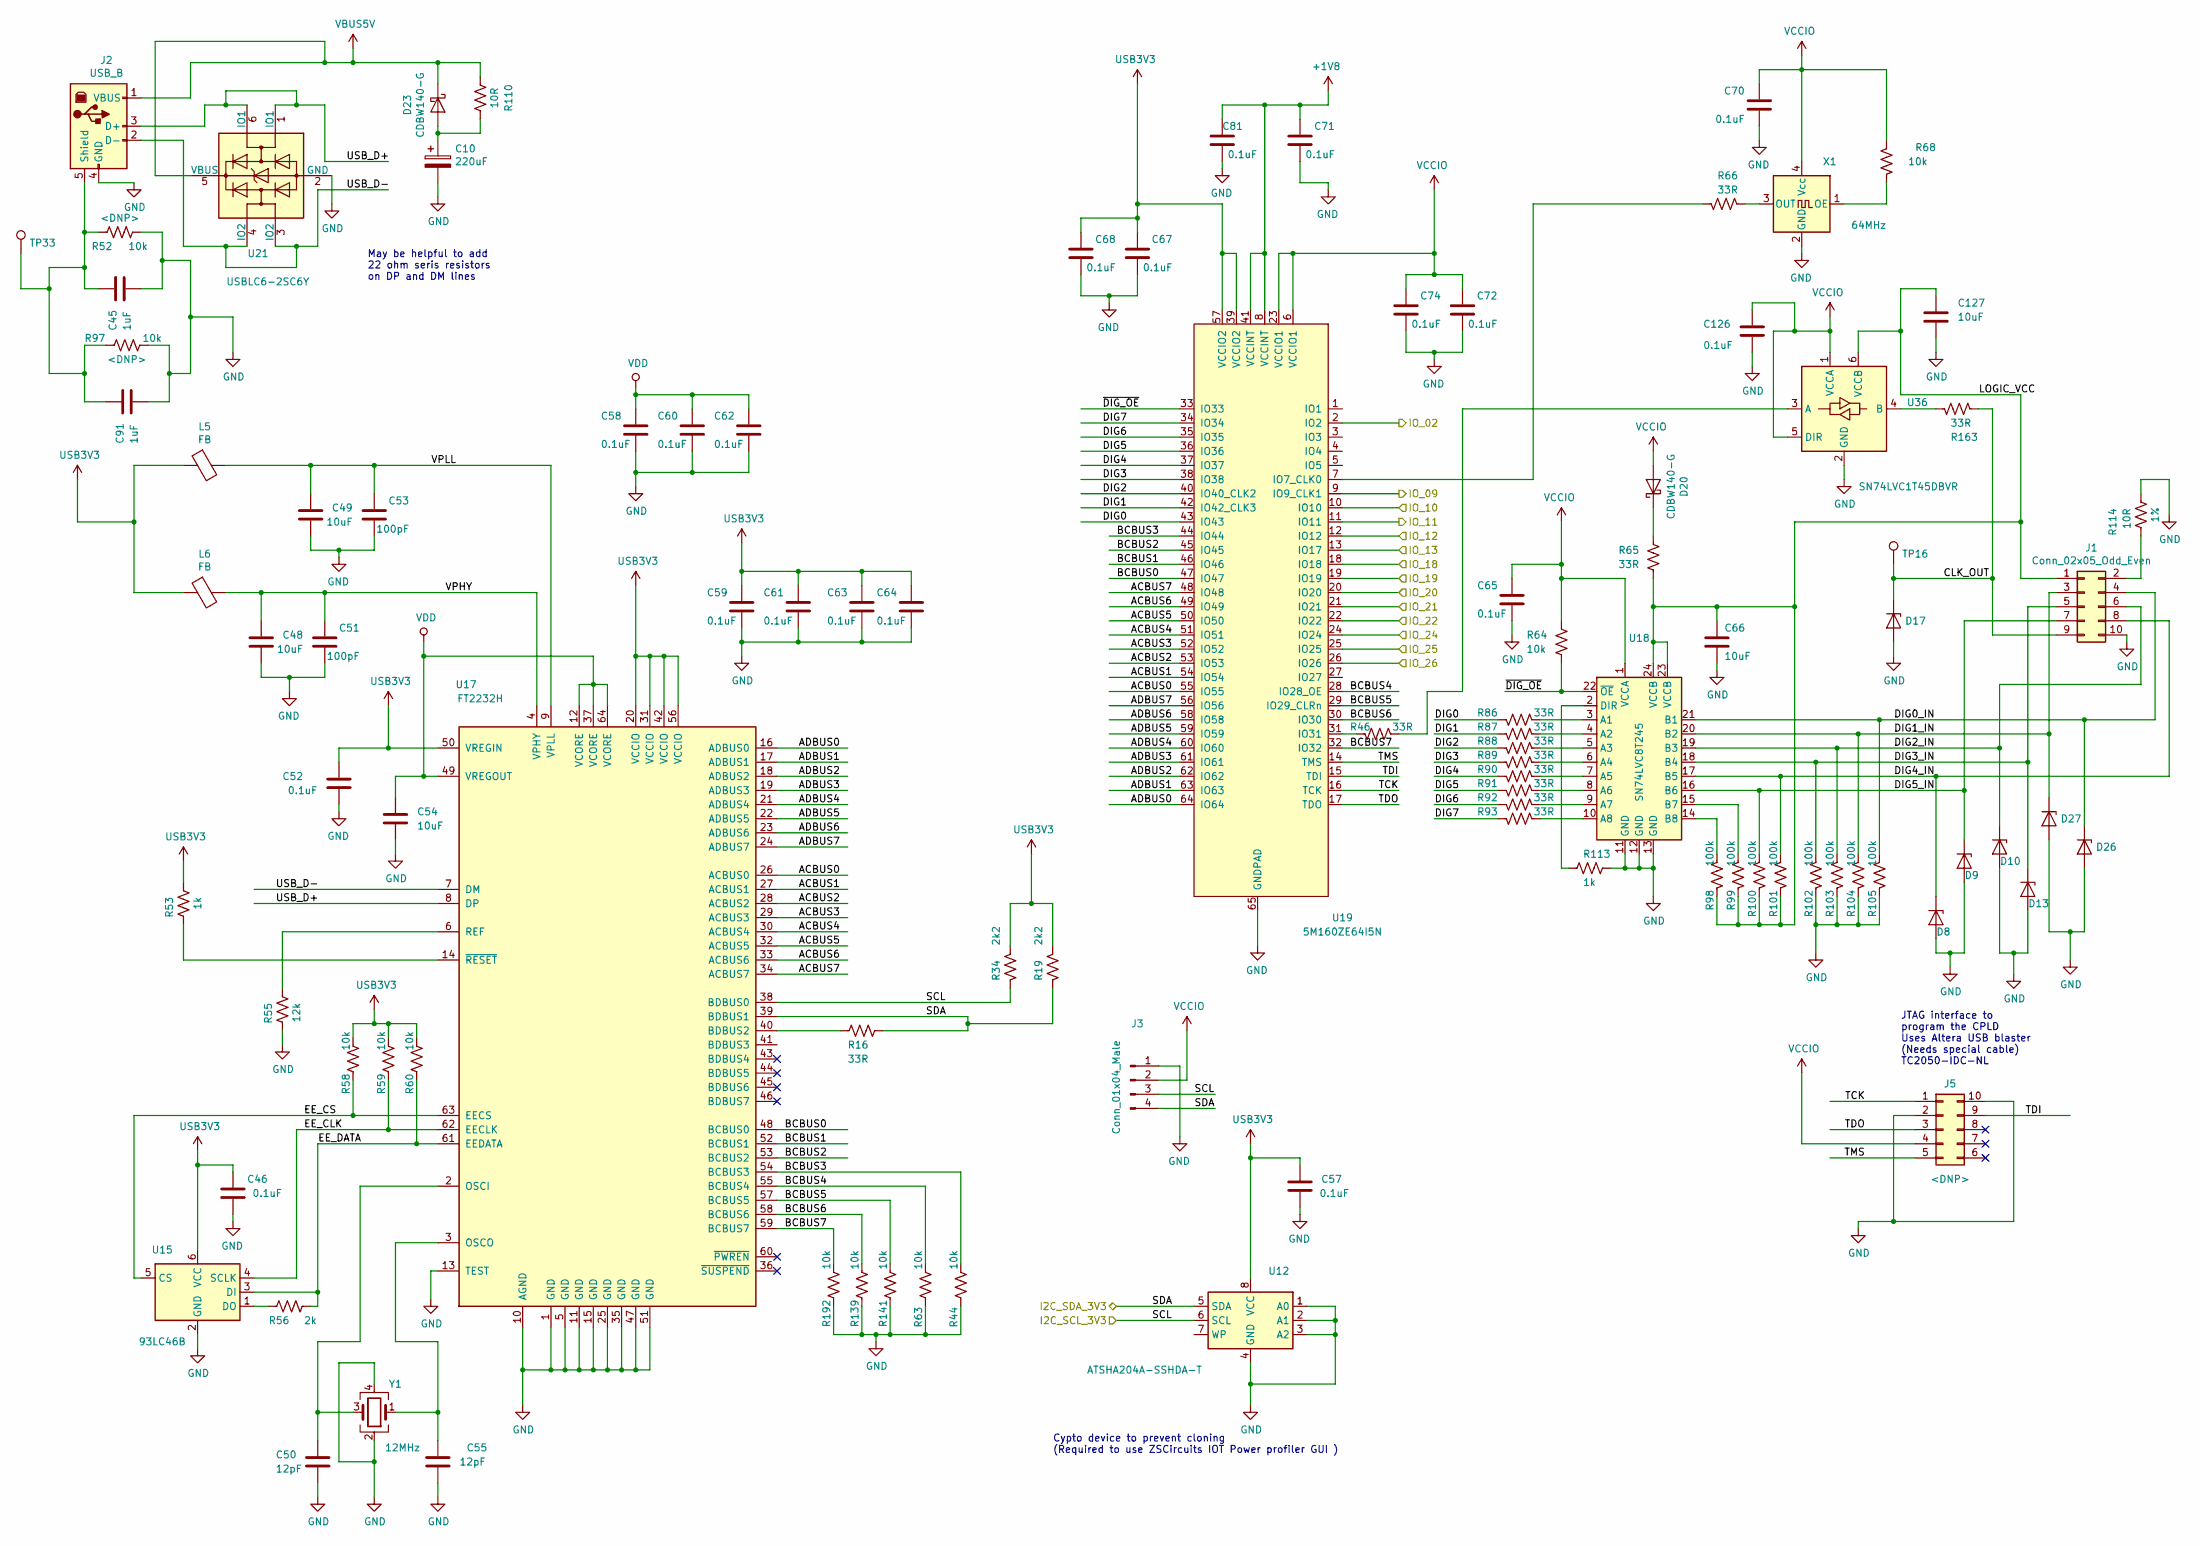
[picture p42: schematic CPLD_USB.sch, PC-1100X-04]

Parts:
C10: 220uF; CP_Elec_8x10; MPN UWT1E221MNL1GS
C45, C91: 1uF; C_0603_1608Metric; MPN TMK107BJ105KA-T
C46, C52, C57, C58, C59, C60, C61, C62, C63, C64, C65, C67, C68, C70, C71, C72, C74, C81, C126: 0.1uF; C_0402_1005Metric; MPN TMK105B7104MV-FR
C48, C49, C54, C66, C127: 10uF; C_0805_2012Metric; MPN TMK212BBJ106MGHT
C50, C55: 12pF; C_0402_1005Metric; MPN GJM1555C1H120FB01D
C51, C53: 100pF; C_0402_1005Metric; MPN C0402C101J3GACTU
D8, D9, D10, D13, D17, D26, D27: ESD5Z12T1G; D_SOD-523; MPN ESD5Z12T1G
D20, D23: CDBW140-G; D_SOD-123; MPN CDBW140-G
J1: Conn_02x05_Odd_Even; PinHeader_2x05_P2.54mm_Horizontal; MPN 10129382-910001BLF
J2: USB_B; USB2p0_TypeB_Standard; MPN SS-52300-001
J3: Conn_01x04_Male; Molex_KK-254_AE-6410-04A_1x04_P2.54mm_Vertical; MPN 22-27-2041
J5: Conn_02x05_Counter_Clockwise; Tag-Connect_TC2050-IDC-NL_2x05_P1.27mm_Vertical
L5, L6: FB; L_0805_2012Metric; MPN MPZ2012S601AT000
R16, R46, R65, R66, R86, R87, R88, R89, R90, R91, R92, R93, R163: 33R; R_0402_1005Metric; Tolerance 1%; MPN RC0402FR-0733RL
R19, R34: 2k2; R_0603_1608Metric; Tolerance 1%; MPN RC0603FR-072K2L
R44, R52, R63, R97: 10k; R_0603_1608Metric; Tolerance 1%; MPN RC0603FR-0710KL
R53, R113: 1k; R_0402_1005Metric; Tolerance 1%; MPN RC0402FR-071KL
R55: 12k; R_0402_1005Metric; Tolerance 1%; MPN RC0402FR-0712KL
R56: 2k; R_0603_1608Metric; Tolerance 1%; MPN RC0603FR-072KL
R58, R59, R60, R64, R68, R139, R141, R192: 10k; R_0402_1005Metric; Tolerance 1%; MPN RC0402FR-0710KL
R98, R99, R100, R101, R102, R103, R104, R105: 100k; R_0402_1005Metric; Tolerance 1%; MPN RC0402FR-07100KL
R110, R114: 10R; R_0603_1608Metric; Tolerance 1%; MPN RC0603FR-0710RL
TP16: TestPoint; TestPoint_Pad_D1.5mm
TP33: TestPoint; TestPoint_THTPad_D2.5mm_Drill1.2mm
U12: ATSHA204A-SSHDA-T; SOIC-8_3.9x4.9mm_P1.27mm; MPN ATSHA204A-SSHDA-T
U15: 93LC46B; SOT-23-6; MPN 93LC46BT-I/OT
U17: FT2232H; LQFP-64_10x10mm_P0.5mm; MPN FT2232HL-REEL
U18: SN74LVC8T245; TSSOP-24_4.4x7.8mm_P0.65mm; MPN SN74LVC8T245PW
U19: 5M160ZE64I5N; EQFP-64_1EP_7x7mm_P0.4mm_SM; MPN 5M160ZE64I5N
U21: USBLC6-2SC6Y; SOT-23-6; MPN USBLC6-2SC6Y
U36: SN74LVC1T45DBVR; SOT-23-6; MPN SN74LVC1T45DBV
X1: 64MHz; Oscillator_SMD_TXC_7C-4Pin_5.0x3.2mm; Tolerance 50ppm; MPN KC5032A64.0000C10E00
Y1: Crystal 12MHz; Crystal_SMD_2520-4Pin_2.5x2.0mm; Tolerance 10ppm/10ppm; MPN ABM10-166-12.000MHZ-T3

Connections:
+1V8: C71.1, C81.1, U19.8 (VCCINT), U19.41 (VCCINT); also elsewhere on the board
/ADC_System/ADC1_CONVST: U19.21 (IO21); also elsewhere on the board
/ADC_System/ADC1_DIN: U19.18 (IO18); also elsewhere on the board
/ADC_System/ADC1_DOUT: U19.20 (IO20); also elsewhere on the board
/ADC_System/ADC1_SCLK: U19.19 (IO19); also elsewhere on the board
/ADC_System/ADC2_CONVST: U19.26 (IO26); also elsewhere on the board
/ADC_System/ADC2_DIN: U19.22 (IO22); also elsewhere on the board
/ADC_System/ADC2_DOUT: U19.25 (IO25); also elsewhere on the board
/ADC_System/ADC2_SCLK: U19.24 (IO24); also elsewhere on the board
/ADC_System/I2C_SCL_3V3: J3.3, R34.2, U12.6 (SCL), U17.38 (BDBUS0); also elsewhere on the board
/ADC_System/I2C_SDA_3V3: J3.4, R16.2, R19.2, U12.5 (SDA), U17.39 (BDBUS1); also elsewhere on the board
/CPLD_USB/ACBUS0: U17.26 (ACBUS0), U19.55 (IO55)
/CPLD_USB/ACBUS1: U17.27 (ACBUS1), U19.54 (IO54)
/CPLD_USB/ACBUS2: U17.28 (ACBUS2), U19.53 (IO53)
/CPLD_USB/ACBUS3: U17.29 (ACBUS3), U19.52 (IO52)
/CPLD_USB/ACBUS4: U17.30 (ACBUS4), U19.51 (IO51)
/CPLD_USB/ACBUS5: U17.32 (ACBUS5), U19.50 (IO50)
/CPLD_USB/ACBUS6: U17.33 (ACBUS6), U19.49 (IO49)
/CPLD_USB/ACBUS7: U17.34 (ACBUS7), U19.48 (IO48)
/CPLD_USB/ADBUS0: U17.16 (ADBUS0), U19.64 (IO64)
/CPLD_USB/ADBUS1: U17.17 (ADBUS1), U19.63 (IO63)
/CPLD_USB/ADBUS2: U17.18 (ADBUS2), U19.62 (IO62)
/CPLD_USB/ADBUS3: U17.19 (ADBUS3), U19.61 (IO61)
/CPLD_USB/ADBUS4: U17.21 (ADBUS4), U19.60 (IO60)
/CPLD_USB/ADBUS5: U17.22 (ADBUS5), U19.59 (IO59)
/CPLD_USB/ADBUS6: U17.23 (ADBUS6), U19.58 (IO58)
/CPLD_USB/ADBUS7: U17.24 (ADBUS7), U19.56 (IO56)
/CPLD_USB/BCBUS0: U17.48 (BCBUS0), U19.47 (IO47)
/CPLD_USB/BCBUS1: U17.52 (BCBUS1), U19.46 (IO46)
/CPLD_USB/BCBUS2: U17.53 (BCBUS2), U19.45 (IO45)
/CPLD_USB/BCBUS3: R44.2, U17.54 (BCBUS3), U19.44 (IO44)
/CPLD_USB/BCBUS4: R63.2, U17.55 (BCBUS4), U19.28 (IO28_OE)
/CPLD_USB/BCBUS5: R141.2, U17.57 (BCBUS5), U19.29 (IO29_CLRn)
/CPLD_USB/BCBUS6: R139.2, U17.58 (BCBUS6), U19.30 (IO30)
/CPLD_USB/BCBUS7: R192.2, U17.59 (BCBUS7), U19.32 (IO32)
/CPLD_USB/CLK_OUT: D17.1 (K), J1.9, R163.1, TP16.1
/CPLD_USB/DIG0: R86.2, U19.43 (IO43)
/CPLD_USB/DIG0_IN: D26.1 (K), J1.4, R105.2, U18.21 (B1)
/CPLD_USB/DIG1: R87.2, U19.42 (IO42_CLK3)
/CPLD_USB/DIG1_IN: D27.1 (K), J1.3, R104.2, U18.20 (B2)
/CPLD_USB/DIG2: R88.2, U19.40 (IO40_CLK2)
/CPLD_USB/DIG2_IN: D10.1 (K), J1.6, R103.2, U18.19 (B3)
/CPLD_USB/DIG3: R89.2, U19.38 (IO38)
/CPLD_USB/DIG3_IN: D13.1 (K), J1.5, R102.2, U18.18 (B4)
/CPLD_USB/DIG4: R90.2, U19.37 (IO37)
/CPLD_USB/DIG4_IN: D8.1 (K), J1.8, R101.2, U18.17 (B5)
/CPLD_USB/DIG5: R91.2, U19.36 (IO36)
/CPLD_USB/DIG5_IN: D9.1 (K), J1.7, R100.2, U18.16 (B6)
/CPLD_USB/DIG6: R92.2, U19.35 (IO35)
/CPLD_USB/DIG7: R93.2, U19.34 (IO34)
/CPLD_USB/EE_CLK: R59.1, U15.4 (SCLK), U17.62 (EECLK)
/CPLD_USB/EE_CS: R58.1, U15.5 (CS), U17.63 (EECS)
/CPLD_USB/EE_DATA: R56.1, R60.1, U15.3 (DI), U17.61 (EEDATA)
/CPLD_USB/IO_02: U19.2 (IO2); also elsewhere on the board
/CPLD_USB/IO_09: U19.9 (IO9_CLK1); also elsewhere on the board
/CPLD_USB/IO_10: U19.10 (IO10); also elsewhere on the board
/CPLD_USB/IO_12: U19.12 (IO12); also elsewhere on the board
/CPLD_USB/IO_13: U19.13 (IO17); also elsewhere on the board
/CPLD_USB/LOGIC_VCC: C66.1, C127.1, J1.1, R65.2, R98.1, R99.1, R100.1, R101.1, U18.23 (VCCB), U18.24 (VCCB), U36.6 (VCCB)
/CPLD_USB/TCK: J5.1, U19.16 (TCK)
/CPLD_USB/TDI: J5.9, U19.15 (TDI)
/CPLD_USB/TDO: J5.3, U19.17 (TDO)
/CPLD_USB/TMS: J5.5, U19.14 (TMS)
/CPLD_USB/USB_D+: J2.3 (D+), U17.8 (DP), U21.1 (IO1), U21.6 (IO1)
/CPLD_USB/USB_D-: J2.2 (D-), U17.7 (DM), U21.3 (IO2), U21.4 (IO2)
/CPLD_USB/VPHY: C48.1, C51.1, L6.2, U17.4 (VPHY)
/CPLD_USB/VPLL: C49.1, C53.1, L5.2, U17.9 (VPLL)
/CPLD_USB/~DIG_OE: R64.2, U18.22 (~OE), U19.33 (IO33)
/OutputDriver/FAN_EN_3V3: U19.11 (IO11); also elsewhere on the board
GND: C10.2, C45.2, C46.2, C48.2, C49.2, C50.2, C51.2, C52.2, C53.2, C54.2, C55.2, C57.2, C58.2, C59.2, C60.2, C61.2, C62.2, C63.2, C64.2, C65.2, C66.2, C67.2, C68.2, C70.2, C71.2, C72.2, C74.2, C81.2, C91.2, C126.2, C127.2, D8.2 (A), D9.2 (A), D10.2 (A), D13.2 (A), D17.2 (A), D26.2 (A), D27.2 (A), J1.10, J2.4 (GND), J3.1, J5.2, J5.10, R44.1, R52.2, R55.1, R63.1, R97.2, R102.1, R103.1, R104.1, R105.1, R113.1, R114.2, R139.1, R141.1, R192.1, U12.1 (A0), U12.2 (A1), U12.3 (A2), U12.4 (GND), U15.2 (GND), U17.1 (GND), U17.5 (GND), U17.10 (AGND), U17.11 (GND), U17.13 (TEST), U17.15 (GND), U17.25 (GND), U17.35 (GND), U17.47 (GND), U17.51 (GND), U18.11 (GND), U18.12 (GND), U18.13 (GND), U19.65 (GNDPAD), U21.2 (GND), U36.2 (GND), X1.2 (GND), Y1.2, Y1.4; also elsewhere on the board
unnamed: C10.1, D23.2 (A), R110.2
unnamed: C45.1, C91.1, J2.5 (Shield), R52.1, R97.1, TP33.1
unnamed: C50.1, U17.2 (OSCI), Y1.3
unnamed: C55.1, U17.3 (OSCO), Y1.1
unnamed: D20.1 (K), R65.1
unnamed: J1.2, R114.1
unnamed: R16.1, U17.40 (BDBUS2)
unnamed: R46.1, U36.3 (A)
unnamed: R46.2, U19.31 (IO31)
unnamed: R53.1, U17.14 (~RESET)
unnamed: R55.2, U17.6 (REF)
unnamed: R56.2, U15.1 (DO)
unnamed: R66.1, X1.3 (OUT)
unnamed: R66.2, U19.7 (IO7_CLK0)
unnamed: R68.1, X1.1 (OE)
unnamed: R86.1, U18.3 (A1)
unnamed: R87.1, U18.4 (A2)
unnamed: R88.1, U18.5 (A3)
unnamed: R89.1, U18.6 (A4)
unnamed: R90.1, U18.7 (A5)
unnamed: R91.1, U18.8 (A6)
unnamed: R92.1, U18.9 (A7)
unnamed: R93.1, U18.10 (A8)
unnamed: R98.2, U18.14 (B8)
unnamed: R99.2, U18.15 (B7)
unnamed: R113.2, U18.2 (DIR)
unnamed: R163.2, U36.4 (B)
USB3V3: C46.1, C52.1, C57.1, C59.1, C61.1, C63.1, C64.1, C67.1, C68.1, L5.1, L6.1, R19.1, R34.1, R53.2, R58.2, R59.2, R60.2, U12.8 (VCC), U15.6 (VCC), U17.20 (VCCIO), U17.31 (VCCIO), U17.42 (VCCIO), U17.50 (VREGIN), U17.56 (VCCIO), U19.39 (VCCIO2), U19.57 (VCCIO2); also elsewhere on the board
VBUS5V: D23.1 (K), J2.1 (VBUS), R110.1, U21.5 (VBUS); also elsewhere on the board
VCCIO: C65.1, C70.1, C72.1, C74.1, C126.1, D20.2 (A), J3.2, J5.4, R64.1, R68.2, U18.1 (VCCA), U19.6 (VCCIO1), U19.23 (VCCIO1), U36.1 (VCCA), U36.5 (DIR), X1.4 (Vcc); also elsewhere on the board
VDD: C54.1, C58.1, C60.1, C62.1, U17.12 (VCORE), U17.37 (VCORE), U17.49 (VREGOUT), U17.64 (VCORE)

Notes on the sheet:
May be helpful to add 22 ohm seris resistors on DP and DM lines
Cypto device to prevent cloning (Required to use ZSCircuits IOT Power profiler GUI )
JTAG interface to program the CPLD Uses Altera USB blaster (Needs special cable) TC2050-IDC-NL
