zscircuits/zs1100a/Hardware/PCB/KiCAD/PC-1100X.kicad_pcb

## KiCad design Hardware/PCB/KiCAD/PC-1100X.kicad_pcb (continued)

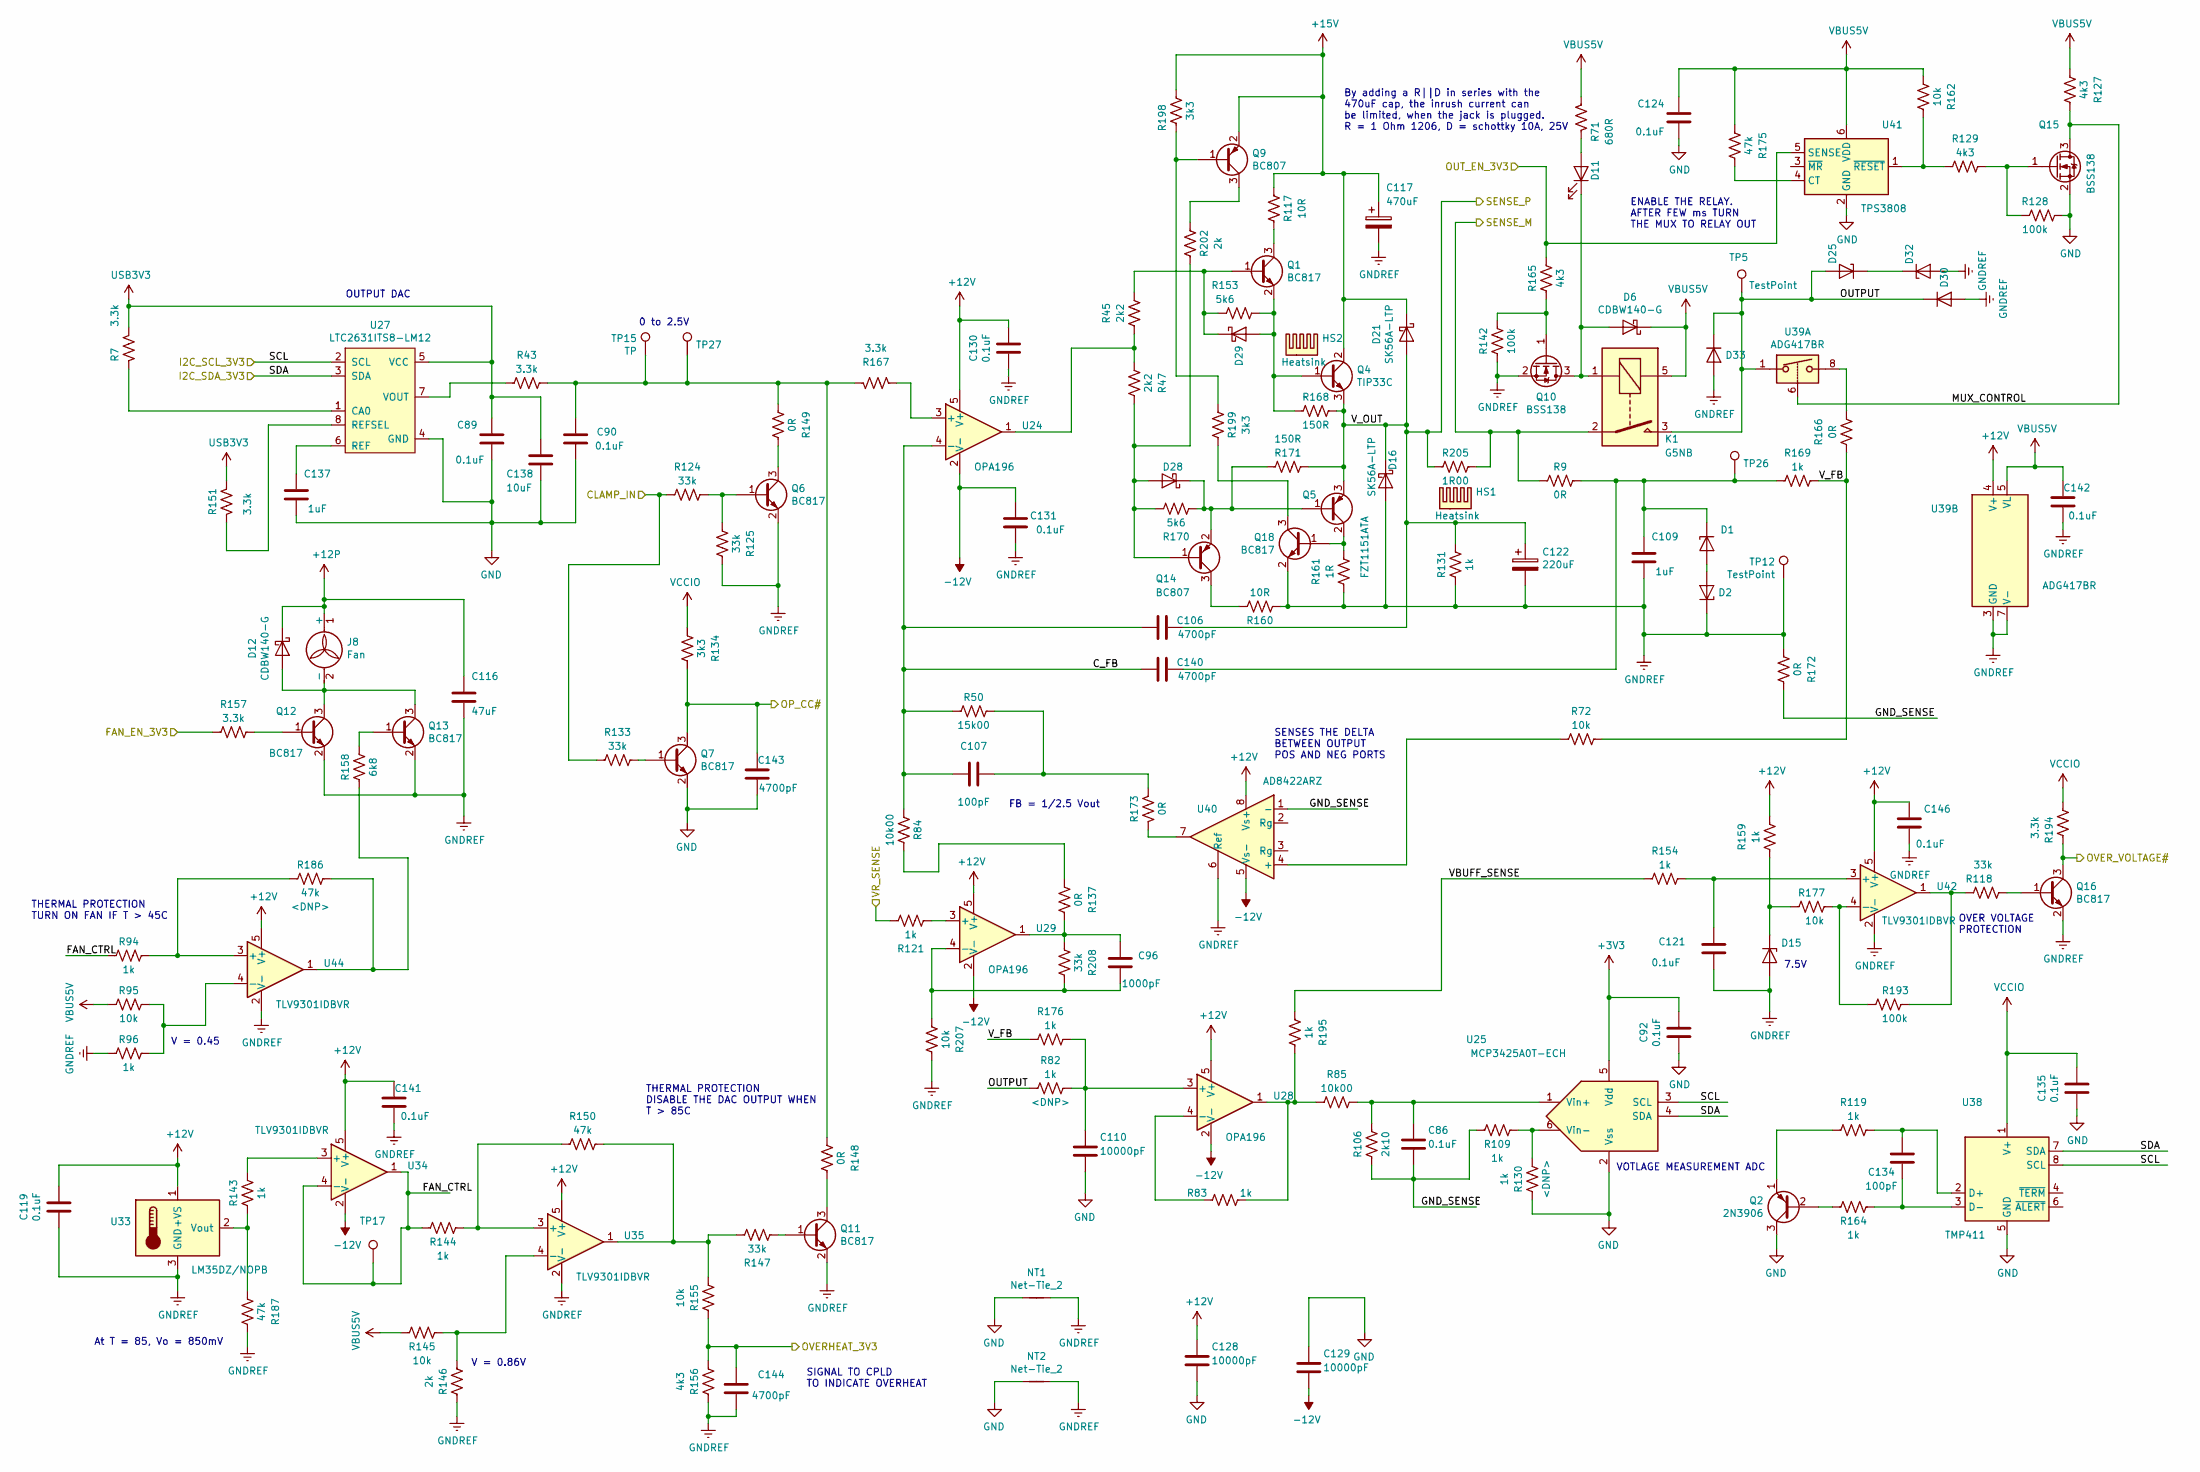
[picture p43: schematic OutputDriver.sch, PC-1100X-04]

Parts:
C86, C89, C90, C92, C119, C121, C124, C130, C131, C135, C141, C142, C146: 0.1uF; C_0402_1005Metric; MPN TMK105B7104MV-FR
C96: 1000pF; C_0402_1005Metric; MPN C0402C102J5RAC7411
C106, C140, C143, C144: 4700pF; C_0603_1608Metric; MPN C0603C472K5RACTU
C107: 100pF; C_0603_1608Metric; MPN C0603C101K5RACTU
C109, C137: 1uF; C_0603_1608Metric; MPN TMK107BJ105KA-T
C110, C128, C129: 10000pF; C_0402_1005Metric; MPN TMF105B7103MVHF
C116: 47uF; C_1206_3216Metric; MPN EMK316BBJ476ML-T
C117: 470uF; CP_Elec_10x10; MPN UWT1E471MNL1GS
C122: 220uF; CP_Elec_8x10; MPN UWT1E221MNL1GS
C134: 100pF; C_0402_1005Metric; MPN C0402C101J3GACTU
C138: 10uF; C_0805_2012Metric; MPN TMK212BBJ106MGHT
D1, D2, D25, D32: ESD5Z12T1G; D_SOD-523; MPN ESD5Z12T1G
D6, D12: CDBW140-G; D_SOD-123; MPN CDBW140-G
D11: LED GREEN; LED_D3.0mm; MPN 151031VS06000
D15: MM3Z7V5ST1G; D_SOD-323F; MPN MM3Z7V5ST1G
D16, D21: SK56A-LTP; D_SMA; MPN SK56A-LTP
D28, D29: D_Schottky; D_SOD-323; MPN BAT54HT1G
D30, D33: 1N4148WSF-7; D_SOD-323; MPN 1N4148WSF-7
HS1: Heatsink; NONE; MPN 577002B00000G
HS2: Heatsink; NONE; MPN 507302B00000G
J8: Fan; Molex_KK-254_AE-6410-02A_1x02_P2.54mm_Vertical; MPN 22-27-2021
K1: G5NB; Relay_SPST_Omron-G5NB; MPN G5NB-1A4-DC5
NT1, NT2: Net-Tie_2; NetTie-2_SMD_Pad2.0mm
Q1, Q6, Q7, Q11, Q12, Q13, Q16, Q18: BC817; SOT-23; MPN BC817-25,235
Q2: 2N3906; TO-92_Inline; MPN 2N3906-AP
Q4: TIP33C; TO-220-3_Vertical; MPN TIP33C
Q5: FZT1151ATA; SOT-223-3_TabPin2; MPN FZT1151ATA
Q9, Q14: BC807; SOT-23; MPN BC807-40LT1G
Q10, Q15: BSS138; SOT-23; MPN BSS138K-13
R7, R43, R151, R157, R167, R194: 3.3k; R_0402_1005Metric; Tolerance 1%; MPN RC0402FR-073K3L
R9, R166, R173: 0R; R_0603_1608Metric; Tolerance 1%; MPN RC0603JR-070RL
R45, R47: 2k2; R_0603_1608Metric; Tolerance 1%; MPN RC0603FR-072K2L
R50: 15k00; R_0603_1608Metric; Tolerance 0.1%; MPN RT0603BRD0715KL
R71: 680R; R_0805_2012Metric; Tolerance 1%; MPN RC0603FR-07680RL
R72, R95, R145, R155: 10k; R_0603_1608Metric; Tolerance 1%; MPN RC0603FR-0710KL
R82, R96, R131, R143, R154, R159, R169, R176, R195: 1k; R_0603_1608Metric; Tolerance 1%; MPN RC0603FR-071KL
R83, R94, R109, R119, R121, R130, R144, R164: 1k; R_0402_1005Metric; Tolerance 1%; MPN RC0402FR-071KL
R84, R85: 10k00; R_0603_1608Metric; Tolerance 0.1%; MPN RT0603BRD0710KL
R106: 2k10; R_0402_1005Metric; Tolerance 0.1%; MPN ERA-2AEB2101X
R117, R160: 10R; R_0603_1608Metric; Tolerance 1%; MPN RC0603FR-0710RL
R118, R124, R125, R133, R147, R208: 33k; R_0402_1005Metric; Tolerance 1%; MPN RC0402FR-0733KL
R127, R129, R156, R165: 4k3; R_0402_1005Metric; Tolerance 1%; MPN RC0402FR-074K3L
R128, R142, R193: 100k; R_0402_1005Metric; Tolerance 1%; MPN RC0402FR-07100KL
R134: 3k3; R_0402_1005Metric; Tolerance 1%; MPN RC0402FR-073K3L
R137, R148, R149: 0R; R_0402_1005Metric; Tolerance 1%; MPN RC0402JR-070RL
R146, R202: 2k; R_0603_1608Metric; Tolerance 1%; MPN RC0603FR-072KL
R150, R175, R186, R187: 47k; R_0402_1005Metric; Tolerance 1%; MPN RC0402FR-0747KL
R153, R170: 5k6; R_0603_1608Metric; Tolerance 1%; MPN RC0603FR-075K6L
R158: 6k8; R_0603_1608Metric; Tolerance 1%; MPN RC0603FR-076K8L
R161: 1R; R_1210_3225Metric; Tolerance 5%; MPN ERJ-P14J1R0U
R162, R177, R207: 10k; R_0402_1005Metric; Tolerance 1%; MPN RC0402FR-0710KL
R168, R171: 150R; R_0603_1608Metric; Tolerance 1%; MPN RC0603FR-07150RL
R172: 0R; R_0805_2012Metric; Tolerance 1%; MPN RC0805JR-070RL
R198, R199: 3k3; R_0603_1608Metric; Tolerance 1%; MPN RC0603FR-073K3L
R205: 1R00; TO-220-2_Vertical; Tolerance 1%; MPN PWR221T-50-1R00F
TP5, TP12: TestPoint; TestPoint_Loop_D2.60mm_Drill1.6mm_Beaded
TP15: TP; TestPoint_Pad_1.0x1.0mm
TP17, TP26, TP27: TestPoint; TestPoint_Pad_D1.5mm
U24, U28, U29: OPA196; SOT-23-5; MPN OPA196IDBVR
U25: MCP3425A0T-ECH; SOT-23-6_Handsoldering; MPN MCP3425A0T-E/CH
U27: LTC2631ITS8-LM12; SOT-23-8; MPN LTC2631ITS8-LM12#TRMPBF
U33: LM35DZ/NOPB; TO-92L_Inline_Wide; MPN LM35DZ/NOPB
U34, U35, U42, U44: TLV9301IDBVR; SOT-23-5; MPN TLV9301IDBVR
U38: TMP411; SOIC-8_3.9x4.9mm_P1.27mm; MPN TMP411ADR
U39: ADG417BR; SOIC-8_3.9x4.9mm_P1.27mm; MPN ADG417BRZ
U40: AD8422ARZ; SOIC-8_3.9x4.9mm_P1.27mm; MPN AD8422ARZ
U41: TPS3808; SOT-23-6; MPN TPS3808G30DBVR

Connections:
+3V3: C92.1, U25.5 (Vdd); also elsewhere on the board
+12P: C116.1, D12.1 (K), J8.1 (+); also elsewhere on the board
+12V: C119.1, C128.1, C130.1, C141.1, C146.1, R159.1, U24.5 (V+), U28.5 (V+), U29.5 (V+), U33.1 (+VS), U34.5 (V+), U35.5 (V+), U39.4 (V+), U40.8 (Vs+), U42.5 (V+), U44.5 (V+); also elsewhere on the board
+15V: C117.1, D21.1 (K), Q4.2 (C), Q9.2 (E), R117.1, R198.2; also elsewhere on the board
-12V: C129.2, C131.1, U24.2 (V-), U28.2 (V-), U29.2 (V-), U34.2 (V-), U40.5 (Vs-); also elsewhere on the board
/ADC_System/DIV_OUT: R121.2; also elsewhere on the board
/ADC_System/I2C_SCL_3V3: U25.3 (SCL), U27.2 (SCL), U38.8 (SCL); also elsewhere on the board
/ADC_System/I2C_SDA_3V3: U25.4 (SDA), U27.3 (SDA), U38.7 (SDA); also elsewhere on the board
/ADC_System/SENSE_M: K1.2, R9.2, R205.1; also elsewhere on the board
/ADC_System/SENSE_P: C106.1, C122.1, D16.1 (K), D21.2 (A), Q4.3 (E), Q5.3 (E), R131.1, R168.1, R171.2, R205.2; also elsewhere on the board
/CPLD_USB/IO_02: R165.1, U41.5 (SENSE); also elsewhere on the board
/CPLD_USB/IO_09: Q16.3 (C), R194.2; also elsewhere on the board
/CPLD_USB/IO_10: C143.2, Q7.3 (C), R134.2; also elsewhere on the board
/CPLD_USB/IO_12: C144.2, R155.2, R156.1; also elsewhere on the board
/OutputDriver/CLAMP_IN: R124.1, R133.1; also elsewhere on the board
/OutputDriver/C_FB: C106.2, C107.2, C140.2, R50.1, R84.1, U24.4 (-)
/OutputDriver/FAN_CTRL: R94.1, R144.1, TP17.1, U34.1, U34.4 (-)
/OutputDriver/FAN_EN_3V3: R157.1; also elsewhere on the board
/OutputDriver/GND_SENSE: C86.2, R106.2, R109.1, R172.2, U40.1 (-)
/OutputDriver/MUX_CONTROL: Q15.3 (D), R127.2, U39.6
/OutputDriver/OUTPUT: D25.2 (A), D30.1 (K), D33.1 (K), K1.3, R82.1, TP5.1, U39.1
/OutputDriver/VBUFF_SENSE: R154.2, R195.2
/OutputDriver/V_FB: R72.2, R166.1, R169.2, R176.1
GND: C89.2, C90.2, C92.2, C110.2, C124.2, C128.2, C129.1, C135.2, C137.2, C138.2, C143.1, NT1.1, NT2.1, Q2.3 (C), Q7.2 (E), Q15.2 (S), R128.2, R130.2, U25.2 (Vss), U27.4 (GND), U38.5 (GND), U41.2 (GND); also elsewhere on the board
GNDREF: C109.2, C116.2, C117.2, C119.2, C121.2, C122.2, C130.2, C131.2, C141.2, C142.2, C144.1, C146.2, D2.1 (K), D15.2 (A), D16.2 (A), D30.2 (A), D32.2 (A), D33.2 (A), NT1.2, NT2.2, Q6.2 (E), Q10.2 (S), Q11.2 (E), Q12.2 (E), Q13.2 (E), Q16.2 (E), Q18.2 (E), R96.2, R125.2, R131.2, R142.2, R146.2, R156.2, R160.1, R161.1, R172.1, R187.2, R207.2, TP12.1, U33.3 (GND), U35.2 (V-), U39.3 (GND), U39.7 (V-), U40.6 (Ref), U42.2 (V-), U44.2 (V-); also elsewhere on the board
unnamed: C86.1, R85.2, R106.1, U25.1 (Vin+)
unnamed: C90.1, R43.2, R148.1, R149.1, R167.2, TP15.1, TP27.1
unnamed: C96.1, R137.2, R208.1, U29.1
unnamed: C96.2, R207.1, R208.2, U29.4 (-)
unnamed: C107.1, R50.2, R173.1
unnamed: C109.1, C140.1, D1.1 (K), R9.1, R169.1, TP26.1
unnamed: C110.1, R82.2, R176.2, U28.3 (+)
unnamed: C121.1, R154.1, U42.3 (+)
unnamed: C134.1, R164.2, U38.3 (D-)
unnamed: C134.2, R119.2, U38.2 (D+)
unnamed: C137.1, U27.6 (REF)
unnamed: D1.2 (A), D2.2 (A)
unnamed: D6.2 (A), D11.1 (K), K1.1, Q10.3 (D)
unnamed: D11.2 (A), R71.2
unnamed: D12.2 (A), J8.2 (-), Q12.3 (C), Q13.3 (C)
unnamed: D15.1 (K), R159.2, R177.1
unnamed: D25.1 (K), D32.1 (K)
unnamed: D28.1 (K), Q5.1 (B), Q14.2 (E), R170.2, R171.1
unnamed: D28.2 (A), Q14.1 (B), R47.1, R170.1, R202.1
unnamed: D29.1 (K), Q1.1 (B), R45.1, R153.2
unnamed: D29.2 (A), Q1.2 (E), Q4.1 (B), R153.1, R168.2
unnamed: Q1.3 (C), R117.2
unnamed: Q2.1 (E), R119.1
unnamed: Q2.2 (B), R164.1
unnamed: Q6.1 (B), R124.2, R125.1
unnamed: Q6.3 (C), R149.2
unnamed: Q7.1 (B), R133.2
unnamed: Q9.1 (B), R198.1, R199.2
unnamed: Q9.3 (C), R202.2
unnamed: Q10.1 (G), R142.1, R165.2
unnamed: Q11.1 (B), R147.1
unnamed: Q11.3 (C), R148.2
unnamed: Q12.1 (B), R157.2
unnamed: Q13.1 (B), R158.1
unnamed: Q14.3 (C), R160.2
unnamed: Q15.1 (G), R128.1, R129.2
unnamed: Q16.1 (B), R118.1
unnamed: Q5.2 (C), Q18.1 (B), R161.2
unnamed: Q18.3 (C), R199.1
unnamed: R7.2, U27.1 (CA0)
unnamed: R43.1, U27.7 (VOUT)
unnamed: R45.2, R47.2, U24.1
unnamed: R72.1, U40.4 (+)
unnamed: R83.1, U28.4 (-)
unnamed: R95.2, R96.1, U44.4 (-)
unnamed: R109.2, R130.1, U25.6 (Vin-)
unnamed: R118.2, R193.2, U42.1
unnamed: R121.1, U29.3 (+)
unnamed: R129.1, R162.2, U41.1 (~RESET)
unnamed: R84.2, R137.1
unnamed: R143.1, U34.3 (+)
unnamed: R143.2, R187.1, U33.2 (Vout)
unnamed: R144.2, R150.1, U35.3 (+)
unnamed: R145.2, R146.1, U35.4 (-)
unnamed: R147.2, R150.2, R155.1, U35.1
unnamed: R151.2, U27.8 (REFSEL)
unnamed: R158.2, R186.2, U44.1
unnamed: R166.2, U39.8
unnamed: R167.1, U24.3 (+)
unnamed: R173.2, U40.7
unnamed: R175.2, U41.4 (CT)
unnamed: R177.2, R193.1, U42.4 (-)
unnamed: R94.2, R186.1, U44.3 (+)
unnamed: R83.2, R85.1, R195.1, U28.1
USB3V3: C89.1, C138.1, R7.1, R151.1, U27.5 (VCC); also elsewhere on the board
VBUS5V: C124.1, C142.1, D6.1 (K), K1.5, R71.1, R95.1, R127.1, R145.1, R162.1, R175.1, U39.5 (VL), U41.6 (VDD); also elsewhere on the board
VCCIO: C135.1, R134.1, R194.1, U38.1 (V+); also elsewhere on the board

Notes on the sheet:
V = 0.86V
At T = 85, Vo = 850mV
THERMAL PROTECTION DISABLE THE DAC OUTPUT WHEN T > 85C
ENABLE THE RELAY. AFTER FEW ms TURN THE MUX TO RELAY OUT
7.5V
0 to 2.5V
FB = 1/2.5 Vout
V = 0.45
THERMAL PROTECTION TURN ON FAN IF T > 45C
SIGNAL TO CPLD TO INDICATE OVERHEAT
SENSES THE DELTA BETWEEN OUTPUT POS AND NEG PORTS
By adding a R||D in series with the 470uF cap, the inrush current can be limited, when the jack is plugged. R = 1 Ohm 1206, D = schottky 10A, 25V
OUTPUT DAC
OVER VOLTAGE PROTECTION
VOTLAGE MEASUREMENT ADC

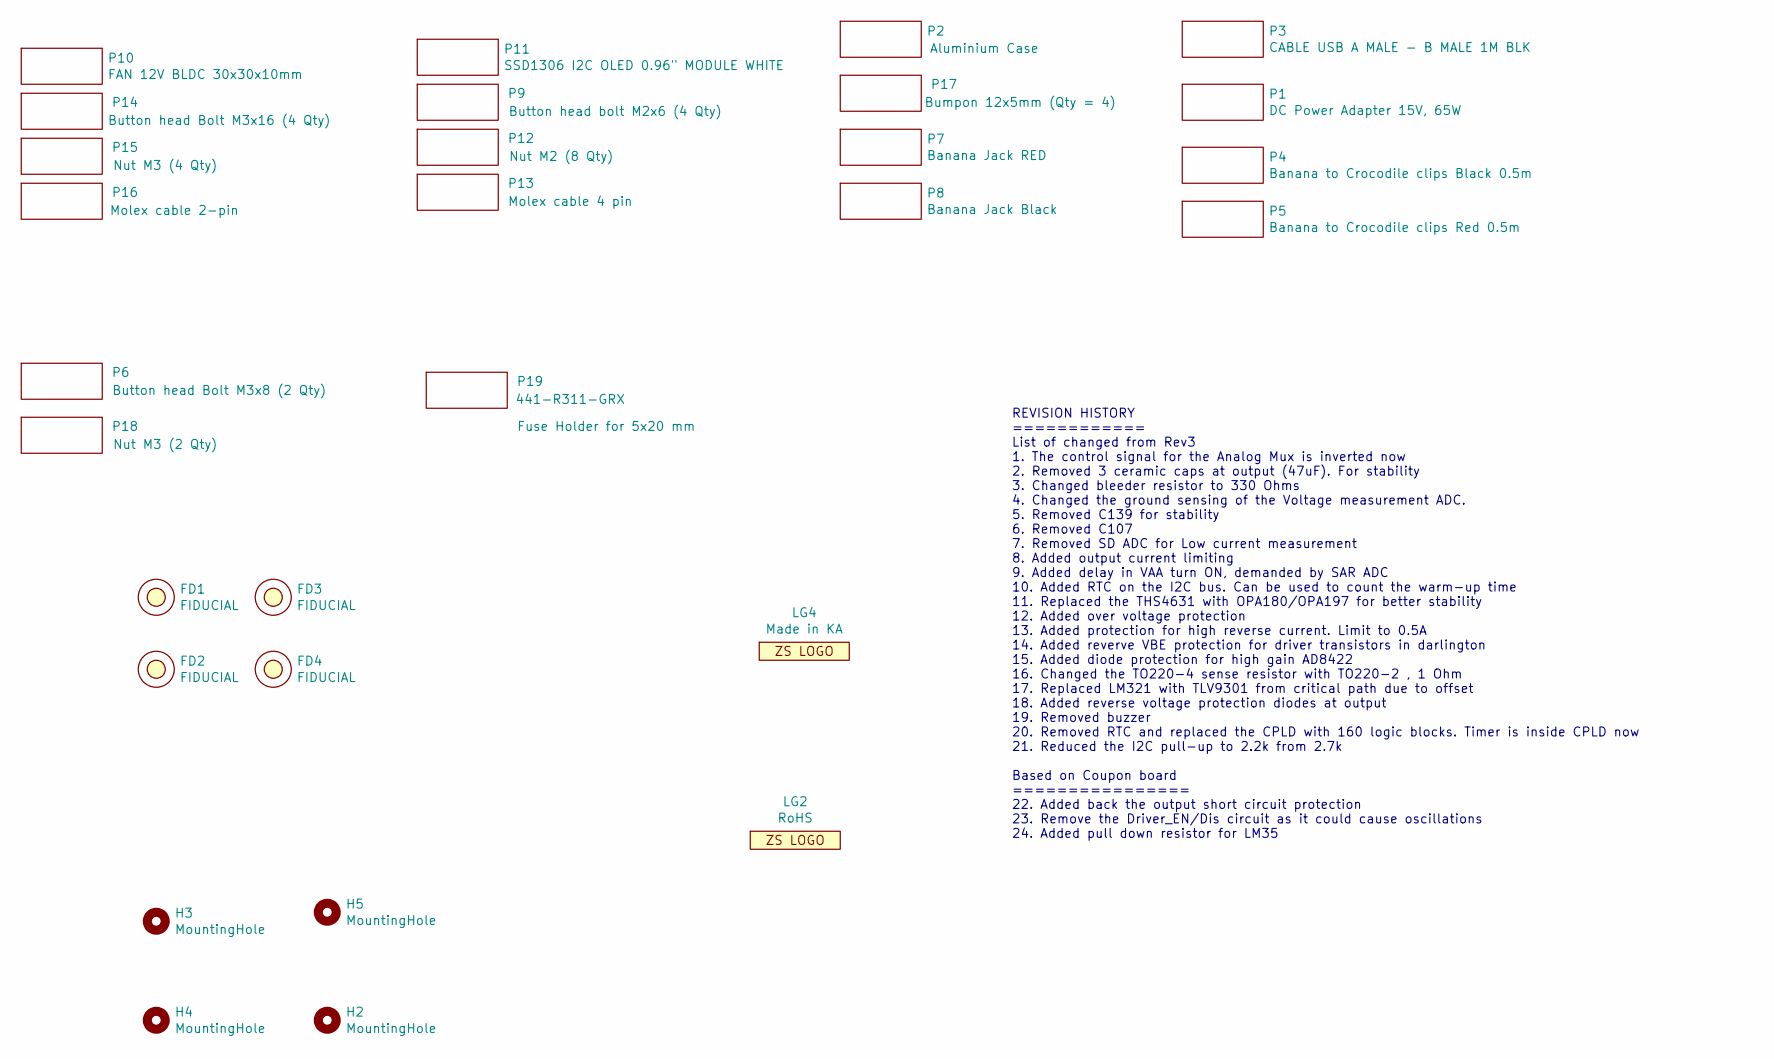
[picture p44: schematic Mechanical.sch, PC-1100X-04]

Parts:
FD1, FD2, FD3, FD4: FIDUCIAL; Fiducial_1mm_Dia_2.54mm_Outer_CopperTop_Paste
H2, H3, H4: MountingHole; MountingHole_3.2mm_M3
H5: MountingHole; MountingHole_2.1mm
LG2: RoHS; Rohs_09mm
LG4: Made in KA; MadeInKA_15mmx6mm
P1: DUMMY; NONE; MPN 418-TRH70A15011E02VI
P2: Aluminium Case; NONE; MPN AK-C-C28
P3: DUMMY; NONE; MPN CBLT-UA-UB-1
P4: DUMMY; NONE; MPN Banana Cable Black
P5: DUMMY; NONE; MPN Banana cable Red
P6: DUMMY; NONE; MPN Button head Bolt M3x8 (2 Qty)
P7: DUMMY; NONE; MPN 111-0102-001
P8: DUMMY; NONE; MPN 111-0103-001
P9: DUMMY; NONE; MPN Button head bolt M2x6 (4 Qty)
P10: DUMMY; NONE; MPN ASB0312LA-CF00
P11: DUMMY; NONE; MPN SSD1306 I2C OLED 0.96\" MODULE WHITE
P12: DUMMY; NONE; MPN Nut M2 (8 Qty)
P13: DUMMY; NONE; MPN Molex cable 4 pin
P14: DUMMY; NONE; MPN Button head Bolt M3x16 (4 Qty)
P15: DUMMY; NONE; MPN Nut M3 (4 Qty)
P16: DUMMY; NONE; MPN Molex cable 2-pin
P17: DUMMY; NONE; MPN Bumpon 12x5mm (Qty = 4)
P18: DUMMY; NONE; MPN Nut M3 (2 Qty)
P19: DUMMY; NONE; MPN 441-R311-GRX

Notes on the sheet:
REVISION HISTORY ============ List of changed from Rev3 1. The control signal for the Analog Mux is inverted now 2. Removed 3 ceramic caps at output (47uF). For stability 3. Changed bleeder resistor to 330 Ohms 4. Changed the ground sensing of the Voltage measurement ADC. 5. Removed C139 for stabil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

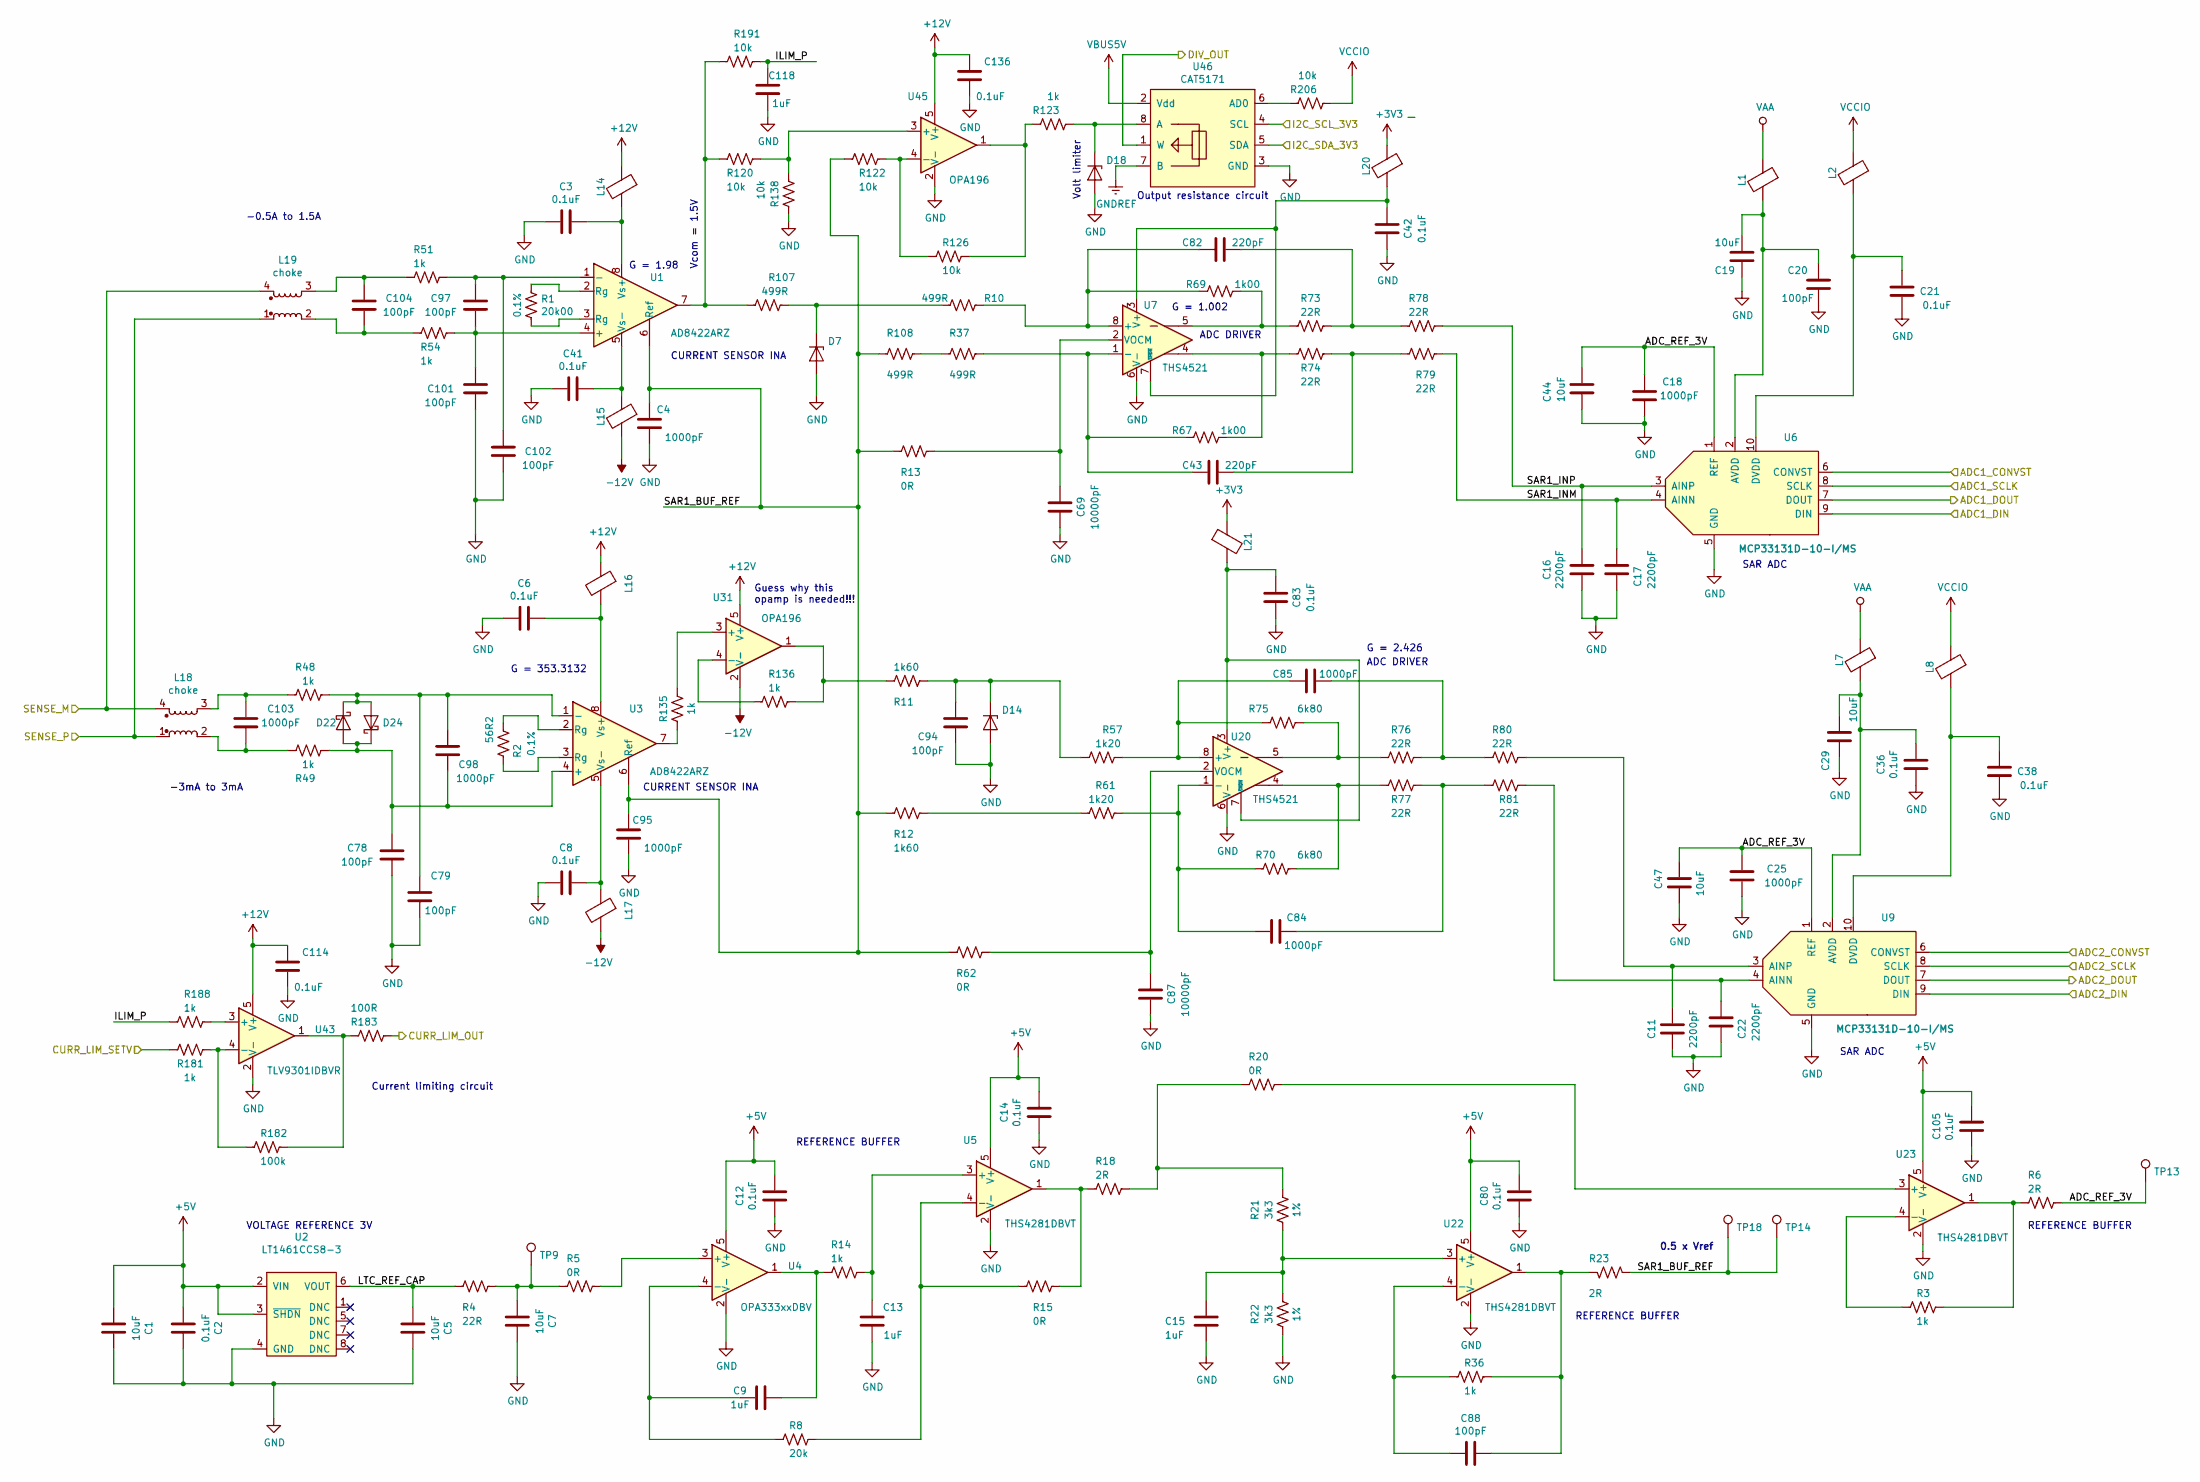
[picture p45: schematic ADC_System.sch, PC-1100X-04]

Parts:
C1, C5, C7, C19, C29, C44, C47: 10uF; C_0805_2012Metric; MPN TMK212BBJ106MGHT
C2, C3, C6, C8, C12, C14, C21, C36, C38, C41, C42, C80, C83, C105, C114, C136: 0.1uF; C_0402_1005Metric; MPN TMK105B7104MV-FR
C4, C18, C25, C84, C85, C95, C98, C103: 1000pF; C_0402_1005Metric; MPN C0402C102J5RAC7411
C9, C13, C15, C118: 1uF; C_0603_1608Metric; MPN TMK107BJ105KA-T
C11, C16, C17, C22: 2200pF; C_0402_1005Metric; MPN C0402C222J3GACTU
C20, C88, C94: 100pF; C_0402_1005Metric; MPN C0402C101J3GACTU
C43, C82: 220pF; C_0402_1005Metric; MPN CC0402JRNPO8BN221
C69, C87: 10000pF; C_0402_1005Metric; MPN TMF105B7103MVHF
C78, C79, C97, C101, C102, C104: 100pF; C_0603_1608Metric; MPN C0603C101K5RACTU
D7: MM3Z5V6T1G; D_SOD-323F; MPN MM3Z5V6T1G
D14: MM3Z4V3T1G; D_SOD-323F; MPN MM3Z4V3T1G
D18: MM3Z4V7ST1G; D_SOD-323F; MPN MM3Z4V7ST1G
D22, D24: D_Schottky; D_SOD-323; MPN BAT54HT1G
L1, L2, L7, L8, L14, L15, L16, L17, L20, L21: FB; L_0805_2012Metric; MPN MPZ2012S601AT000
L18, L19: choke; CommonModeChoke-4Pin_4.5x3.2mm; MPN 744235601
R1: 20k00; R_0603_1608Metric_Pad1.05x0.95mm_HandSolder; Tolerance 0.1%; MPN ERA-3AEB203V
R2: 56R2; R_0603_1608Metric; Tolerance 0.1%; MPN ERA-3AEB56R2V
R3, R14, R36, R48, R49, R51, R54, R135, R136, R181, R188: 1k; R_0402_1005Metric; Tolerance 1%; MPN RC0402FR-071KL
R4, R73, R74, R76, R77, R78, R79, R80, R81: 22R; R_0402_1005Metric; Tolerance 1%; MPN RC0402FR-0722RL
R5, R13, R15, R20, R62: 0R; R_0402_1005Metric; Tolerance 1%; MPN RC0402JR-070RL
R6, R18, R23: 2R; R_0402_1005Metric; Tolerance 1%; MPN RC0402FR-072RL
R8: 20k; R_0402_1005Metric; Tolerance 1%; MPN RC0402FR-0720KL
R10, R37, R107, R108: 499R; R_0402_1005Metric; Tolerance 0.1%; MPN ERA-2AEB4990X
R11, R12: 1k60; R_0402_1005Metric; Tolerance 0.1%; MPN ERA-2AEB162X
R21, R22: 3k3; R_0603_1608Metric; Tolerance 1%; MPN RC0603FR-073K3L
R57, R61: 1k20; R_0402_1005Metric; Tolerance 0.1%; MPN ERA-2AEB122X
R67, R69: 1k00; R_0402_1005Metric; Tolerance 0.1%; MPN ERA-2AEB102X
R70, R75: 6k80; R_0402_1005Metric; Tolerance 0.1%; MPN ERA-2AEB682X
R120, R122, R191, R206: 10k; R_0402_1005Metric; Tolerance 1%; MPN RC0402FR-0710KL
R123: 1k; R_0603_1608Metric; Tolerance 1%; MPN RC0603FR-071KL
R126, R138: 10k; R_0603_1608Metric; Tolerance 1%; MPN RC0603FR-0710KL
R182: 100k; R_0402_1005Metric; Tolerance 1%; MPN RC0402FR-07100KL
R183: 100R; R_0402_1005Metric; Tolerance 1%; MPN RC0402FR-07100RL
TP9, TP13, TP14, TP18: TestPoint; TestPoint_Pad_D1.5mm
U1, U3: AD8422ARZ; SOIC-8_3.9x4.9mm_P1.27mm; MPN AD8422ARZ
U2: LT1461CCS8-3; SOIC-8_3.9x4.9mm_P1.27mm; MPN LT1461CCS8-3#PBF
U4: OPA333xxDBV; SOT-23-5; MPN OPA333AIDBV
U5, U22, U23: THS4281DBVT; SOT-23-5; MPN THS4281DBVR
U6, U9: MCP33131D-10-I/MS; TSSOP-10_3x3mm_P0.5mm; MPN MCP33131D-10-I/MS
U7, U20: THS4521; SOIC-8_3.9x4.9mm_P1.27mm; MPN THS4521IDR
U31, U45: OPA196; SOT-23-5; MPN OPA196IDBVR
U43: TLV9301IDBVR; SOT-23-5; MPN TLV9301IDBVR
U46: CAT5171; SOT-23-8; MPN CAT5171TBI-50GT3

Connections:
+3V3: L20.1, L21.1; also elsewhere on the board
+5V: C1.2, C2.2, C12.1, C14.1, C80.1, C105.1, U2.2 (VIN), U2.3 (~SHDN), U4.5 (V+), U5.5 (V+), U22.5 (V+), U23.5 (V+); also elsewhere on the board
+12V: C114.1, C136.1, L14.1, L16.1, U31.5 (V+), U43.5 (V+), U45.5 (V+); also elsewhere on the board
-12V: L15.2, L17.2, U31.2 (V-); also elsewhere on the board
/ADC_System/ADC1_CONVST: U6.6 (CONVST); also elsewhere on the board
/ADC_System/ADC1_DIN: U6.9 (DIN); also elsewhere on the board
/ADC_System/ADC1_DOUT: U6.7 (DOUT); also elsewhere on the board
/ADC_System/ADC1_SCLK: U6.8 (SCLK); also elsewhere on the board
/ADC_System/ADC2_CONVST: U9.6 (CONVST); also elsewhere on the board
/ADC_System/ADC2_DIN: U9.9 (DIN); also elsewhere on the board
/ADC_System/ADC2_DOUT: U9.7 (DOUT); also elsewhere on the board
/ADC_System/ADC2_SCLK: U9.8 (SCLK); also elsewhere on the board
/ADC_System/ADC_REF_3V: C18.1, C25.1, C44.1, C47.1, R6.2, TP13.1, U6.1 (REF), U9.1 (REF)
/ADC_System/CURR_LIM_SETV: R181.1; also elsewhere on the board
/ADC_System/DIV_OUT: U46.1 (W); also elsewhere on the board
/ADC_System/I2C_SCL_3V3: U46.4 (SCL); also elsewhere on the board
/ADC_System/I2C_SDA_3V3: U46.5 (SDA); also elsewhere on the board
/ADC_System/ILIM_P: C118.1, R188.1, R191.2
/ADC_System/LTC_REF_CAP: C5.2, R4.1, U2.6 (VOUT)
/ADC_System/SAR1_BUF_REF: C4.1, C95.1, R12.1, R13.1, R23.1, R62.1, R108.1, R122.1, TP14.1, TP18.1, U1.6 (Ref), U3.6 (Ref)
/ADC_System/SAR1_INM: C17.1, R79.2, U6.4 (AINN)
/ADC_System/SAR1_INP: C16.1, R78.2, U6.3 (AINP)
/ADC_System/SENSE_M: L18.4, L19.4; also elsewhere on the board
/ADC_System/SENSE_P: L18.1, L19.1; also elsewhere on the board
/OutputDriver/CLAMP_IN: R183.1; also elsewhere on the board
GND: C1.1, C2.1, C3.2, C4.2, C5.1, C6.2, C7.1, C8.2, C11.2, C12.2, C13.2, C14.2, C15.2, C16.2, C17.2, C18.2, C19.2, C20.2, C21.2, C22.2, C25.2, C29.2, C36.2, C38.2, C41.2, C42.2, C44.2, C47.2, C69.2, C78.1, C79.1, C80.2, C83.2, C87.2, C94.2, C95.2, C101.1, C102.1, C105.2, C114.2, C118.2, C136.2, D7.2 (A), D14.2 (A), D18.2 (A), R22.2, R138.2, U2.4 (GND), U4.2 (V-), U5.2 (V-), U6.5 (GND), U7.6 (V-), U9.5 (GND), U20.6 (V-), U22.2 (V-), U23.2 (V-), U43.2 (V-), U45.2 (V-), U46.3 (GND); also elsewhere on the board
GNDREF: U46.7 (B); also elsewhere on the board
unnamed: C3.1, L14.2, U1.8 (Vs+)
unnamed: C6.1, L16.2, U3.8 (Vs+)
unnamed: C7.2, R4.2, R5.1, TP9.1
unnamed: C8.1, L17.1, U3.5 (Vs-)
unnamed: C9.1, R14.1, U4.1
unnamed: C9.2, R8.1, U4.4 (-)
unnamed: C11.1, R80.2, U9.3 (AINP)
unnamed: C13.1, R14.2, U5.3 (+)
unnamed: C15.1, R21.2, R22.1, U22.3 (+)
unnamed: C19.1, C20.1, L1.2, U6.2 (AVDD)
unnamed: C21.1, L2.2, U6.10 (DVDD)
unnamed: C22.1, R81.2, U9.4 (AINN)
unnamed: C29.1, C36.1, L7.2, U9.2 (AVDD)
unnamed: C38.1, L8.2, U9.10 (DVDD)
unnamed: C41.1, L15.1, U1.5 (Vs-)
unnamed: C42.1, L20.2, U7.3 (V+), U7.7 (~SHDN)
unnamed: C43.1, R74.2, R79.1
unnamed: C43.2, R37.2, R67.1, U7.1 (-)
unnamed: C69.1, R13.2, U7.2 (VOCM)
unnamed: C78.2, C98.1, D22.2 (A), D24.1 (K), R49.2, U3.4 (+)
unnamed: C79.2, C98.2, D22.1 (K), D24.2 (A), R48.2, U3.1 (-)
unnamed: C82.1, R73.2, R78.1
unnamed: C82.2, R10.2, R69.1, U7.8 (+)
unnamed: C83.1, L21.2, U20.3 (V+), U20.7 (~SHDN)
unnamed: C84.1, R77.2, R81.1
unnamed: C84.2, R61.2, R70.1, U20.1 (-)
unnamed: C85.1, R76.2, R80.1
unnamed: C85.2, R57.2, R75.1, U20.8 (+)
unnamed: C87.1, R62.2, U20.2 (VOCM)
unnamed: C88.1, R23.2, R36.2, U22.1
unnamed: C88.2, R36.1, U22.4 (-)
unnamed: C94.1, D14.1 (K), R11.2, R57.1
unnamed: C97.1, C101.2, R54.2, U1.4 (+)
unnamed: C97.2, C102.2, R51.2, U1.1 (-)
unnamed: C103.1, L18.2, R49.1
unnamed: C103.2, L18.3, R48.1
unnamed: C104.1, L19.2, R54.1
unnamed: C104.2, L19.3, R51.1
unnamed: D7.1 (K), R10.1, R107.2
unnamed: D18.1 (K), R123.1, U46.8 (A)
unnamed: R1.1, U1.2 (Rg)
unnamed: R1.2, U1.3 (Rg)
unnamed: R2.1, U3.2 (Rg)
unnamed: R2.2, U3.3 (Rg)
unnamed: R3.1, U23.4 (-)
unnamed: R3.2, R6.1, U23.1
unnamed: R5.2, U4.3 (+)
unnamed: R11.1, R136.2, U31.1
unnamed: R12.2, R61.1
unnamed: R8.2, R15.1, U5.4 (-)
unnamed: R15.2, R18.1, U5.1
unnamed: R18.2, R20.1, R21.1
unnamed: R20.2, U23.3 (+)
unnamed: R67.2, R74.1, U7.4
unnamed: R69.2, R73.1, U7.5
unnamed: R70.2, R77.1, U20.4
unnamed: R75.2, R76.1, U20.5
unnamed: R107.1, R120.1, R191.1, U1.7
unnamed: R37.1, R108.2
unnamed: R120.2, R138.1, U45.3 (+)
unnamed: R122.2, R126.1, U45.4 (-)
unnamed: R123.2, R126.2, U45.1
unnamed: R135.1, U31.3 (+)
unnamed: R135.2, U3.7
unnamed: R136.1, U31.4 (-)
unnamed: R181.2, R182.1, U43.4 (-)
unnamed: R182.2, R183.2, U43.1
unnamed: R188.2, U43.3 (+)
unnamed: R206.2, U46.6 (AD0)
VAA: L1.1, L7.1; also elsewhere on the board
VBUS5V: U46.2 (Vdd); also elsewhere on the board
VCCIO: L2.1, L8.1, R206.1; also elsewhere on the board

Notes on the sheet:
G = 1.98
0.5 x Vref
G = 1.002
G = 353.3132
G = 2.426
-3mA to 3mA
-0.5A to 1.5A
Vcom = 1.5V
Volt limiter
Guess why this opamp is needed!!!
Current limiting circuit
Output resistance circuit
VOLTAGE REFERENCE 3V
REFERENCE BUFFER
ADC DRIVER
SAR ADC
CURRENT SENSOR INA

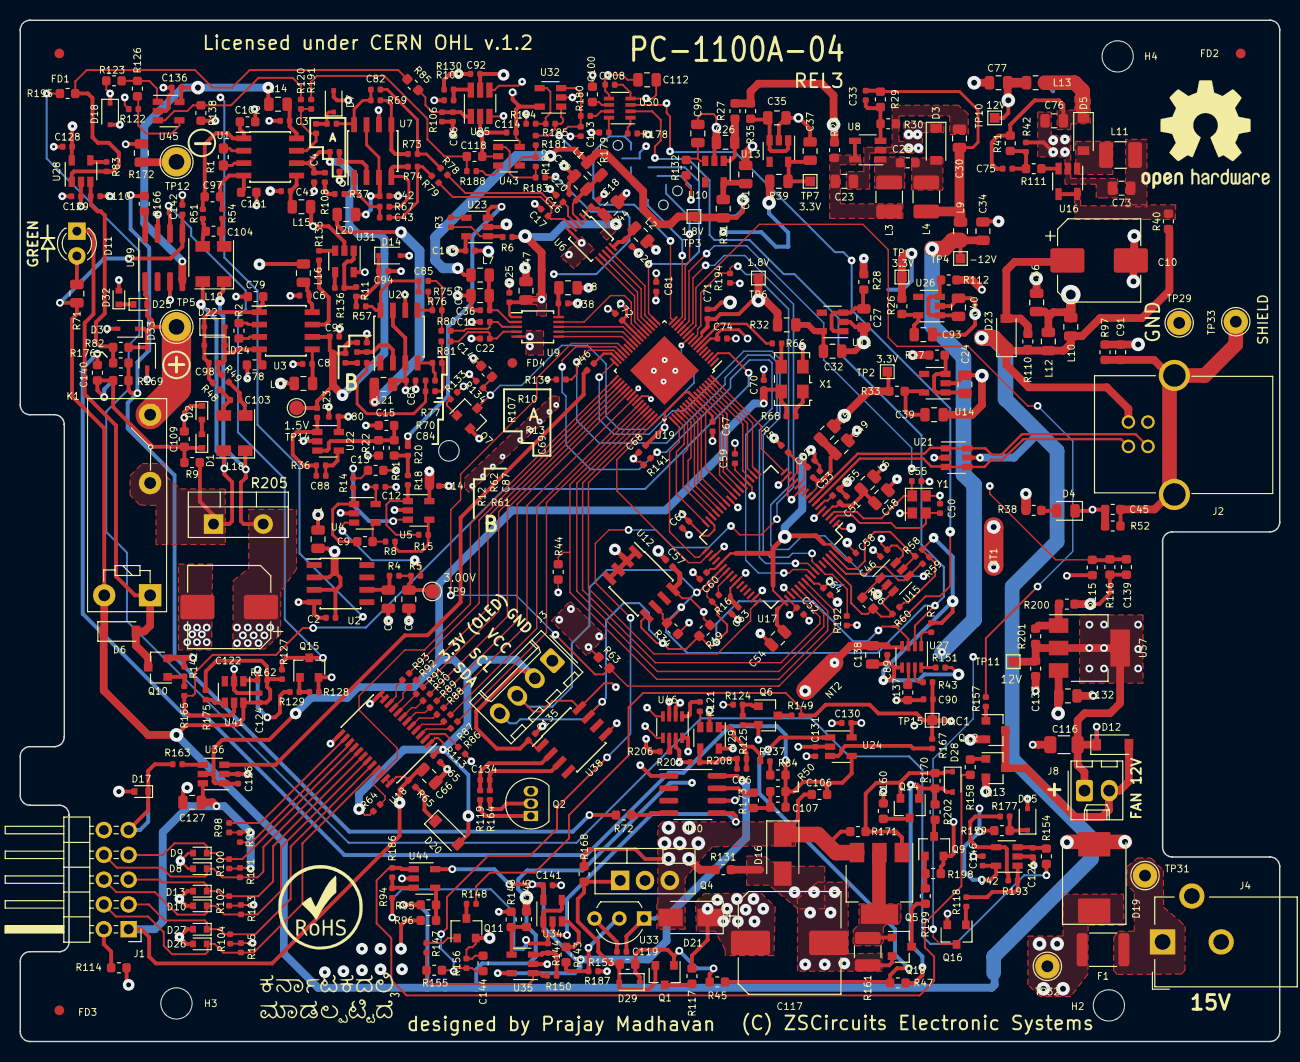
[picture p46: board PC-1100X.kicad_pcb from above]

Board: 4 copper layers, 129.0 x 104.6 mm, 528 parts (0 on the bottom side), 290 nets.
