zscircuits/zs1100a/(commit log)

2020-12-06 Most files uploaded
    Hardware design files, User Guide, sDoc etc
    [ADC_System.sch, Mechanical.sch, OutputDriver-bck.sch, OutputDriver.sch, PC-1100A-04-BOM-ASSY.xlsx, PC-1100X-04-FULL-BOM.csv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]
2020-12-06 V7
    Removed the ZSCircuits logo from the enclosure
    [ZS-1100-A-AK-C-C28_4_SIDE-SZOMK-V7.dxf]
2021-02-15 Ver 2.7.1.1
    1. Peiodically flushed the I2C data to prevent overflow. Useful across very long runs spanning several hours.
2021-02-16 Ver 2.7.11
    Minor fix to flush I2C data periodically.
