zscircuits/zs1100a/(notices)

Notices in the files:
Hardware/PCB/KiCAD/PC-1100X.kicad_pcb:
Licensed under CERN OHL v.1.2
